martinpiper/BombJack/PiJack2/README.md

* This code is originally from these repos:
	https://github.com/fbergama/pigfx
	Specifically: https://github.com/fbergama/pigfx/tree/e4579a8653ec4d43ec5b5b94d9fd740d67e02359
	Needed https://github.com/rsta2/uspi/tree/2d6f33c6daa052137a0fe05bb74026d795b65b9e to be extracted to uspi\

* This is an attempt to use some bare metal code to try to service the GPIO pins quickly enough that all requests from the C64 can be captured in parallel, using the full 10 bits from the user port, without any extra latching logic.

* This code was used because it usefully demonstrates how to render to the screen and also service UART/GPIO signals in an interrupt.
* The plan is to strip the code, add specific C64 signal handling, and then incorporate emulated graphics display from the C64.

* Tweaks made from the versions in source control up to this version:
	Remove git command usage in "make.bat" and replace with:
	set GIT_DESCRIBE=1234567890
	set BUILD_VERSION=1234567890

* To build:

	"C:\Users\Martin Piper\Downloads\gcc-arm-none-eabi-10-2020-q4-major-win32\gcc-arm-none-eabi-10-2020-q4-major\bin\gccvar.bat"
	cd /d C:\work\BombJack\PiJack2
	Then...
	This will make all img files in bin\
	cls && makeall
	This makes a Pi0 compatible elf
	cls && make 1
	"c:\Program Files\qemu\qemu-system-arm.exe" -s -kernel pigfx.elf -cpu arm1176 -m 512 -M raspi0 -no-reboot -serial stdio -append ""
	"c:\Program Files\qemu\qemu-system-arm.exe" -s -kernel pigfx.elf -cpu arm1176 -m 512 -M raspi1ap -no-reboot -serial stdio -append ""

	This starts a qemu monitor on port 55555
	"c:\Program Files\qemu\qemu-system-arm.exe" -s -kernel pigfx.elf -cpu arm1176 -m 512 -M raspi0 -no-reboot -serial stdio -append "" -monitor tcp::55555,server,nowait

	To copy to the SD card, make sure it is NOT THE RECOVERY drive:
		copy bin\kernel.img g: /y
		copy bin\kernel.img f: /y
		
	Backup kernel.img files are in the backups folder.
	
	"binaryData.bin" is a large amount of data to send to the C64, bitmap and sound data basically
		See real_binary_binaryData_bin_start
		
	onPC2Rise should be sending a large chunk of binary data on _PC and reset the pointer on _PA2
	Note *InsertVolumeEvery* is an interleave data test because reading PIN_SERIALATN (or PIN_SP1) seems to be quite slow, so changes being sent are not received in sync with _PC, which lead to bitmap data reading some bytes of sample and vice versa.
		Corresponding interleaved data being sent is needed
			kBitmapDrawWidth = 22
			kBitmapDrawHeight = 16
		For each frame of data, use sDataCount:
			Every kBitmapDrawWidth skipping kBitmapDrawHeight, start of column, for 8 rows
			Then every 24 bytes for kBitmapDrawWidth*kBitmapDrawHeight*2
			Then for 24 samples
		>> As expected, sync issues, hard to predict what bytes need extra audio
			See: "// ????!!!!" The number is out by 1
	When the C64 is playing the video, there seems to be a momentary block of currupt video which then gets back in sync again. This happens at the same point regardless of the data.
		Is this a memory corruption in the linked binary? Calculate a CRC for the whole video data and display it on the Pi to find out.
		Otherwise it's a corruption happening while sending to the C64?

>> qemu and gpio emulation: https://cs.unibo.it/~davide.berardi6/post/20201204-1.html
	"Qemu offers a debug protocol, documented in [3], qtest." ...
>> https://stackoverflow.com/questions/60764018/how-to-connect-gpio-in-qemu-emulated-machine-to-an-object-in-host
>> https://phwl.org/2021/emulated-ARM-Linux-with-Buildroot-and-QEMU/

* TODO:
	* Done: Remember that the PS2 keyboard support needs to be removed, this is using the GPIO, so that code can be an example of how to read the GPIO directly
		handlePS2ClockEvent
		Note time_microsec()
		uart_buffer_start == uart_buffer_end
		Note GPIO code in initPS2
	* Done: Strip code, remove USPI as it isn't needed.
		Tested in QEmu
	* Done: Add simple code, one GPIO IRQ, to read values from C64, like in PiJack
	* Done: Store in volatile ring buffer, also like in PiJack
	* Done: Display on the terminal display
		Note: initialize_framebuffer(384, 264, 8);
	* Done: Validate that the screen can be updated quickly enough with the GPIO IRQ taking priority
	
	* Done: When the C64 is sending data and the display is rendering, only the top part of the screen is showing colour updates. The raster timing is consistent.
		This indicates the timing is off? but the screen redraw does update at 60 fps, the full screen of pixels is updated
		The data cache is invalidated between frames, and also when a byte arrives
		What is going in here? :)
		* "if (frameTime > 7285)" shows the problem on real hardware quite well. The split should be quite stable in the middle of the screen, however it is not...
			This indicates there is an issue with the timing of pixel writes and the number it can process
		* I think I'm going to capture a frame's worth of timed data from the C64 then draw the screen one frame behind instead
		* C64UserPort24Bit_getNext will need to return time captured and also have a filter time based on the current frameStartTime
			* It will need to capture raw time_microsec() for each event
			* Don't flush cache in gpio irq, instead flush caches just before rendering

	* Done: Add proper 32 bit user port interface return values, with incrementing address
	* Proper video rendering handling, port the java code...
		* Added DisplayBombJack.h
		* Note there is no libstdc++ so new won't work, neither will stack allocated class initialisation, so an explicit init() method is needed for each class
		** Eek, it looks like the code is updating the graphics too slowly... Is the cache off or something?
			Note: enable "// Debug enable the display and show some raster bars" then test the rendering speed on the real hardware compared to qemu...
				Added and enabled setup_cache(), no effect.
				Try: https://www.raspberrypi.org/forums/viewtopic.php?t=219212 , also no effect
	* Done: Strip PS2 and UART code
	* GPIO IRQ on separate higher priority core compared to the video rendering
	* Audio output over HDMI with background mixing IRQ on separate core compared to the GPIO IRQ core
	* Instead added: SIMPLE_MODE
		This just uses the terminal output mode and displays whatever the C64 sends. Example code in VideoHardware main7.a

* Bidirectional level shifter: https://www.sparkfun.com/products/12009

# PiGFX 
## Raspberry Pi graphics card / ANSI terminal emulator

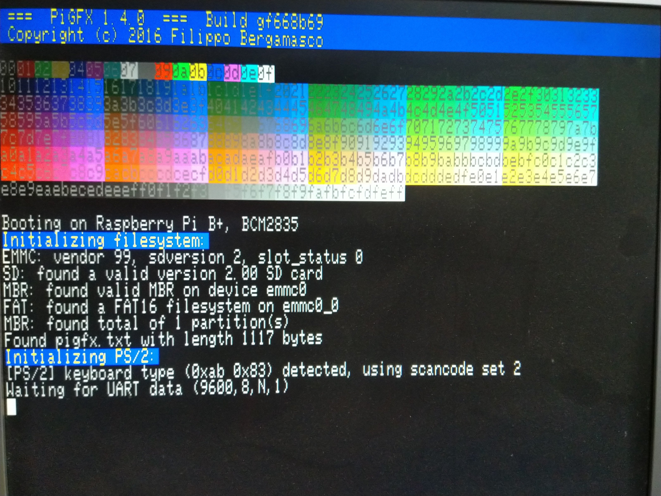
[picture p6: PiJack2/doc/scr1.jpg]


PiGFX is a bare metal kernel for the Raspberry Pi that implements a basic ANSI
terminal emulator with the additional support of some primitive graphics
functions. It can be driven by pushing characters to the raspi UART. Additional
functions like changing text color, moving the cursor or clear the screen can
be invoked via ANSI escape codes.  The result is that you can easily add an
HDMI display output to your embedded project without the hassle of directly
generate the video signal.

This work is inspired by [Spencer's
project](https://hackaday.io/project/9567-5-graphics-card-for-homebrew-z80)
that aims to create a cheap graphics card and keyboard interface to its
homebrew Z80 computer. PiGFX has the advantage of removing the fuss of having a
full-featured Linux system running on your raspi. This dramatically decreases
the boot time, lets the system be more customizable and, of course, adds a lot
of fun :) 

*UPDATE*: Thanks to the [uspi](https://github.com/rsta2/uspi) bare-metal USB
driver PiGFX now support an external USB keyboard as input device. Anything
typed will be automatically sent to raspi UART Tx0 (pin 8, GPIO 14).

*UPDATE*: (2018 Nov. by F. Pierot) Added display modes, fonts, tabulation set... See [2018 Nov. modifications](README_ADD.md).

*UPDATE*: (2020 by Ch. Lehner) Added new graphic features and configurable baudrate. Fixed some bugs. Ported to Raspberry Pi 2, 3 and 4. Also included the ability to read a config file on the SD card. Also added support for PS/2 keyboards.

By now this is a work in progress with a minimum set of features implemented so
expect that more functionalities will be added from time to time.

PiGFX should be working on all Pi models from generation 1 to generation 4. However there is no USB support on the model 4. It's tested on the following models:

- Pi Zero
- Pi Zero W
- Pi B
- Pi B+
- Pi 2B
- Pi 3B
- Pi 4B

Here is a preliminary TODO list of what I plan to add in the future:

- ✔ Add support for USB or Ps2 keyboard
- ✔ Add some graphics primitives like lines
- ✔ Add some more graphics primitives (circles, rectangles etc.)
- ✔ Let the resolution being configurable without recompiling
- ✔ Port to Raspberry Pi Generation 2/3/4
- ✔ Load configuration from SD card
- ✔ Support for PS/2 keyboard
- ✔ Implement some kind of sprite handling with collision detection
- Implement double buffering
- Load bitmap fonts directly from the SD card
- Implement a 8bit interface
- Support for USB / PS/2 Mouse

## How to run

1. Format an SD-card: you need one 1 GB partition using the FAT or FAT32 system. 
Other formats won't boot, and a bigger size is useless. Avoid 64GB+ cards as 
they tend to cause problems to PI. A 32GB or 16GB card is ok as long as you 
format only 1 or 2 GB with FAT or FAT32.

2. Copy all ```bin/*.img``` to the root of the SD card along with the files
   ```start.elf```, ```start4.elf``` and ```bootcode.bin``` that are commonly [distributed with
the Raspberry Pi](https://github.com/raspberrypi/firmware/tree/master/boot).

3. Copy ```bin/pigfx.txt``` to the root of the SD card. Edit the file for your
   needs. If you have a config.txt on the SD card, delete it.

4. Insert the card and reboot the Pi.

As soon as your raspi is turned on, the boot screen and other informations 
should be displayed as a 640x480 @ 60hz video stream from the HDMI interface. 
After that, PiGFX awaits anything coming from the serial line. Any data
received from the UART is immediately displayed in a terminal-like fashion (ie.
it automatically scrolls once you reach the bottom of the screen, etc.).

You may need to reset your computer before PiGFX displays anything coming from it.
 
### Test inside QEMU

PiGFX can be emulated with [QEMU](http://wiki.qemu.org/Main_Page). Just
download/compile/install the [rpi Torlus
branch](https://github.com/Torlus/qemu/tree/rpi) and launch 

```
$ make run
```

in the PiGFX root folder.

## UART Physical connection

|Pin   | Function
|---   |---
|8     | UART Tx0 (GPIO 14).  Keyboard output
|10    | UART Rx0 (GPIO 15). Connect this pin to your device transmit pin.

***Note: Please be aware that all Raspberry Pi models accept levels between 0 and 3v3. Be sure to provide an appropriate level shifter to match your output***

UART communication expects the baudrate configured in pigfx.txt, 8 bit data, 1 bit
stop and no parity.

## PS/2 keyboard
Be aware that USB support is disabled, if a PS/2 keyboard is detected during boot. This increases boot time a lot.

### Physical connection to the Pi
This is the male connector at the keyboard cable.
<img src="doc/ps2.jpg" width="30%" />
<img src="doc/gpio.png" width="80%" />

Most keyboards seem to work if powered with 3.3V. However if your keyboard does not and needs 5V, make sure you use a bidirectional level shifter between the Raspberry Pi and your keyboard on data and clock. If you bring 5V to the GPIO you will destroy the Pi.

|PS/2 Pin |Pi Pin | Function
|-------  |-----  |---------
|1        |3      | PS/2 Data (GPIO 2)
|3        |9      | Ground
|4        |1      | Power to keyboard
|5        |5      | PS/2 Clock (GPIO 3)

## Terminal ANSI Codes

The following escape sequences can be used to further control the terminal
behaviour

|Code                  | Command
|---                   | ---
| \ESC[?25l           | Cursor invisible
| \ESC[?25h           | Cursor visible
| \ESC[H              | Move to 0-0
| \ESC[s              | Save the cursor position 
| \ESC[u              | Move cursor to previously saved position 
| \ESC[-Row-;-Col-H   | Move to -Row-,-Col-
| \ESC[0K             | Clear from cursor to the end of the line
| \ESC[1K             | Clear from the beginning of the current line to the cursor 
| \ESC[2K             | Clear the whole line 
| \ESC[2J             | Clear the screen and move the cursor to 0-0 
| \ESC[-n-A           | Move the cursor up -n- lines
| \ESC[-n-B           | Move the cursor down -n- lines
| \ESC[-n-C           | Move the cursor forward -n- characters
| \ESC[-n-D           | Move the cursor backward -n- characters
| \ESC[0m             | Reset color attributes (white on black) 
| \ESC[38;5;-n-m      | Set foreground color to -n- (0-255) 
| \ESC[48;5;-n-m      | Set background color to -n- (0-255) 

Where ```\ESC``` is the binary character ```0x1B``` and ```-n-```,
```-Row-```, ```-Col-``` is any sequence of numeric characters like ```123```.

Additionally, PiGFX implements the following custom codes:

Code                              | Command
---                               | ---
| \ESC[#-x0-;-y0-;-x1-;-y1-l     | Draw a line from -x0-;-y0- to -x1-;-y1-
| \ESC[#-x0-;-y0-;-x1-;-y1-r     | Fill a rectangle with top-left corner at -x0-;-y0- and bottom-right at -x1-;-y1-

See [terminal_codes](doc/terminal_codes.txt) for a complete list of supported commands.

## Color palette

See [Here](https://en.wikipedia.org/wiki/File:Xterm_256color_chart.svg) for a
reference of the provided xterm color palette. This is the default palette used by PiGFX.

A RGB pixel can be converted to this palette by the following formula:

Pixel = 16 + (round(R / 255 * 5) * 36) + (round(G / 255 * 5) * 6) + round(B / 255 * 5)

Using a different color palette is possible. It can be switched with a control code, see [terminal_codes](doc/terminal_codes.txt).

Possible palettes are Xterm, VGA and C64. PiGFX always uses 256 colors, so the unused colors in a palette remain black.

It's also possible to load a custom color palette with a specific control code.

## Bitmap handling
A maximum of 128 bitmaps can be loaded to the PiGFX, either as list of binary pixels, list of ASCII decimal encoded pixels or list of ASCII hex encoded pixels. All of these can be RLE compressed. Loaded bitmaps can then be put onto the background. A transparent color can be specified before drawing a bitmap, these pixels won't be drawn in transparent mode. RLE compression expects a list of 2 values: first one is the pixel color, second one is the number of pixels to draw with this color.

See [terminal_codes](doc/terminal_codes.txt) for the specific commands.

There are a few examples in [this directory](sprite/sample). 

## Sprite handling

Once a bitmap is loaded, it can be used to draw a maximum of 256 sprites. A sprite is an object which is movable over the background. If a sprite is moved or removed, the previous background gets restored. If the sprite is manipulated by a bitmap or a different sprite, this state remains until it gets moved or removed. The sprite is then redrawn and the previous background restored. Moving a sprites, which is overlaped by another leads to artefacts.

Sprites can be drawn solid or with a transparent color. A drawn sprite keeps its settings (solid/transparent) and even the tranparent color until it gets removed.

Once a sprite is active, you should not manipulate or reload its bitmap source, otherwise the sprite changes to this new bitmap source if it gets moved.

Animations could be realized by redefining the sprite with a different bitmap source.

There's a [example](shapes/sample/anim_dinos.txt) for a moving dinosaur (after first loading them in hex or binary).

## Graphics performance

Since we have cache enabled now on the Pi, the speed is more or less the same on every model. In most cases it's probably faster to not enable DMA.

Graphics which are drawn on a multiple of 4 pixels x-position draw faster than on a multiple of 2 or 1. You will also get more speed if your image has a width of a multiple of 4. Drawing solid is faster than drawing transparent.

This is a table that shows the time for drawing a 400x300 pixel image on different x-positions. This is an example for getting an idea.

|Pi Gen.  |Aligned 4 px |Aligned 2 px |unaligned |DMA enabled
|-------  |------------ |------------ |--------- |-----------
|1 (zero) |4.7ms        |9.3ms        |10.5ms    |3.9ms
|2        |1.9ms        |2.1ms        |2.6ms     |5.2ms
|3        |2.2ms        |2.7ms        |3.8ms     |5.2ms
|4        |0.9ms        |1.6ms        |3.3ms     |4.9ms

## Collision detection

At the time a sprite is defined, the borders of the sprite are used for detecting collisions with other sprites, so this is always a rectangle. A collision is reported if 2 sprites touch or overlap. Collisions with lower sprite indexes are detected first.

Collision detection takes place at the time a sprite is defined or moved. This sprite is checked against all other active sprites. All detected collisions are reported.

A collision is reported as a keyboard input with this syntax: \ESC[#-idx1-;-idx2-c where -idx1- is the sprite index you just defined or moved and -idx2- is the sprite it collides with.

## Compiling on Mac / Linux

To compile you will need to install a GNU ARM cross compiler toolchain and
ensure that  ```arm-none-eabi-gcc```, ```arm-none-eabi-as```
```arm-none-eabi-ld``` and ```arm-none-eabi-objcopy``` are in your PATH.

At this point, just run:

```
$ ./makeall
```

in the PiGFX root directory. The project should compile with the 2019 version
of the toolchain.

## Compiling on Windows

To compile you will need to install a [GNU ARM cross compiler toolchain](https://developer.arm.com/tools-and-software/open-source-software/developer-tools/gnu-toolchain/gnu-rm/downloads) and
ensure that  ```arm-none-eabi-gcc```, ```arm-none-eabi-as```
```arm-none-eabi-ld``` and ```arm-none-eabi-objcopy``` are in your PATH.

You'll also need the [git executable git.exe](https://git-scm.com/download/win) in your PATH.

At this point, just run:

```
> makeall
```

## License

The MIT License (MIT)

Copyright (c) 2016-2020 Filippo Bergamasco.

Permission is hereby granted, free of charge, to any person obtaining a copy
of this software and associated documentation files (the "Software"), to deal
in the Software without restriction, including without limitation the rights
to use, copy, modify, merge, publish, distribute, sublicense, and/or sell
copies of the Software, and to permit persons to whom the Software is
furnished to do so, subject to the following conditions:

The above copyright notice and this permission notice shall be included in
all copies or substantial portions of the Software.

THE SOFTWARE IS PROVIDED "AS IS", WITHOUT WARRANTY OF ANY KIND, EXPRESS OR
IMPLIED, INCLUDING BUT NOT LIMITED TO THE WARRANTIES OF MERCHANTABILITY,
FITNESS FOR A PARTICULAR PURPOSE AND NONINFRINGEMENT. IN NO EVENT SHALL THE
AUTHORS OR COPYRIGHT HOLDERS BE LIABLE FOR ANY CLAIM, DAMAGES OR OTHER
LIABILITY, WHETHER IN AN ACTION OF CONTRACT, TORT OR OTHERWISE, ARISING FROM,
OUT OF OR IN CONNECTION WITH THE SOFTWARE OR THE USE OR OTHER DEALINGS IN
THE SOFTWARE.
