martinpiper/BombJack/original/Bottom.jpg

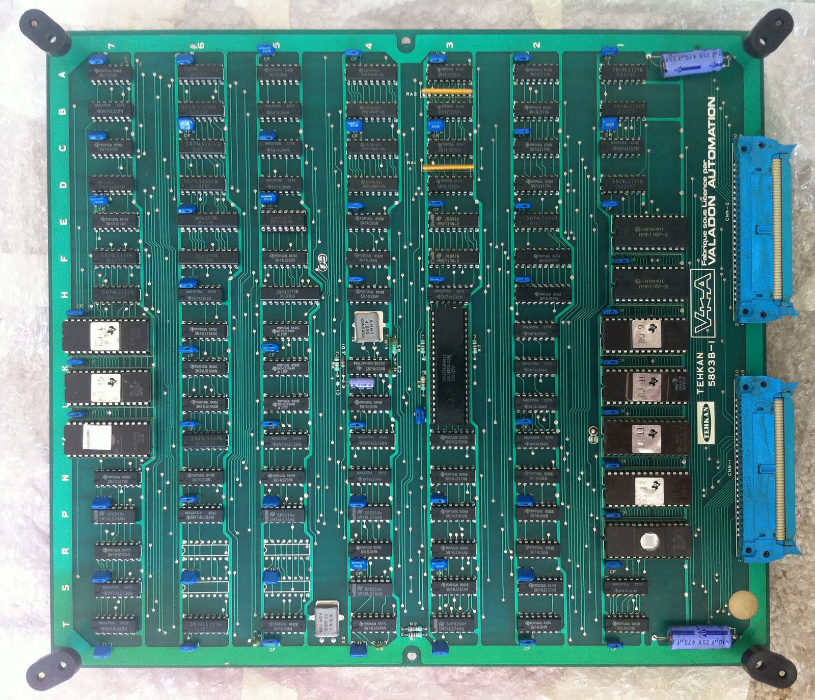
original/Bottom.jpg
