martinpiper/BombJack/original/C64A2D-D2A-Layout.jpg

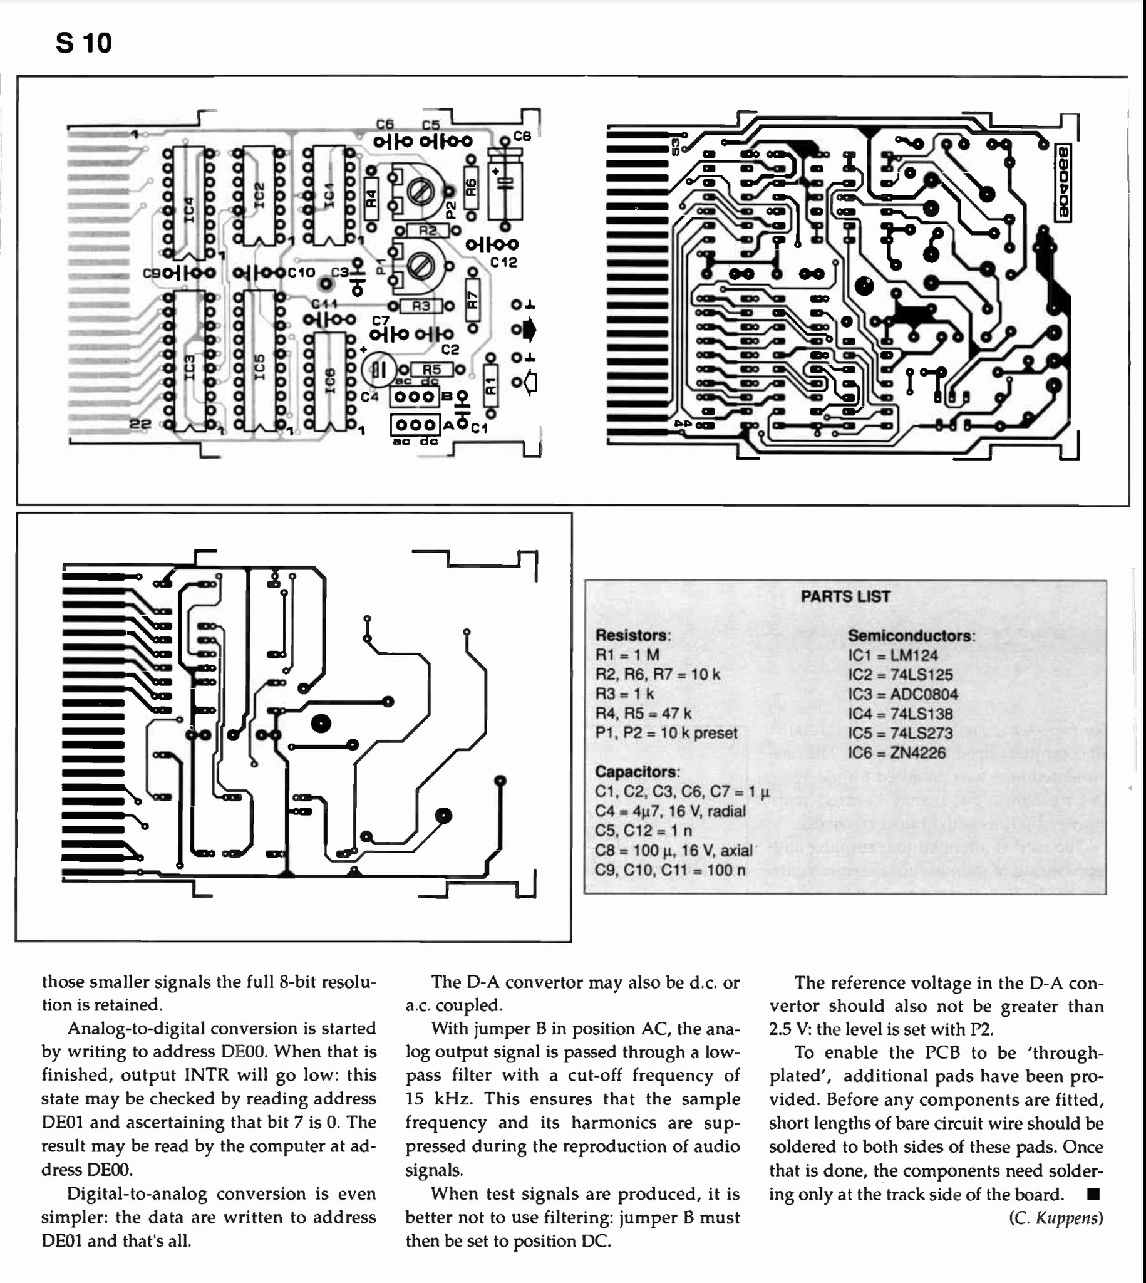
original/C64A2D-D2A-Layout.jpg
