martinpiper/BombJack/original/C64A2D-D2A-Schematic.jpg

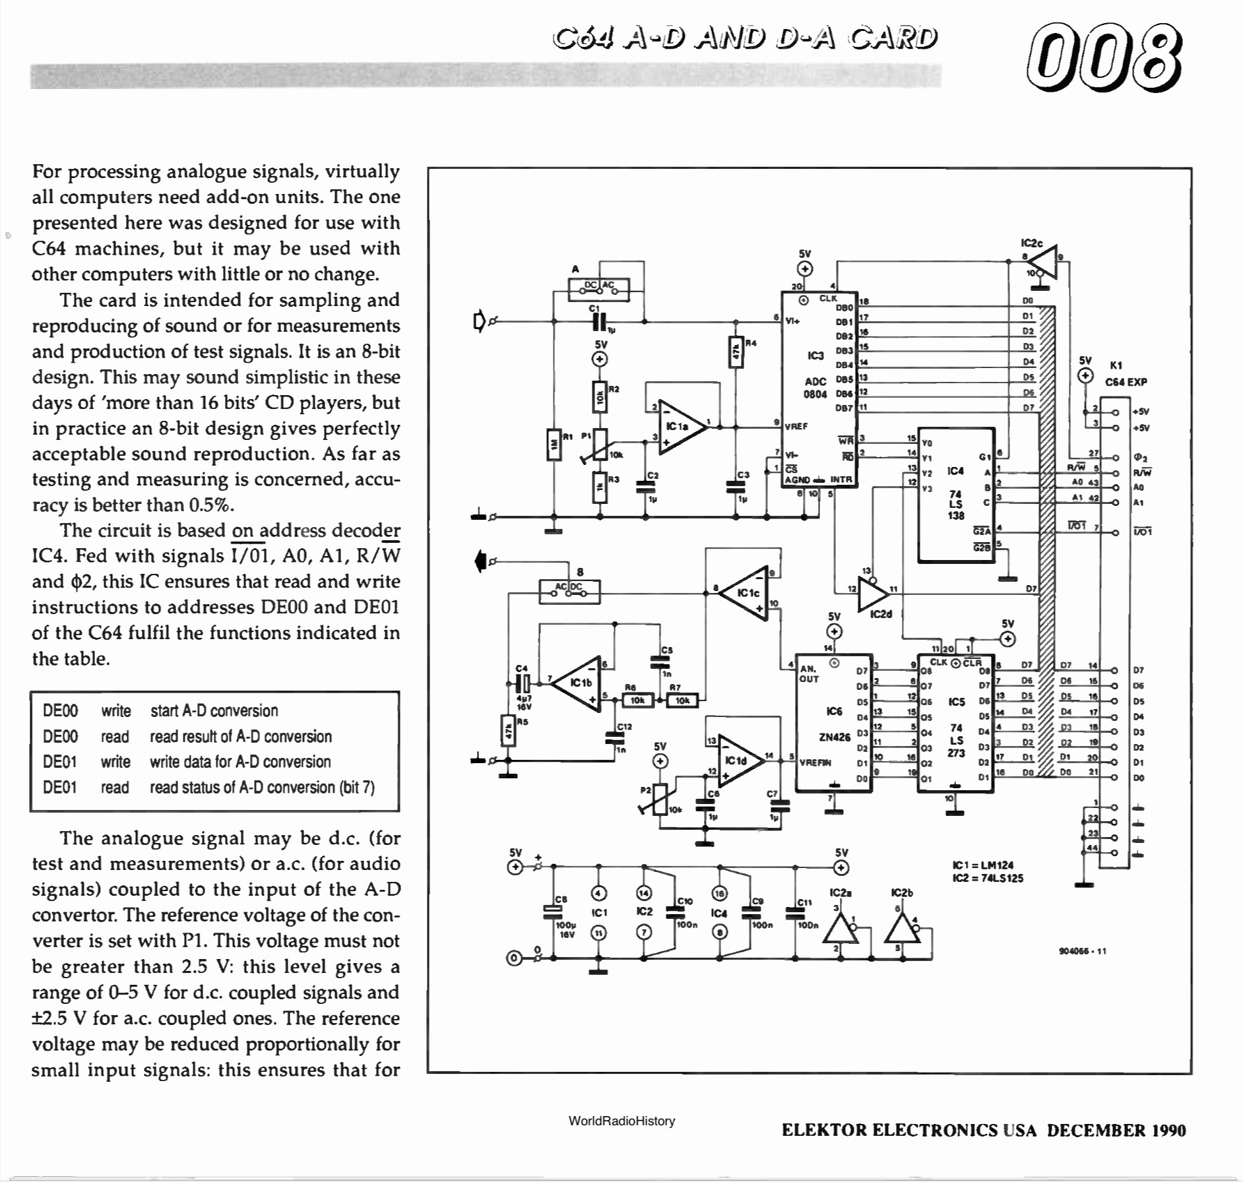
original/C64A2D-D2A-Schematic.jpg
