martinpiper/BombJack/original/Top.jpg

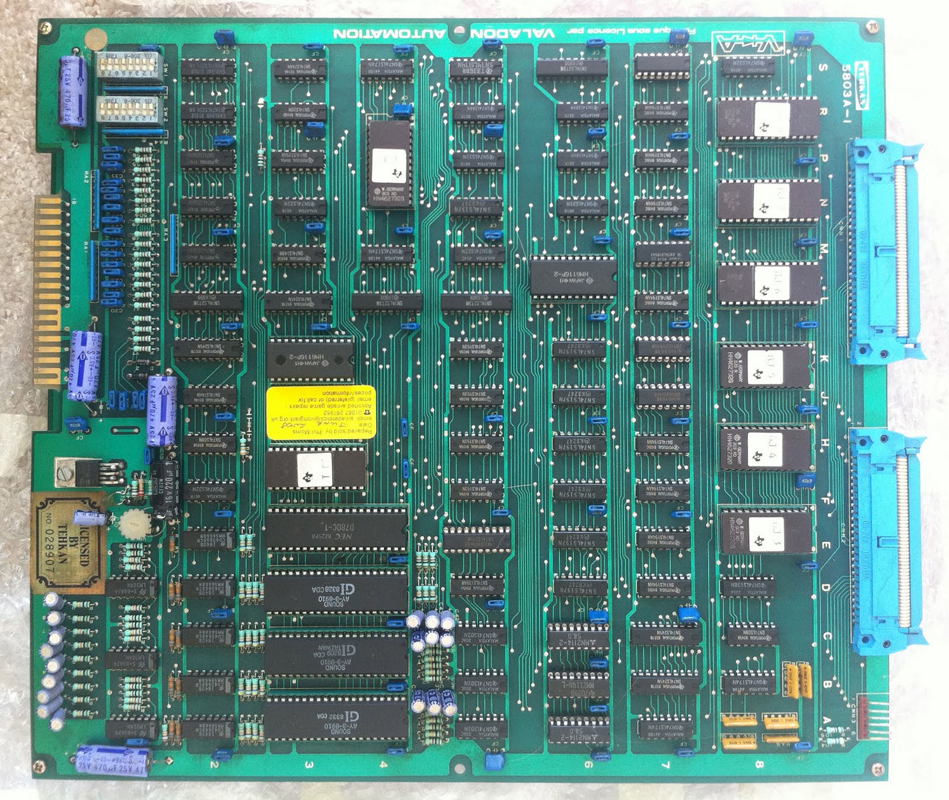
original/Top.jpg
