martinpiper/BombJack/Root sheet 5 with 6116 RAM for sprite spans.PNG

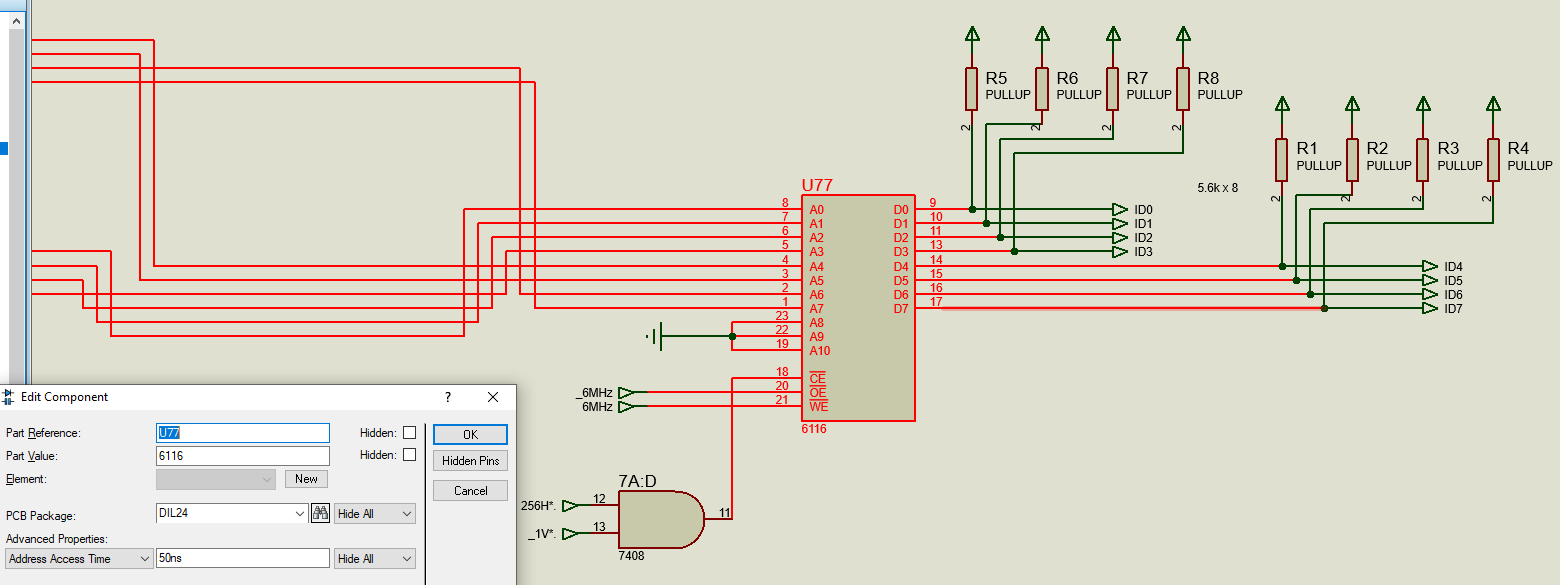
Root sheet 5 with 6116 RAM for sprite spans.PNG
