martinpiper/BombJack/Sprites4 V11.0 and V11.1 comparison.png

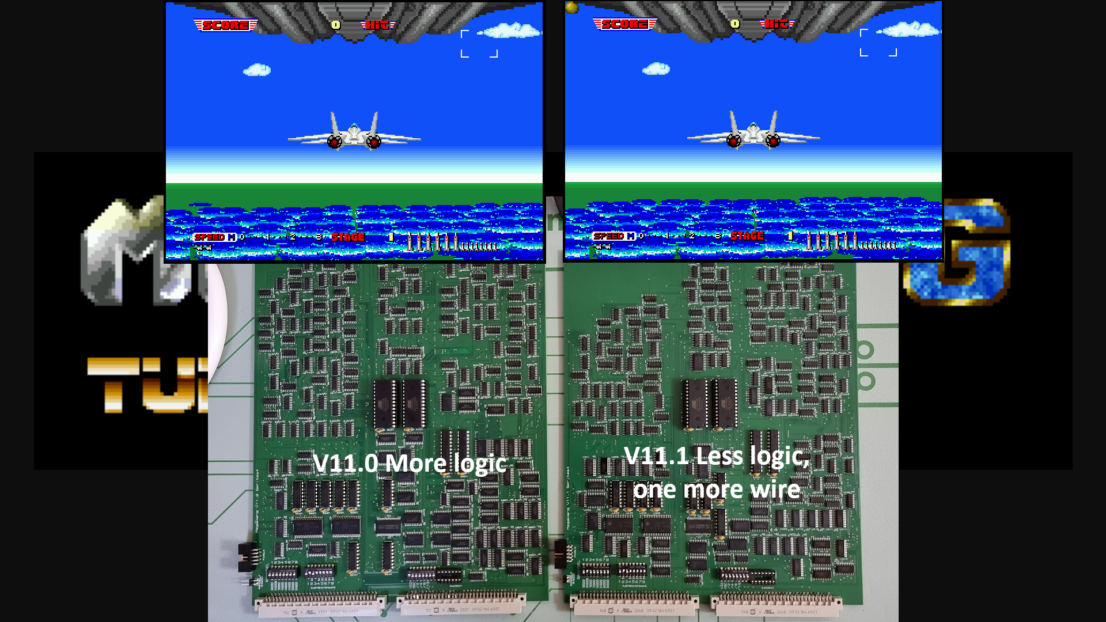
Sprites4 V11.0 and V11.1 comparison.png
