martinpiper/BombJack/StableSpriteScanAddress.PNG

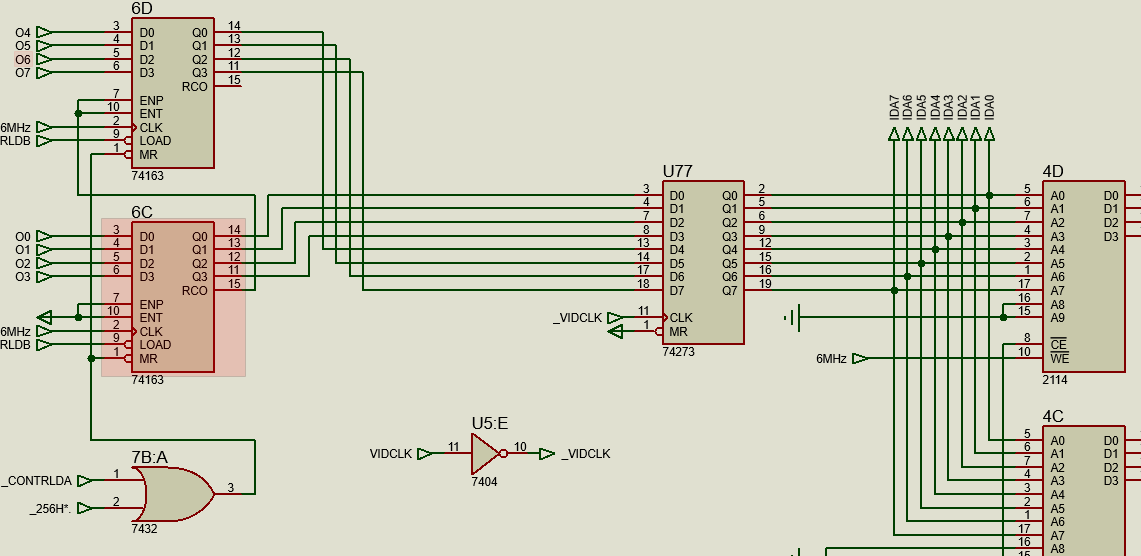
StableSpriteScanAddress.PNG
