martinpiper/BombJack/TC-17-000325.bmp

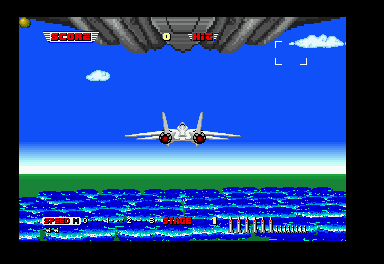
TC-17-000325.bmp
