martinpiper/BombJack/HardwarePurchase.md

Hardware Purchase
=================

Buying the hardware
===================

I plan to make the PCBs available from PCBWay: https://www.pcbway.com/project/member/shareproject/?bmbno=DA7C53B3-370F-46

The below prices are for the through hole PCBs. The SMT PCBs are smaller and cheaper, prices to be confirmed.

Are you sure you want to buy the hardware?

| Item													| US$		|
|---|---|
| PCBs with sockets, connectors, and passive components | 4241		|
| Remaining components ICs, cables, etc					| 905		|
| Board population, testing, fix-up						| 150		|
| Postage | 350  		|
| *Total:*												| *5646*	|

Important considerations
========================

* Once the purchase is made *it cannot be cancelled or refunded once fabrication is requested* because you are buying a hand made one-off bespoke solution
* It takes at least 30 days, after the money is received, for populated PCBs to be delivered
* Delivery of remaining components can also take 10 days, assuming there is stock
* Construction and testing can take 5 days
* Delivery can take 10 days
