martinpiper/BombJack/V2.0/Bill Of Materials Bomb Jack.pdf

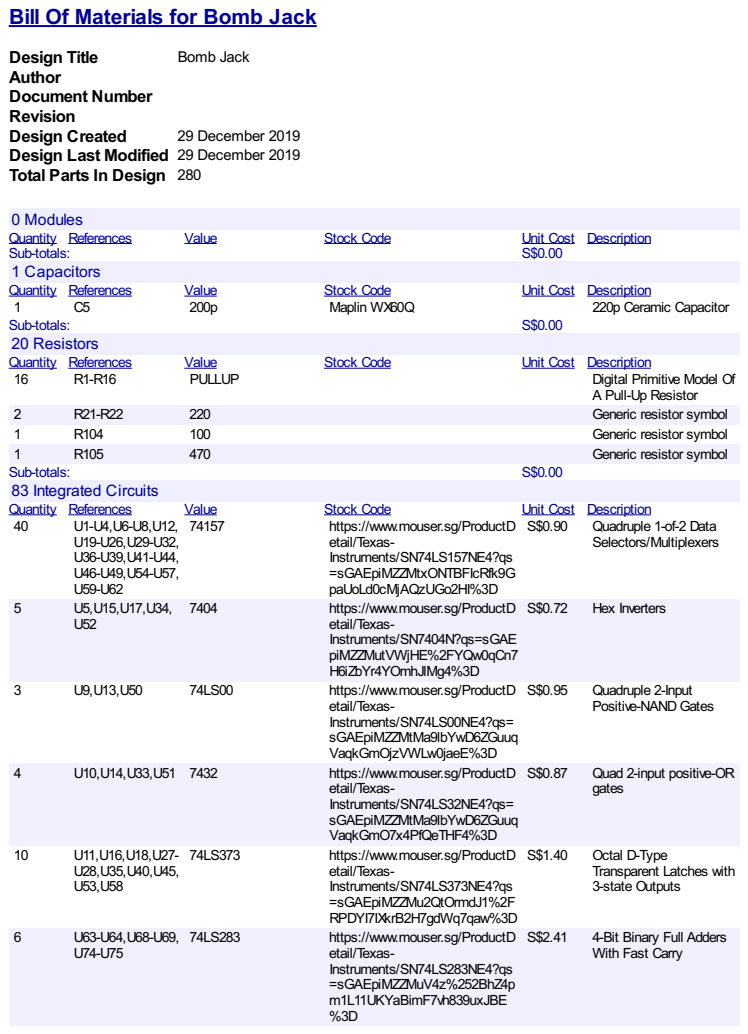
[picture p15: page 1]

Bill Of Materials for Bomb Jack

Author
Document Number
Revision
Design Last Modified 29 December 2019
Total Parts In Design 280

5 | U5,U15,U17,U34, | | 7404 | https://www.mouser.sg/ProductD | S$0.72 | Hex Inverters

U52 | | etail/Texas-

4 | U10,U14,U33,U51 | | 7432 | https://www.mouser.sg/ProductD | S$0.87 | Quad 2-input positive-OR

etail/Texas- | | gates

6 | U63-U64,U68-U69, | 74LS283 | https://www.mouser.sg/ProductD | | S$2.41 | 4-Bit Binary Full Adders

U74-U75 | | etail/Texas- | | With Fast Carry

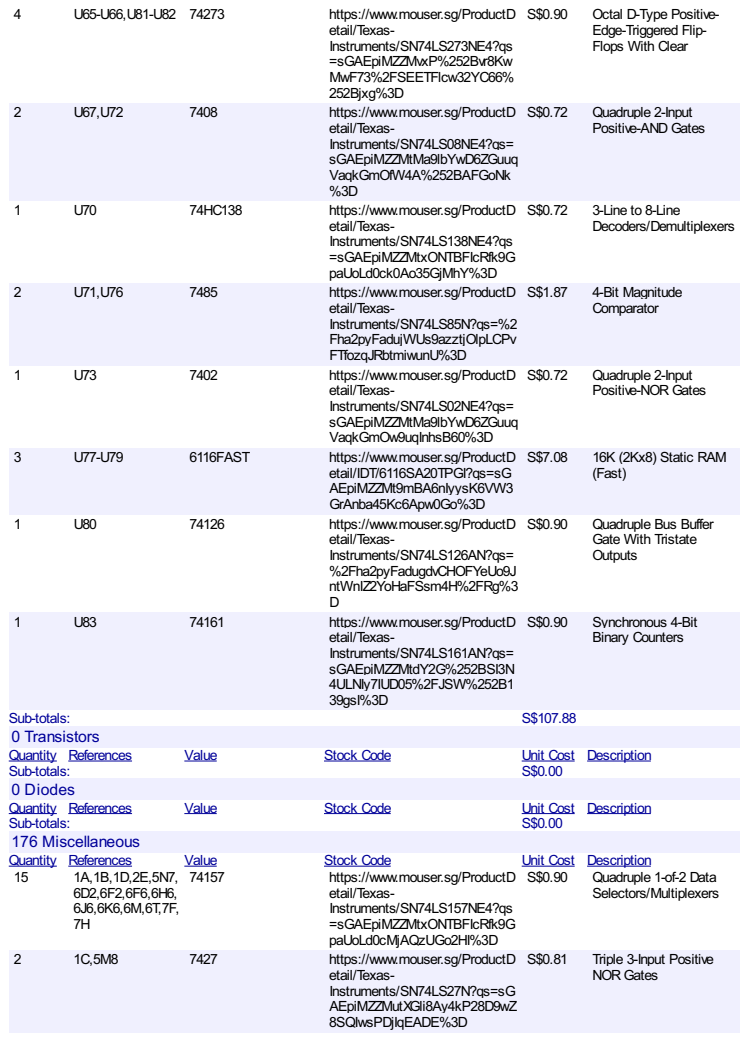
[picture p16: page 2]

2 | U67,U72 | | 7408 | https://www.mouser.sg/ProductD | S$0.72 | Quadruple 2-Input

etail/Texas- | | Positive-ANDGates

2 | U71,U76 | | 7485 | https://www.mouser.sg/ProductD | S$1.87 | 4-Bit Magnitude

etail/Texas- | | Comparator

1 | U83 | | 74161 | https://www.mouser.sg/ProductD | S$0.90 | Synchronous 4-Bit

etail/Texas- | | Binary Counters

2 | 1C,5M8 | | 7427 | https://www.mouser.sg/ProductD | S$0.81 | Triple 3-Input Positive

etail/Texas- | | NORGates

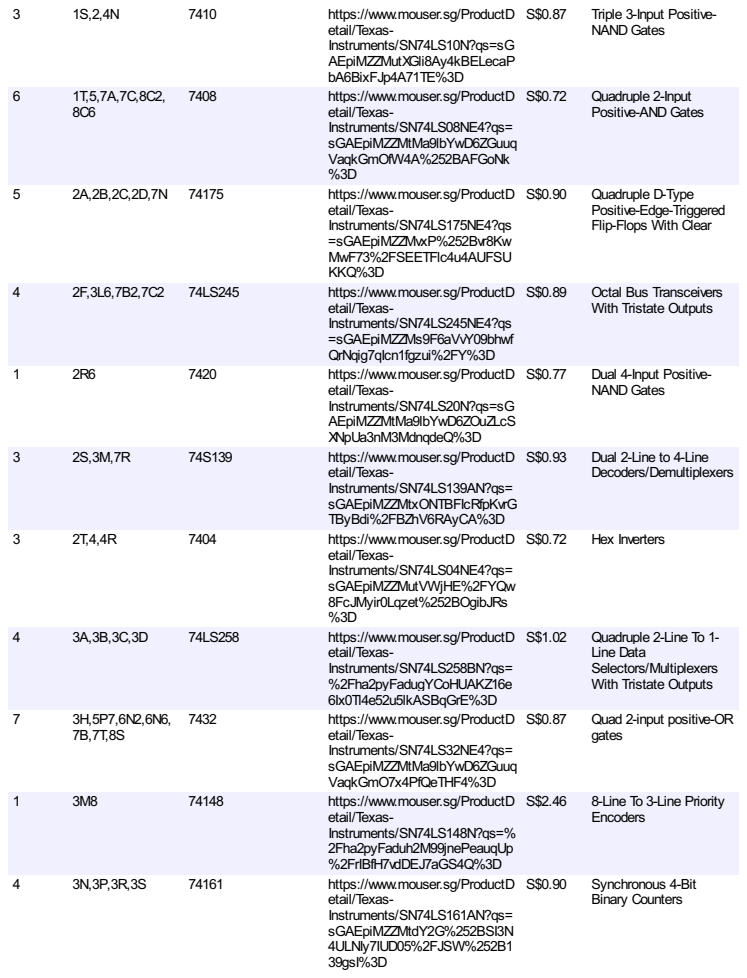
[picture p17: page 3]

6 | 1 T,5,7A,7 C,8 | | 74 0 8 | h t t p s:/ / www.m o u s e r.s g/ P ro d u c t D | S $ 0.7 2 | Q u a d ru ple 2 -In p u t

et ail/ Tex a s | | P o sitive -A N D G at e s

4 | 2 F,3 L6,7 B 2,7 C2 | | 74 L S 24 5 | h t t p s:/ / www.m o u s e r.s g/ P ro d u c t D | S $ 0.8 9 | Oc t al B u s Tra n s c eive rs

et ail/ Tex a s | | Wit h Tris t at e O u t p u t s

3 | 2 S,3 M,7 R | | 74 S 1 3 9 | h t t p s:/ / www.m o u s e r.s g/ P ro d u c t D | S $ 0.9 3 | D u al 2 -Lin e t o 4 -Lin e

et ail/ Tex a s | | De c o d e rs / De m ultiplex e rs

4 | 3A,3 B,3 C,3 D | | 74 L S 2 5 8 | h t t p s:/ / www.m o u s e r.s g/ P ro d u c t D | $ S 1.0 2 | Q u a d ru ple 2 -Lin e To 1 -

et ail/ Tex a s | | Lin e Dat a

1 | 3 M 8 | | 74 1 4 8 | h t t p s:/ / www.m o u s e r.s g/ P ro d u c t D | $ S 2.4 6 | 8 -Lin e To 3 -Lin e P rio rit y

et ail/ Tex a s | | E n c o d e rs

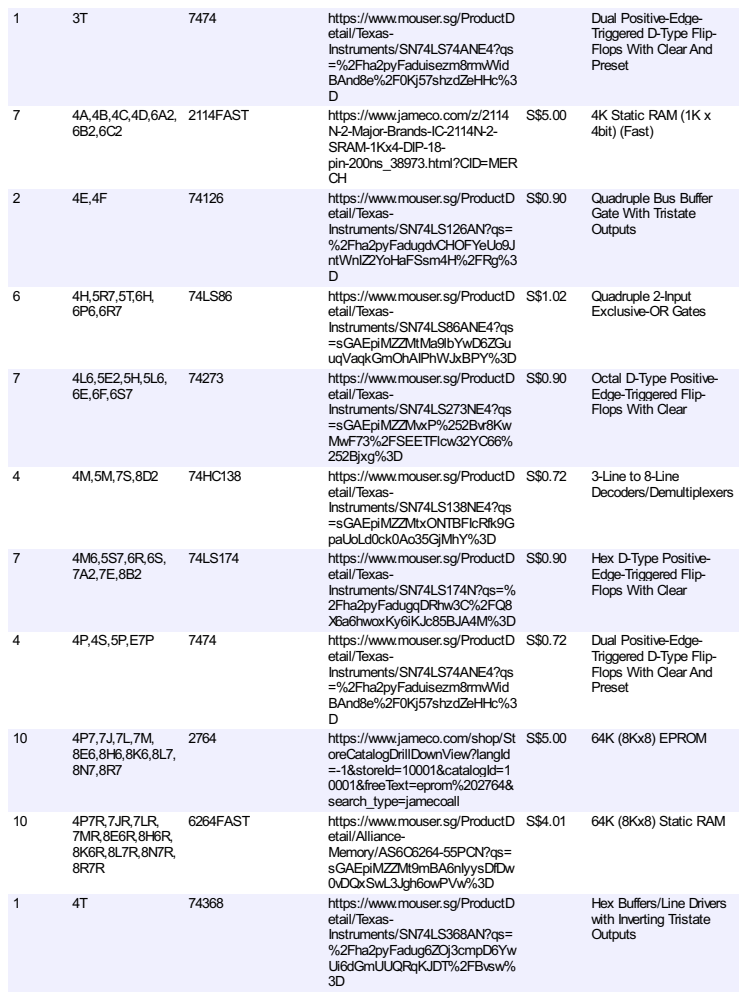
[picture p18: page 4]

2 | 4 E,4 F | | 74 1 2 6 | h t t p s:/ / www.m o u s e r.s g/ P ro d u c t D | $ S 0.9 0 | Q u a d ru ple B u s B u ffe r

et ail/ Tex a s | | G at e Wit h Tris t at e

7 | 4 L6,5 E 2,5 H,5 | | 74 2 7 3 | h t t p s:/ / www.m o u s e r.s g/ P ro d u c t D | $ S 0.9 0 | Oc t al D-Ty p e P o sitive -

et ail/ Tex a s | | E d g e -Trig g e re d Flip -

7 | 4 M 6,5 S 7,6 R,6 | | 74 L S 1 74 | h t t p s:/ / www.m o u s e r.s g/ P ro d u c t D | $ S 0.9 0 | H ex D-Ty p e P o sitive -

1 | 4 T | | 74 3 6 8 | h t t p s:/ / www.m o u s e r.s g/ P ro d u c t D | H ex B u ffe rs / Lin e D rive rs

et ail/ Tex a s | | wit h In ve rtin g Tris t at e

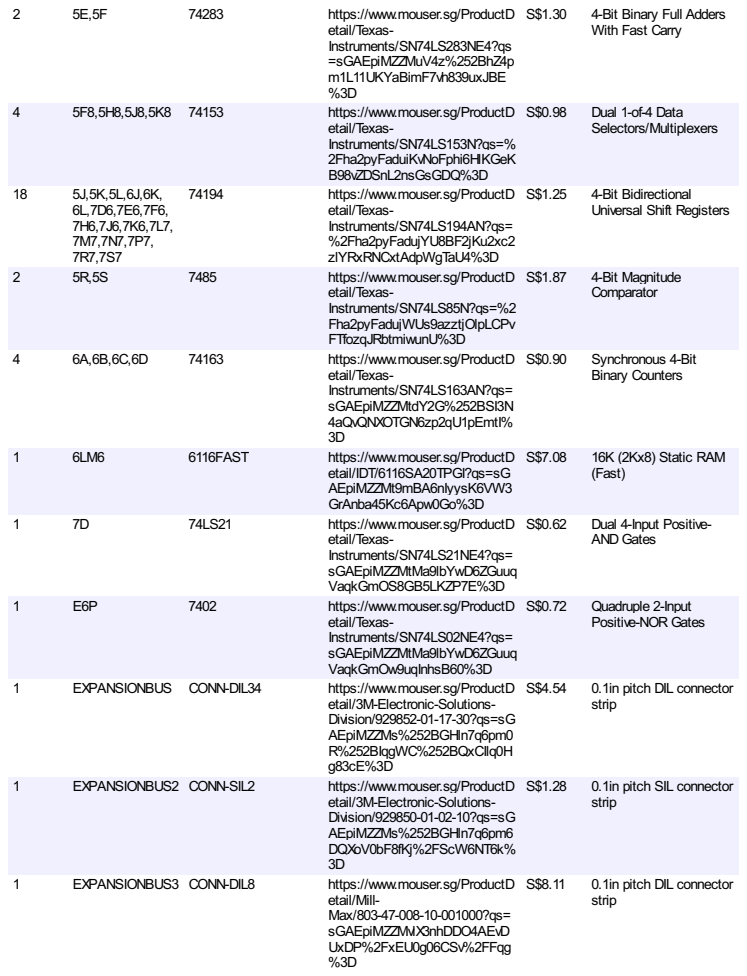
[picture p19: page 5]

4 | 5 F 8,5 H 8,5 J 8,5 K8 | | 74 1 5 3 | h t t p s:/ / www.m o u s e r.s g/ P ro d u c t D | $ S 0.9 8 | D u al 1 -of-4 Dat a

et ail/ Tex a s | | S ele c t o rs / M ultiplex e rs

al Universal Shift Re

2 | 5 R,5 S | | 74 8 5 | h t t p s:/ / www.m o u s e r.s g/ P ro d u c t D | $ S 1.8 7 | 4 -Bit M a g nit u d e

et ail/ Tex a s | | Co m p a rat o r

1 | E 6 P | | 74 0 2 | h t t p s:/ / www.m o u s e r.s g/ P ro d u c t D | $ S 0.7 2 | Q u a d ru ple 2 -In p u t

et ail/ Tex a s | | P o sitive -N O R G at e s

1 | E XP A N SIO N B U S 2 | CO N N -SIL2 | h t t p s:/ / www.m o u s e r.s g/ P ro d u c t D | $ S 1.2 8 | 0.1in pit c h SIL c o n n e c t o r

et ail/ 3 M -Ele c t ro nic -S olu tio n s - | | s t rip

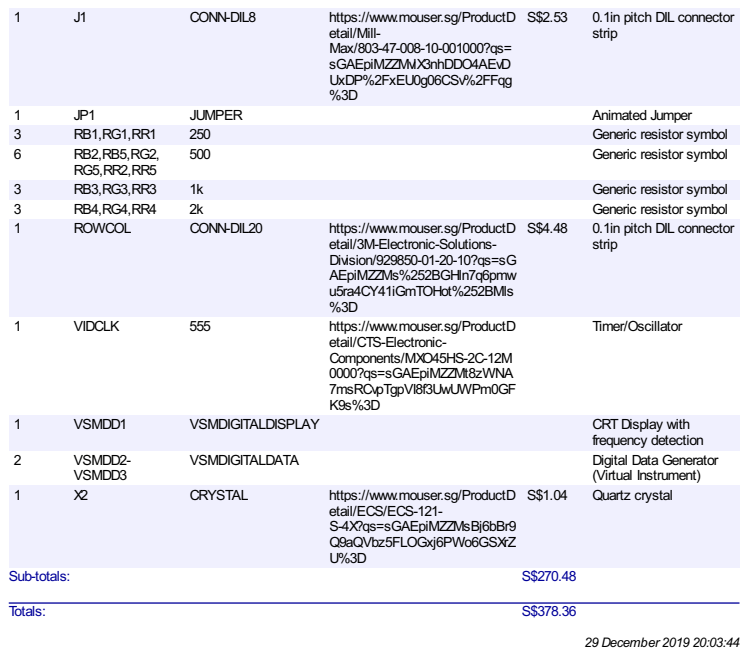
[picture p20: page 6]

1 | J1 | | CONN-DIL8 | https://www.mouser.sg/ProductD | S$2.53 | 0.1in pitch DIL connector

etail/Mill- | | strip

1 | ROWCOL | | CONN-DIL20 | https://www.mouser.sg/ProductD | S$4.48 | 0.1in pitch DIL connector

etail/3M-Electronic-Solutions- | | strip
