martinpiper/BombJack/Order clarifications/CL05B104KO5NNNC-SDC-board.png

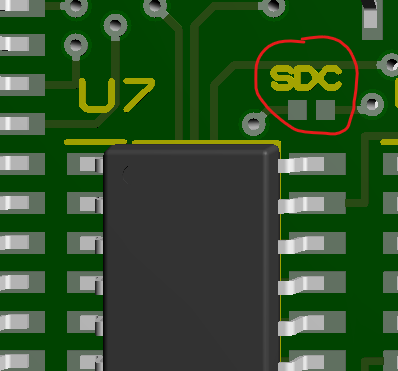
Order clarifications/CL05B104KO5NNNC-SDC-board.png
