martinpiper/BombJack/Order clarifications/CONN-SIL2-BANKSEL header.png

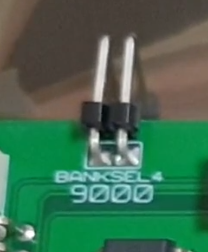
Order clarifications/CONN-SIL2-BANKSEL header.png
