martinpiper/BombJack/Order clarifications/K104K15X7RF53H5-DC-board.png

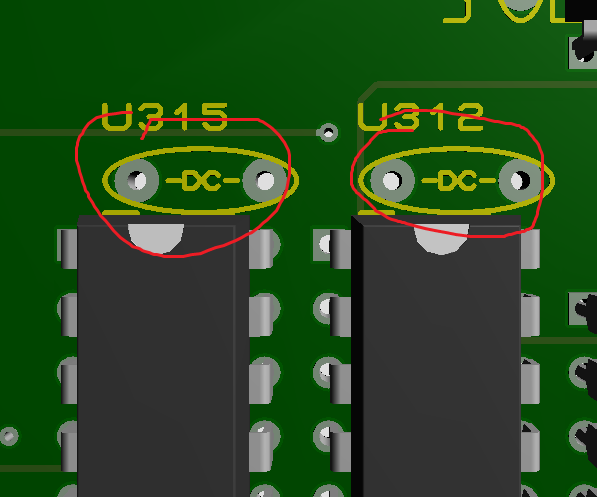
Order clarifications/K104K15X7RF53H5-DC-board.png
