martinpiper/BombJack/Order clarifications/K104K15X7RF53H5-DC-gerber.png

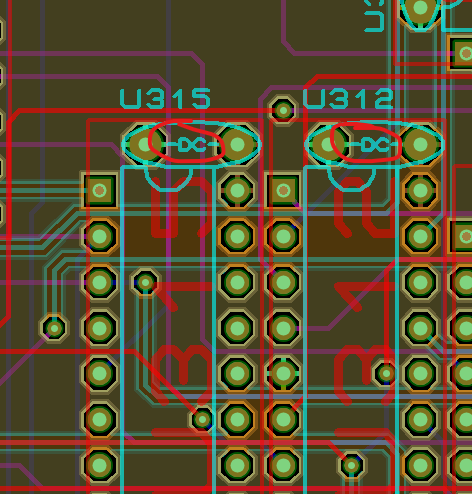
Order clarifications/K104K15X7RF53H5-DC-gerber.png
