martinpiper/BombJack/Order clarifications/K104K15X7RF53H5-Example decoupling capacitor at holes marked with -DC.jpg

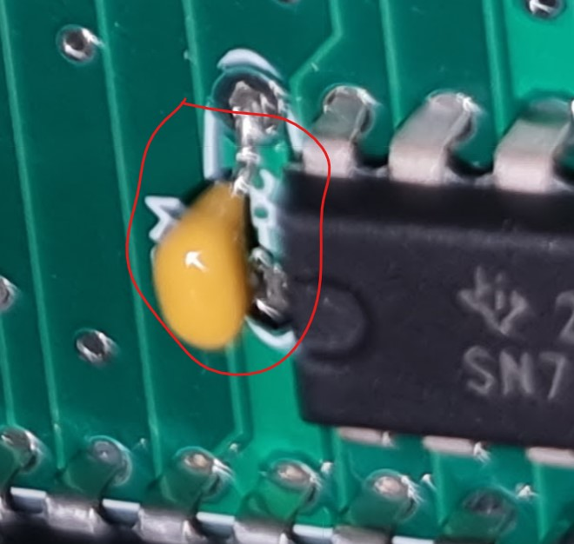
Order clarifications/K104K15X7RF53H5-Example decoupling capacitor at holes marked with -DC.jpg
