martinpiper/BombJack/Order clarifications/09021642922 solder side orientation 2.png

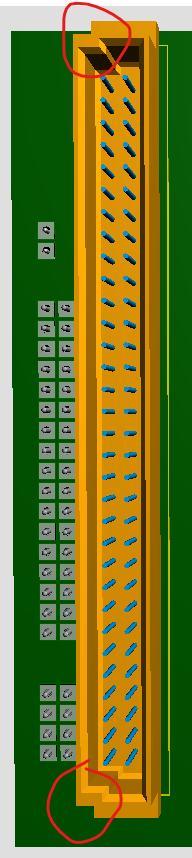
Order clarifications/09021642922 solder side orientation 2.png
