martinpiper/BombJack/testdata/toMatchTestAPU2.txt

;
w$
d$40000261
d$40010201
d$400202f8
d$40030201
d$40040200
d$40050298
d$40060200
d$40070201
d$40080202
d$40090203
d$400a0204
d$400b0205
d$400c0206
d$400d0207
d$400e0208
d$400f0209
d$4010020a
d$4011020b
d$4012020c
d$4013020d
d$4014020e
d$4015020f
d$40160200
d$40170201
d$40180202
d$40190203
d$401a0204
d$401b0205
d$401c0206
d$401d0207
d$401e0208
d$401f0209
d$4020020a
d$4021020b
d$4022020c
d$4023020d
d$4024020e
d$4025020f
d$40260200
d$40270201
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
d$40aa0204
d$40ab0205
d$40ac0206
d$40ad0207
d$40ae0208
d$40af0209
d$40b0020a
d$40b1020b
d$40b2020c
d$40b3020d
d$40b4020e
d$40b5020f
d$40b60200
d$40b70201
d$40b80202
d$40b90203
d$40ba0204
d$40bb0205
d$40bc0206
d$40bd0207
d$40be0208
d$40bf0209
d$40c0020a
d$40c1020b
d$40c2020c
d$40c3020d
d$40c4020e
d$40c5020f
d$40c60200
d$40c70201
d$40c80202
d$40c90203
d$40ca0204
d$40cb0205
d$40cc0206
d$40cd0207
d$40ce0208
d$40cf0209
d$40d0020a
d$40d1020b
d$40d2020c
d$40d3020d
d$40d4020e
d$40d5020f
d$40d60200
d$40d70201
d$40d80202
d$40d90203
d$40da0204
d$40db0205
d$40dc0206
d$40dd0207
d$40de0208
d$40df0209
d$40e0020a
d$40e1020b
d$40e2020c
d$40e3020d
d$40e4020e
d$40e5020f
d$40e60200
d$40e70201
d$40e80202
d$40e90203
d$40ea0204
d$40eb0205
d$40ec0206
d$40ed0207
d$40ee0208
d$40ef0209
d$40f0020a
d$40f1020b
d$40f2020c
d$40f3020d
d$40f4020e
d$40f5020f
d$40f60200
d$40f70201
d$40f80202
d$40f90203
d$40fa0204
d$40fb0205
d$40fc0206
d$40fd0207
d$40fe0208
d$40ff0209
d$4100020a
d$4101020b
d$4102020c
d$4103020d
d$4104020e
d$4105020f
d$98000100
d$98010101
d$98020102
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
d$98aa01ba
d$98ab01ba
d$98ac01ba
d$98ad01ba
d$98ae01ba
d$98af01ba
d$98b001ba
d$98b101ba
d$98b201ba
d$98b301ba
d$98b401ba
d$98b501ba
d$98b601ba
d$98b701ba
d$98b801ba
d$98b901ba
d$98ba01ba
d$98bb01ba
d$98bc01ba
d$98bd01ba
d$98be01ba
d$98bf01ba
d$98c001ba
d$98c101ba
d$98c201ba
d$98c301ba
d$98c401ba
d$98c501ba
d$98c601ba
d$98c701ba
d$98c801ba
d$98c901ba
d$98ca01ba
d$98cb01ba
d$98cc01ba
d$98cd01ba
d$98ce01ba
d$98cf01ba
d$98d001ba
d$98d101ba
d$98d201ba
d$98d301ba
d$98d401ba
d$98d501ba
d$98d601ba
d$98d701ba
d$98d801ba
d$98d901ba
d$98da01ba
d$98db01ba
d$98dc01ba
d$98dd01ba
d$98de01ba
d$98df01ba
d$98e001ba
d$98e101ba
d$98e201ba
d$98e301ba
d$98e401ba
d$98e501ba
d$98e601ba
d$98e701ba
d$98e801ba
d$98e901ba
d$98ea01ba
d$98eb01ba
d$98ec01ba
d$98ed01ba
d$98ee01ba
d$98ef01ba
d$98f001ba
d$98f101ba
d$98f201ba
d$98f301ba
d$98f401ba
d$98f501ba
d$98f601ba
d$98f701ba
d$98f801ba
d$98f901ba
d$98fa01ba
d$98fb01ba
d$98fc01ba
d$98fd01ba
d$98fe01ba
d$98ff01ba
