martinpiper/BombJack/output/debug3.gif

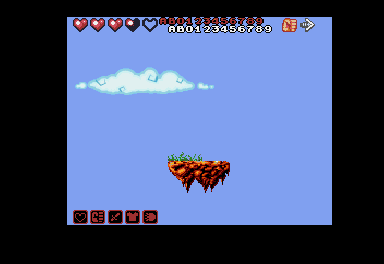
output/debug3.gif
