martinpiper/BombJack/output/debug4.gif

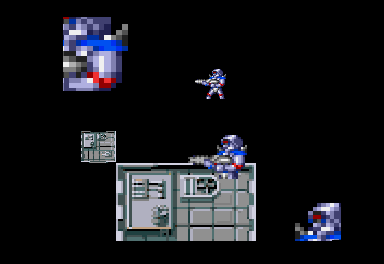
output/debug4.gif
