martinpiper/BombJack/output/debug6.gif

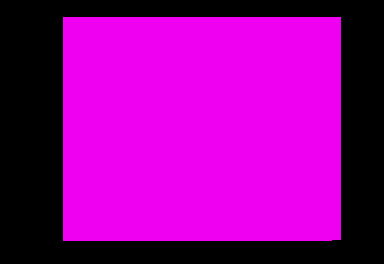
output/debug6.gif
