martinpiper/BombJack/output/debugt.gif

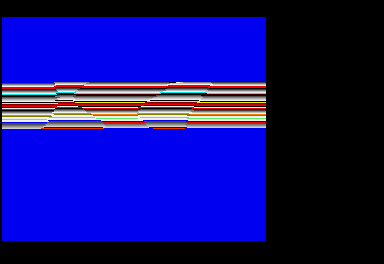
output/debugt.gif
