martinpiper/BombJack/output/V2.0 - Sprite size debug.gif

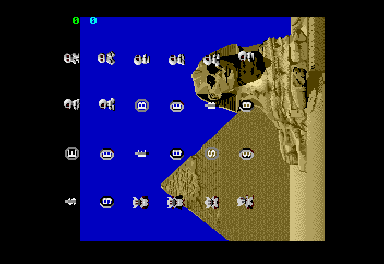
output/V2.0 - Sprite size debug.gif
