martinpiper/BombJack/testdata/debug00000002.bmp

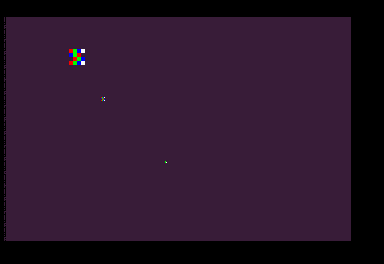
testdata/debug00000002.bmp
