martinpiper/BombJack/testdata/debug00000006.bmp

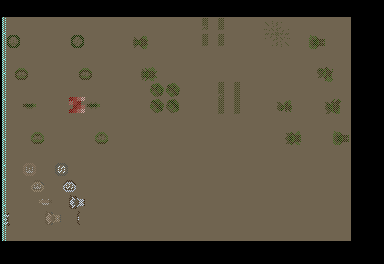
testdata/debug00000006.bmp
