martinpiper/BombJack/testdata/debug6.gif

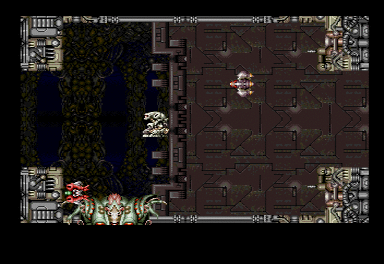
testdata/debug6.gif
