martinpiper/BombJack/testdata/debug00000007.bmp

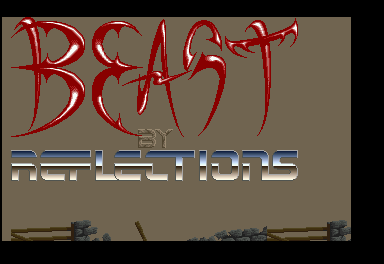
testdata/debug00000007.bmp
