martinpiper/BombJack/testdata/debug00000008.bmp

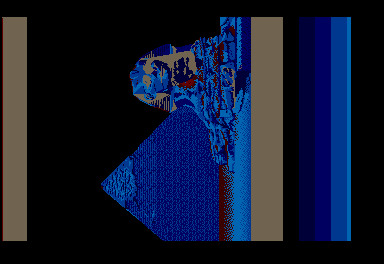
testdata/debug00000008.bmp
