martinpiper/BombJack/testdata/debug00000009.bmp

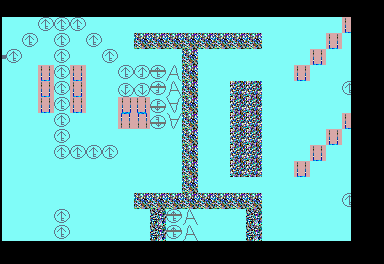
testdata/debug00000009.bmp
