martinpiper/BombJack/testdata/debug00000010.bmp

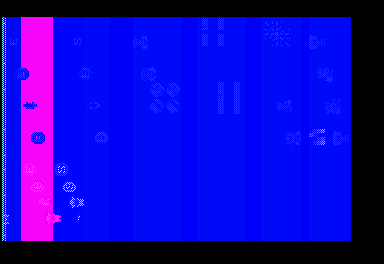
testdata/debug00000010.bmp
