martinpiper/BombJack/testdata/debug00000011.bmp

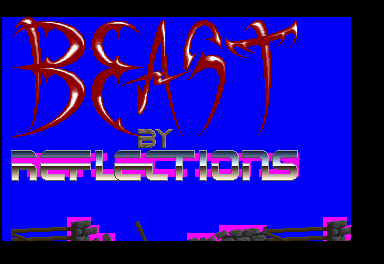
testdata/debug00000011.bmp
