martinpiper/BombJack/testdata/debug00000016.bmp

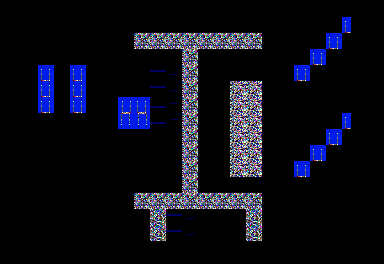
testdata/debug00000016.bmp
