martinpiper/BombJack/V1.0/Bill Of Materials Bomb Jack.pdf

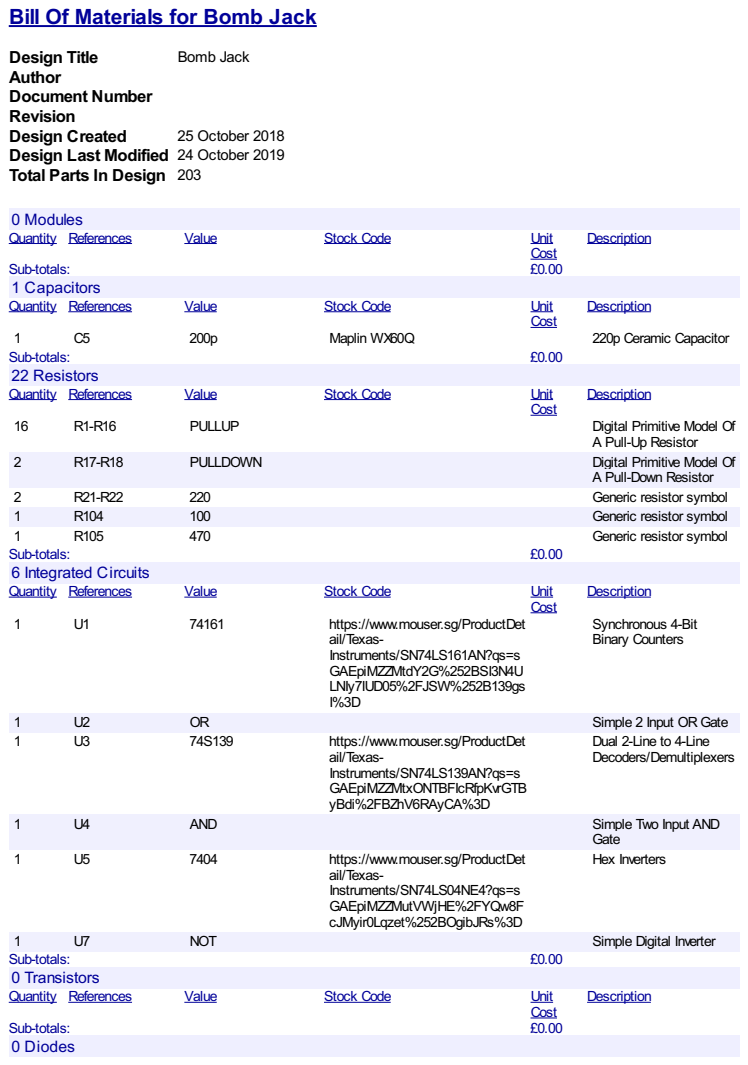
[picture p41: page 1]

Bill Of Materials for Bomb Jack

Author
Document Number
Revision
Design Last Modified 24 October 2019
Total Parts In Design 203

Dual 2-Line to 4-Line
Decoders/Demultiplexers

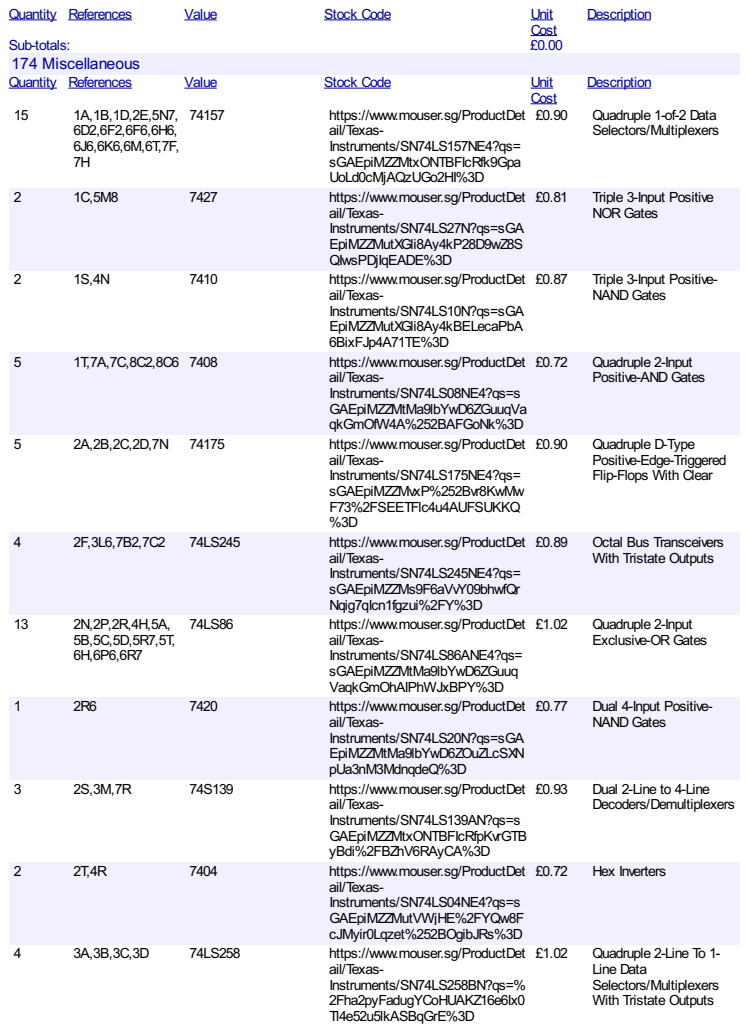
[picture p42: page 2]

2 | 1C,5M8 | | 7427 | https://www.mouser.sg/ProductDet | £0.81 | Triple 3-Input Positive

ail/Texas- | | NORGates

5 | 1T,7A,7C,8C2,8C6 | 7408 | https://www.mouser.sg/ProductDet | £0.72 | Quadruple 2-Input

ail/Texas- | | Positive-ANDGates

Positive-Edge-Triggered
Flip-Flops With Clear

4 | 2F,3L6,7B2,7C2 | | 74LS245 | https://www.mouser.sg/ProductDet | £0.89 | Octal Bus Transceivers

ail/Texas- | | With Tristate Outputs

1 | 2R6 | | 7420 | https://www.mouser.sg/ProductDet | £0.77 | Dual 4-Input Positive-

ail/Texas- | | NANDGates

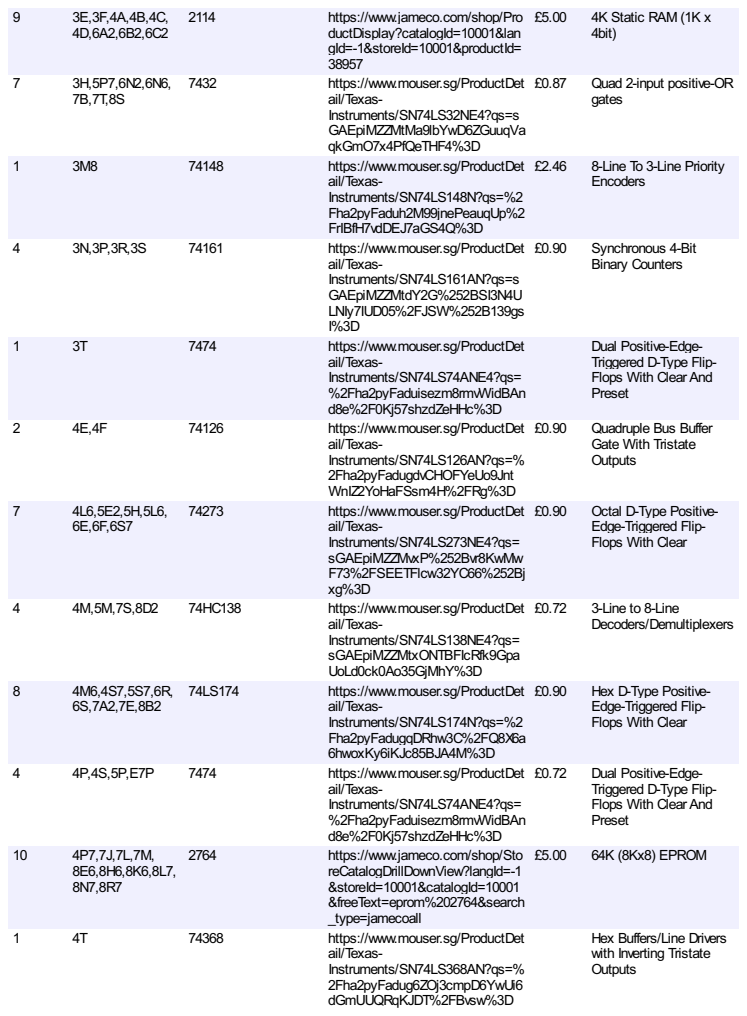
[picture p43: page 3]

1 | 3 M 8 | | 74 1 4 8 | h t t p s:/ / www.m o u s e r.s g/ P ro d u c t Det | £2.4 6 | 8 -Lin e To 3 -Lin e P rio rit y

ail/ Tex a s | | E n c o d e rs

1 | 3 T | | 74 74 | h t t p s:/ / www.m o u s e r.s g/ P ro d u c t Det | D u al P o sitive -E d g e -

ail/ Tex a s | | Trig g e re d D-Ty p e Flip -

7 | 4 L6,5 E 2,5 H,5 | | 74 2 7 3 | h t t p s:/ / www.m o u s e r.s g/ P ro d u c t Det | £ 0.9 0 | Oc t al D-Ty p e P o sitive -

ail/ Tex a s | | E d g e -Trig g e re d Flip -

8 | 4 M 6,4 S 7,5 S 7,6 | | 74 L S 1 74 | h t t p s:/ / www.m o u s e r.s g/ P ro d u c t Det | £ 0.9 0 | H ex D-Ty p e P o sitive -

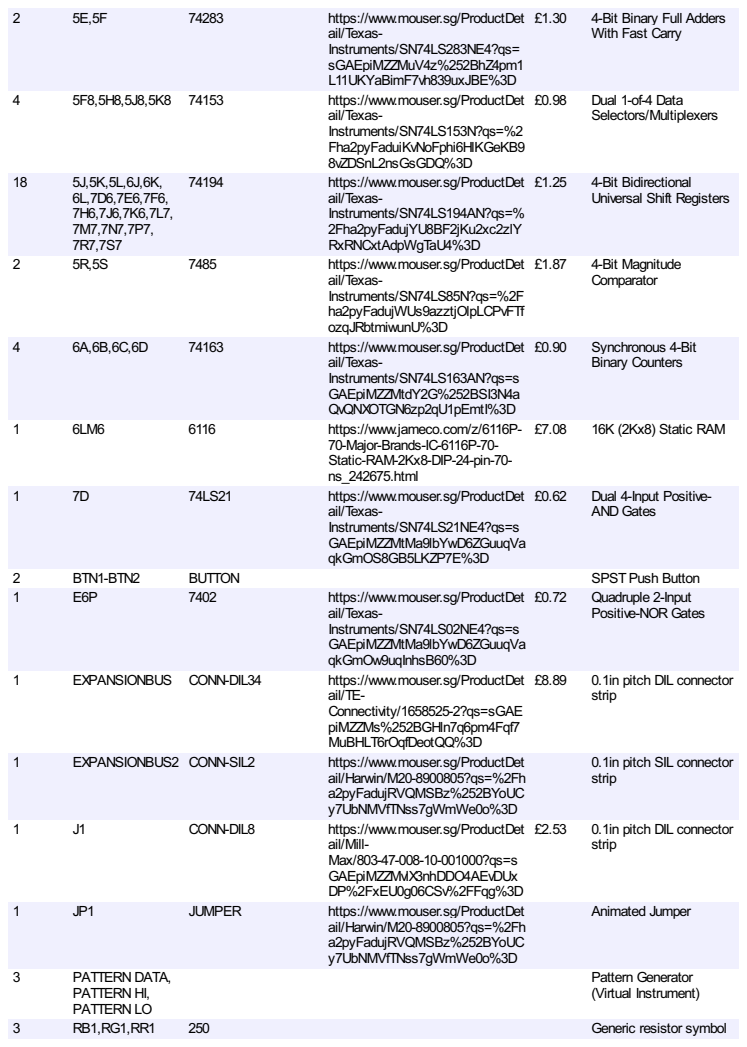
[picture p44: page 4]

2 | 5 E,5 F | | 74 2 8 3 | h t t p s:/ / www.m o u s e r.s g/ P ro d u c t Det | £ 1.3 0 | 4 -Bit Bin a ry F ull Ad d e rs

ail/ Tex a s | | Wit h F a s t Ca rry

1 8 | 5 J,5 K,5 L,6 J,6 | | 74 1 94 | h t t p s:/ / www.m o u s e r.s g/ P ro d u c t Det | £ 1.2 5 | 4 -Bit Bidire c tio n

al Universal Shift Re

ail/ Tex a s | | gis t e rs

4 | 6A,6 B,6 C,6 D | | 74 1 6 3 | h t t p s:/ / www.m o u s e r.s g/ P ro d u c t Det | £ 0.9 0 | S y n c h ro n o u s 4 -Bit

ail/ Tex a s | | Bin a ry Co u n t e rs

1 | 7 D | | 74 L S 2 1 | h t t p s:/ / www.m o u s e r.s g/ P ro d u c t Det | £ 0.6 2 | D u al 4 -In p u t P o sitive -

ail/ Tex a s | | A N D G at e s

1 | E 6 P | | 74 0 2 | h t t p s:/ / www.m o u s e r.s g/ P ro d u c t Det | £ 0.7 2 | Q u a d ru ple 2 -In p u t

ail/ Tex a s | | P o sitive -N O R G at e s

1 | E XP A N SIO N B U S 2 | CO N N -SIL2 | h t t p s:/ / www.m o u s e r.s g/ P ro d u c t Det | 0.1in pit c h SIL c o n n e c t o r

ail/ H a rwin / M 2 0 -8 9 0 0 8 0 5 ? q s = % 2 F h | s t rip

DATA, PATTERN HI, PATTERN LO

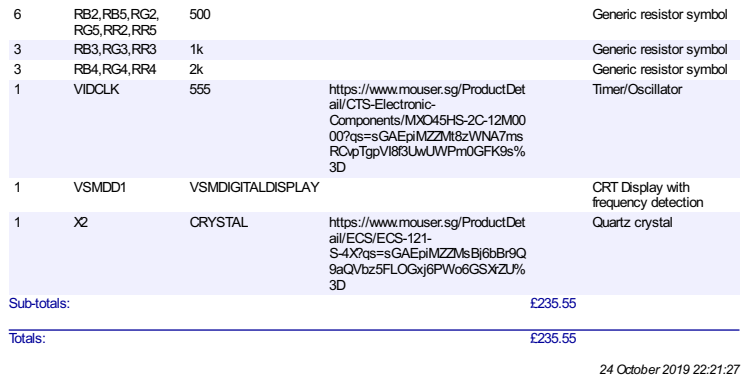
[picture p45: page 5]
