martinpiper/BombJack/(list of files, drawings)

Other design files:
APU-Old.pdsprj
APU.pdsprj
Audio2.pdsprj
Audio3.pdsprj
Audio - Old.pdsprj
Audio.pdsprj
Backplane.pdsprj
BackplaneBridge.pdsprj
Bomb Jack 512x256 test 48 sprites.pdsprj
Bomb Jack - Chars scroll.pdsprj
Bomb Jack - V2.0.pdsprj
Bomb Jack no pullups for Sprites2 on left hand line logic sheet 12.pdsprj
Bomb Jack using demultiplexor to selct SPRFULL.pdsprj
BombJack - Before Sprites4.pdsprj
BombJack - Copy (2).pdsprj
BombJack - Copy.pdsprj
BombJack - master.pdsprj
BombJack - Proteus V8.pdsprj
BombJack - Video daughter board BGCOLOUR.pdsprj
BombJack.pdsprj
BombJackRGB444.pdsprj
C64UltimateDigitalFilter.pdsprj
CY62138FLL Proteus 9.pdsprj
CY62138FLL.pdsprj
DebugPatternGenerator.pdsprj
ExpansionBusDILToDIN41612.pdsprj
ROM2RAM.pdsprj
SimpleCPU.pdsprj
SMT SMD Package test.pdsprj
SocketsWithCaps.pdsprj
Test2114.pdsprj
TTL to SCART resistor ladder.pdsprj
UserPort20To32Bit1.pdsprj
UserPort20To32Bit2.pdsprj
UserPortBreakout.pdsprj
UserPortTo24BitAddress2.pdsprj
UserPortTo24BitAddress.pdsprj
UserPortTo24BitAddressSimple.pdsprj
V1.0/C64UltimateDigitalFilter-Routed.pdsprj
V2.0/C64UltimateDigitalFilter V2.0 - Routed.pdsprj
V3.0/Bomb Jack - Chars - Placed.pdsprj
V3.0/Bomb Jack - Chars - Routed.pdsprj
V3.0/Bomb Jack - Chars.pdsprj
V3.0/Bomb Jack - Sprites - Placed.pdsprj
V3.0/Bomb Jack - Sprites - Routed.pdsprj
V3.0/Bomb Jack - Sprites.pdsprj
V3.0/Bomb Jack - Video - Placed.pdsprj
V3.0/Bomb Jack - Video - Routed.pdsprj
V3.0/Bomb Jack - Video.pdsprj
V3.0/Bomb Jack.pdsprj
V3.0/C64UltimateDigitalFilter V3.0 Routed.pdsprj
V3.0/UserPortBreakout.pdsprj
V3.0/UserPortTo24BitAddress.pdsprj
V3.1 test failing - Bomb Jack - Chars - Routed.pdsprj
V3.1/Bomb Jack - Chars - Placed.pdsprj
V3.1/Bomb Jack - Chars - Routed.pdsprj
V4.0/APU - Routed.pdsprj
V4.0/Bomb Jack - Tiles - Placed.pdsprj
V4.0/C64UltimateDigitalFilter - Routed.pdsprj
V5.0/APU - Placed.pdsprj
V5.0/APU - Routed.pdsprj
V5.0/Audio - Placed.pdsprj
V5.0/Audio - Routed - 8.pdsprj
V5.0/Bomb Jack - Backplane - Placed.pdsprj
V5.0/Bomb Jack - Backplane - Routed.pdsprj
V5.0/Bomb Jack - Chars - Placed.pdsprj
V5.0/Bomb Jack - Chars - Routed.pdsprj
V5.0/Bomb Jack - Mode7 - Placed.pdsprj
V5.0/Bomb Jack - Mode7 - Routed.pdsprj
V5.0/Bomb Jack - Sprites - Placed.pdsprj
V5.0/Bomb Jack - Sprites - Routed.pdsprj
V5.0/Bomb Jack - Tiles - Placed.pdsprj
V5.0/Bomb Jack - Tiles - Routed.pdsprj
V5.0/Bomb Jack - Video - Placed.pdsprj
V5.0/Bomb Jack - Video - Routed.pdsprj
V5.0/Bomb Jack.pdsprj
V6.0/Audio - Placed.pdsprj
V6.0/Bomb Jack - APU - Placed.pdsprj
V6.0/Bomb Jack - APU - Routed.pdsprj
V6.0/Bomb Jack - Chars - Placed.pdsprj
V6.0/Bomb Jack - Video - Placed.pdsprj
V7.0/APU - Placed.pdsprj
V7.0/APU - Routed.pdsprj
V7.0/Bomb Jack - CAP Test - Placed.pdsprj
V7.0/Bomb Jack - CAP Test - Routed.pdsprj
V7.0/Bomb Jack - CAP Test.pdsprj
V7.0/Bomb Jack - Mode7 - Placed.pdsprj
V7.0/Bomb Jack - Sprites2 - Placed.pdsprj
V7.0/Bomb Jack - Sprites2 - Routed.pdsprj
V7.0/Bomb Jack.pdsprj
V8.0/Audio - Placed.pdsprj
V8.0/Audio - Routed.pdsprj
V8.0/Bomb Jack - All - 2.pdsprj
V8.0/Bomb Jack - All - Placed.pdsprj
V8.0/Bomb Jack - All - Routed.pdsprj
V8.0/Bomb Jack - Chars - Placed.pdsprj
V8.0/Bomb Jack - Chars - Routed.pdsprj
V8.0/Bomb Jack - Mode7 - Placed.pdsprj
V8.0/Bomb Jack - Mode7 - Routed.pdsprj
V8.0/Bomb Jack - Sprites2 - Placed.pdsprj
V8.0/Bomb Jack - Sprites2 - Routed.pdsprj
V8.0/Bomb Jack - Sprites - Placed.pdsprj
V8.0/Bomb Jack - Sprites - Routed.pdsprj
V8.0/Bomb Jack - Tiles - Placed.pdsprj
V8.0/Bomb Jack - Tiles - Routed.pdsprj
V8.0/Bomb Jack - Vectors - Placed.pdsprj
V8.0/Bomb Jack - Vectors - Routed.pdsprj
V8.0/Bomb Jack - Video - Placed.pdsprj
V8.0/Bomb Jack - Video - Routed.pdsprj
V9.0/Audio - Placed.pdsprj
V9.0/Audio - Routed.pdsprj
V9.0/Backplane - Routed.pdsprj
V9.0/Bomb Jack - Combiner - Placed.pdsprj
V9.0/Bomb Jack - Sprites2 - Placed SMT.pdsprj
V9.1/Audio - Placed.pdsprj
V9.1/Audio - Routed.pdsprj
V9.1/Bomb Jack - All - Routed.pdsprj
V9.2/Audio - Placed.pdsprj
V9.2/Audio - Routed.pdsprj
V9.3/APU - Placed.pdsprj
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
