martinpiper/BombJack/GenerateVolumeLookup/main.cpp

#include <stdio.h>
#include <stdlib.h>

int main(int argc, char** argv)
{
	FILE *fp = fopen("SampleVolume.bin" , "wb");

	for (int b = 0 ; b < 256 ; b++)
	{
		for (int a = 0 ; a < 256 ; a++)
		{
			// Convert from u8 to s8 sample
			int samp = a - 0x80;
			int output = (samp * b) / 255;
			// Convert from s8 to u8 sample
			output = output + 0x80;

			// And clamp
			if (output > 255)
			{
				output = 255;
			}
			if (output < 0)
			{
				output = 0;
			}

			fputc(output , fp);
		}
	}

	fclose(fp);

	fp = fopen("SignedSampleVolume.bin" , "wb");

	for (int b = 0 ; b < 256 ; b++)
	{
		for (int a = 0 ; a < 256 ; a++)
		{
			// Convert from u8 to s8 sample
			int samp = a;
			if (a & 0x80)
			{
				samp = -(256 - a);
			}
			int output = (samp * b) / 255;
			// Convert from s8 to u8 sample
			output = output + 0x80;

			// And clamp
			if (output > 255)
			{
				output = 255;
			}
			if (output < 0)
			{
				output = 0;
			}

			fputc(output , fp);
		}
	}

	fclose(fp);

	fp = fopen("SampleCombine.bin" , "wb");

	for (int b = 0 ; b < 256 ; b++)
	{
		for (int a = 0 ; a < 256 ; a++)
		{
			// Convert from u8 to s8 sample
			int sampA = a - 0x80;
			int sampB = b - 0x80;
			int output = (sampA + sampB) / 2;	// "/ 2" because this is combining two channels
			// Convert from s8 to u8 sample
			output = output + 0x80;

			// And clamp
			if (output > 255)
			{
				output = 255;
			}
			if (output < 0)
			{
				output = 0;
			}

			fputc(output , fp);
		}
	}

	fclose(fp);

	return 0;
}
