martinpiper/BombJack/PiJack2/src/gfx.c

//
// gfx.c
// Graphic functions
//
// PiGFX is a bare metal kernel for the Raspberry Pi
// that implements a basic ANSI terminal emulator with
// the additional support of some primitive graphics functions.
// Copyright (C) 2014-2020 Filippo Bergamasco, Christian Lehner

#include "pigfx_config.h"
#include "scn_state.h"
#include "gfx.h"
#include "framebuffer.h"
#include "console.h"
#include "dma.h"
#include "utils.h"
#include "c_utils.h"
#include "timer.h"
#include "nmalloc.h"
#include "ee_printf.h"
#include "mbox.h"
#include "config.h"
#include "synchronize.h"

#define MIN( v1, v2 ) ( ((v1) < (v2)) ? (v1) : (v2))
#define MAX( v1, v2 ) ( ((v1) > (v2)) ? (v1) : (v2))
#define PFB( X, Y ) ( ctx.pfb + (Y) * ctx.Pitch + (X) )

#define MAXBITMAPS 128
#define MAXSPRITES 256

int __abs__( int a )
{
    return a<0?-a:a;
}

/** Function type to compute a glyph address in a font. */
typedef unsigned char* font_fun(unsigned int c);

typedef struct
{
    int x;
    int y;
} vector2d;

typedef struct
{
    vector2d min;
    vector2d max;
} tAABB;

// Sprites
typedef struct
{
    unsigned char  active;
    unsigned char  bitmapRef;
    unsigned int   width;
    unsigned int   height;
    unsigned char  transparentcolor;
    DRAWING_MODE   mode;
    int            x;
    int            y;
    tAABB          colDetRect;
    unsigned char* pBackground;
} tSprite;

/** Display properties.
 *  Holds relevant properties for the display routines. Members in this
 *  structure are updated when setting display mode or font or by getting
 *  information from DMA controller.
 */
typedef struct {
	// Graphics variables
    unsigned int W;						/// Screen pixel width
    unsigned int H;						/// Screen pixel height
    unsigned int bpp;					/// Bits depth
    unsigned int Pitch;					/// Number of bytes for one line
    unsigned int size;					/// Number of bytes in the framebuffer (double the screen size)
    unsigned char* pfb;					/// Framebuffer address
    unsigned char* pFirstFb;			/// First Framebuffer address
    unsigned char* pSecondFb;		    /// Second Framebuffer address (double buffering)
    unsigned int fb_yOffset;            /// y-Offset within the framebuffer for double buffering
    DRAWING_MODE mode;					/// Drawing mode: normal, xor, transparent
    unsigned char transparentcolor;		/// For transparent drawing mode

    // bitmap handling
    struct
    {
        unsigned char  loading;
        unsigned char  asciiMode;
        unsigned char  asciiByte;
        unsigned char  asciiBase;
        unsigned short asciiRepeat;
        unsigned char  rleCompressed;
        unsigned char  index;
        unsigned char  chars;
        unsigned int   pixels;
        unsigned int   actPos;
    } bitmaploader;

    // palette handling
    struct
    {
        unsigned char loading;
        unsigned char asciiBase;
        unsigned char colorIdx;
        unsigned int  color;
        unsigned char nbColors;
        unsigned int* pCustPal;
    } paletteloader;

    unsigned char* bitmap[MAXBITMAPS];

    unsigned int lastUsedSprite;
    tSprite sprite[MAXSPRITES];

    // Terminal variables
    struct
    {
    	// Current Font variables
    	unsigned char* FONT;			/// Points to font resource
    	unsigned int FONTWIDTH;			/// Pixel width for characters
    	unsigned int FONTHEIGHT;		/// Pixel height for characters
    	unsigned int FONTCHARBYTES;		/// Number of bytes for one char in font
    	unsigned int FONTWIDTH_INTS;	/// Number of 32-bits integers for font width (4 pixels / int)
    	unsigned int FONTWIDTH_REMAIN;	/// Number of bytes to add to ints (when fontwidth not a multiple of 4)
    	font_fun (*font_getglyph);		/// Function to get a glyph address for a character

    	// Current Character Display variables
        unsigned int WIDTH;				/// Terminal character width (W / font width)
        unsigned int HEIGHT;			/// Terminal character height (H / font height)
        unsigned int tab_pos;			/// 8 by default, tabulation position multiplicator
        unsigned int cursor_row;		/// Current row position (0-based)
        unsigned int cursor_col;		/// Current column position (0-based)
        unsigned int saved_cursor[2];	/// Saved cursor position
        char cursor_visible;			/// 0 if no visible cursor
        char cursor_blink;	     		/// 0 if not blinking
        unsigned int blink_timer_hnd;   /// timer handle for cursor blink

        scn_state state;				/// Current scan state
    } term;

    GFX_COL default_bg;					/// Default background characters color
    GFX_COL default_fg;					/// Default foreground characters color
    GFX_COL bg;					        /// Background characters color
    GFX_COL fg;						    /// Foreground characters color
    unsigned int reverse; 				/// reverse status: 0 - normal; 1 -reverse
    unsigned int bg32;					/// Computed ctx.bg<<24 | ctx.bg<<16 | ctx.bg<<8 | ctx.bg;
    unsigned int fg32;					/// Computed ctx.fg<<24 | ctx.fg<<16 | ctx.fg<<8 | ctx.fg;

    unsigned char* cursor_buffer;		/// Saved content under current buffer position
    unsigned int cursor_buffer_size;	/// Byte size of this buffer
    unsigned int cursor_buffer_ready;	/// 0 if buffer is empty, 1 of it stores a content

} FRAMEBUFFER_CTX;

/** Modes for ESC[=<mode>h - PC ANSI.SYS legacy */
struct DISPLAY_MODE_DEFINITION
{
	unsigned int width;
	unsigned int height;
	unsigned int bpp; 		// NB: all are actually forced to 8 bpp
};

// Number of known modes
#define LAST_MODE_NUMBER 20

/**
 * Display Modes, as they were interpreted by ANSI.SYS on PC with a CGA, EGA or VGA card
 * There is a lot of work to be done :
 * - BPP is 8 for all so all modes are actually 256 colors/pixel and 1 byte per pixel
 * - invalid modes don't do anything
 * - mode 7 (line wrapping) is ignored
 * - only 320x200 and 640*480 seem to actually modify the resolution, other modes merely limit the area on screen.
 */
static struct DISPLAY_MODE_DEFINITION ALL_MODES[LAST_MODE_NUMBER + 1] = {

		// Resolution          Corresponding PC mode    PC card
		//---------------------------------------------------

		// Legacy CGA
		{320,200,8},		// 0: text mono  40 x 25    (CGA)
		{320,200,8},		// 1: text color 40 x 25    (CGA)
		{640,480,8},		// 2: text mono  80 x 25    (CGA)
		{640,480,8},		// 3: text color 80 x 25    (CGA)
		{320,200,8},		// 4: 320 x 200 4 colors    (CGA)
		{320,200,8},		// 5: 320 x 200 mono        (CGA)
		{640,200,8},		// 6: 640 x 200 mono        (CGA)

		// Special or non assigned
		{0,0,0},			// 7: enable line wrapping
		{0,0,0},			// 8:
		{0,0,0},			// 9:
		{0,0,0},			// 10:
		{0,0,0},			// 11:
		{0,0,0},			// 12:

		// Legacy EGA
		{320,200,8},		// 13: 320 x 200 16 colors  (EGA)
		{640,200,8},		// 14: 640 x 200 16 colors  (EGA)
		{640,350,8},		// 15: 640 x 350 mono       (EGA)
		{640,350,8},		// 16: 640 x 350 16 colors  (EGA)

		// Legacy VGA
		{640,480,8},		// 17: 640 x 480 mono       (VGA)
		{640,480,8},		// 18: 640 x 480 16 colors  (VGA)
		{320,200,8},		// 19: 320 x 200 256 colors (MCGA)

		{320,240,8},		// 20: 320 x 240 256 colors (Michael Abrash X-Mode)
};

/** Forward declaration for some state functions. */
state_fun state_fun_finalletter;
state_fun state_fun_read_digit;
state_fun state_fun_selectescape;
state_fun state_fun_waitquarebracket;
state_fun state_fun_normaltext;
state_fun state_fun_ignore_digit;

#include "framebuffer.h"

// Global static to store the screen variables.
FRAMEBUFFER_CTX ctx;

// Forward declarations
void gfx_term_render_cursor();
void gfx_term_save_cursor_content();
void gfx_switch_framebuffer();

// Functions from pigfx.c called by some private sequences (set mode, debug tests ...)
extern void initialize_framebuffer(unsigned int width, unsigned int height, unsigned int bpp);
//extern void video_line_test(int maxloops);
//extern void video_test(int maxloops);

/** Fonts from binary_assets.s and fonts (*.bin) */
extern unsigned char G_FONT8X8_GLYPHS;
extern unsigned char G_FONT8X16_GLYPHS;
extern unsigned char G_FONT8X24_GLYPHS;

/** Font function for the default 8x8 font. */
unsigned char* font_get_glyph_address_8x8(unsigned int c)
{
	// offset of glyph is c * 64 bytes, which can be computed by c << 6
	return ctx.term.FONT + ((unsigned int)c<<6);
}
/** Font function for the 8x24 font. */
unsigned char* font_get_glyph_address_8x24(unsigned int c)
{
	// offset of glyph is c * 192 bytes, which is c << 7 + c << 6
	//unsigned int c64 = (unsigned int)(c<<6);
	//return (unsigned int*)( ctx.term.FONT + c64 + (c64 << 1));
	return ctx.term.FONT + c * 192;
}
/** Font function for the 8x16 font. */
unsigned char* font_get_glyph_address_8x16(unsigned int c)
{
	// offset of glyph is c * 128 bytes, which can be computed by c << 7
	return ctx.term.FONT + ((unsigned int)c<<7);
}

/** Generic Font function. */
unsigned char* font_get_glyph_address_any(unsigned int c)
{
	return (unsigned char*) ( ctx.term.FONT + c * ctx.term.FONTCHARBYTES );
}

/** Compute some font variables from font size. */
void gfx_compute_font()
{
	ctx.term.FONTCHARBYTES = ctx.term.FONTWIDTH * ctx.term.FONTHEIGHT;
	ctx.term.FONTWIDTH_INTS = ctx.term.FONTWIDTH / 4 ;
	ctx.term.FONTWIDTH_REMAIN = ctx.term.FONTWIDTH % 4;
	ctx.cursor_buffer_size = ctx.term.FONTWIDTH * ctx.term.FONTHEIGHT;
	if (ctx.cursor_buffer)
	{
		nmalloc_free(ctx.cursor_buffer);
		ctx.cursor_buffer = 0;
		ctx.cursor_buffer_ready = 0;
	}
	ctx.cursor_buffer = (unsigned char*)nmalloc_malloc(ctx.cursor_buffer_size);
	pigfx_memset(ctx.cursor_buffer, 0, ctx.cursor_buffer_size);

	// set logical terminal size
    ctx.term.WIDTH = ctx.W / ctx.term.FONTWIDTH;
    ctx.term.HEIGHT= ctx.H / ctx.term.FONTHEIGHT;
    gfx_term_save_cursor_content();
}


//// Collision detection
//// Concept taken from cute_c2
unsigned char AABBtoAABBcollide(tAABB* pA, tAABB* pB)
{
    int d0 = pB->max.x+1 < pA->min.x;
    int d1 = pA->max.x+1 < pB->min.x;
    int d2 = pB->max.y+1 < pA->min.y;
    int d3 = pA->max.y+1 < pB->min.y;
    return !(d0 | d1 | d2 | d3);
}

/** Sets the display variables. This is called by initialize_framebuffer when setting mode.
 * Default to 8x16 font if no other font was selected before.
 * @param p_framebuffer Framebuffer address as given by DMA
 * @param width Pixel width
 * @param height Pixel height
 * @param bpp Bit depth
 * @param pitch Line byte pitch as given by DMA
 * @param size Byte size for framebuffer
 */
void gfx_set_env( void* p_framebuffer, unsigned int width, unsigned int height, unsigned int bpp, unsigned int pitch, unsigned int size )
{
    dma_init();

    // Set ctx memory to 0
    pigfx_memset(&ctx, 0, sizeof(ctx));

    // set default font
    if (ctx.term.FONT == 0) {
    	gfx_term_set_font(8,16);
    }

    // Store DMA framebuffer infos
    ctx.pFirstFb = p_framebuffer;
    ctx.pSecondFb = p_framebuffer+size/2;
    //ctx.pfb = ctx.pSecondFb;    // set invisible part of screen to start with
    ctx.pfb = ctx.pFirstFb;    // set invisible part of screen to start with
    ctx.W = width;
    ctx.H = height;
    ctx.Pitch = pitch;
    ctx.size = size/2;      // screen is only half of the framebuffer with double buffering
    ctx.bpp = bpp;

    // store terminal sizes and informations
    ctx.term.WIDTH = ctx.W / ctx.term.FONTWIDTH;
    ctx.term.HEIGHT= ctx.H / ctx.term.FONTHEIGHT;
    ctx.term.cursor_row = ctx.term.cursor_col = 0;
    ctx.term.cursor_visible = 1;
    ctx.term.state.next = state_fun_normaltext;


    // store reverse state to 'normal'
    ctx.reverse = 0;

    // set default colors
    gfx_set_default_fg(GRAY);
    gfx_set_default_bg(BLACK);

    // set colors
    gfx_set_fg(ctx.default_fg);
    gfx_set_bg(ctx.default_bg);

    ctx.paletteloader.pCustPal = fb_get_cust_pal_p();

    gfx_term_render_cursor();
}

void gfx_set_default_bg( GFX_COL col )
{
    ctx.default_bg = col;
}

void gfx_set_default_fg( GFX_COL col )
{
    ctx.default_fg = col;
}

/** Sets the background color. */
void gfx_set_bg( GFX_COL col )
{
    ctx.bg = col;
    // fill precomputed 4 bytes integer
    unsigned char* p = (unsigned char*)&ctx.bg32;
    for (size_T i = 0 ; i < sizeof(ctx.bg32) ; i++)
    	*(p++) = col;
}

/** Sets the foreground color. */
void gfx_set_fg( GFX_COL col )
{
    ctx.fg = col;
    // fill precomputed 4 bytes integer
    unsigned char* p = (unsigned char*)&ctx.fg32;
    for (size_T i = 0 ; i < sizeof(ctx.fg32) ; i++)
    	*(p++) = col;
}

/** Swaps the foreground and background colors. */
void gfx_swap_fg_bg()
{
    GFX_COL safe_fg = ctx.fg;
    gfx_set_fg(ctx.bg);
    gfx_set_bg(safe_fg);
}

/** Returns the character terminal size. */
void gfx_get_term_size( unsigned int* rows, unsigned int* cols )
{
    *rows = ctx.term.HEIGHT;
    *cols = ctx.term.WIDTH;
}

/** Returns the pixel display sizes . */
void gfx_get_gfx_size( unsigned int* width, unsigned int* height )
{
    *width = ctx.W;
    *height = ctx.H;
}

/** Sets the transparent color for transparent mode.
 *
 */
void gfx_set_transparent_color( GFX_COL color )
{
	ctx.transparentcolor = color;
}


// Sprite collision detection
void gfx_check_collision(unsigned char own)
{
    if (PiGfxConfig.disableCollision) return;

    for (unsigned int i=0; i<=ctx.lastUsedSprite; i++)
    {
        if ((ctx.sprite[i].active == 0) || (i == own)) continue;
        // check collision of own sprite with this sprite
        if (AABBtoAABBcollide(&ctx.sprite[own].colDetRect, &ctx.sprite[i].colDetRect))
        {
            // collision detected
            cout("\x1b[#");cout_d(own);cout(";");cout_d(i);cout("c");
        }
    }
}

/** Draw a sprite in normal mode.
 * The sprite pixels overwrite the existing background.
 * NB: Foreground and background color are not used by sprites.
 */
void gfx_put_sprite_NORMAL( unsigned char* p_sprite, int x, int y )
{
    // Check Nul pointer
    if (p_sprite == 0) return;
    // Check start
    if (x >= (int)ctx.W || y >= (int)ctx.H) return;
    if (x<0 || y<0) return;

    //unsigned int tact = time_microsec();

    // Get framebuffer address and bitmap size
    unsigned char* pf = PFB(x,y);
    unsigned int *p_spr_32 = (unsigned int*)p_sprite;
    unsigned int width  = *p_spr_32; p_spr_32++;
    unsigned int height = *p_spr_32; p_spr_32++;

    unsigned char* pspr = (unsigned char*)p_spr_32;

    // limit bitmap size to screen
    if (y+height > ctx.H) height = ctx.H - y;
    unsigned int usedwidth = width;
    if (x+width > ctx.W) usedwidth = ctx.W - x;

    if (PiGfxConfig.disableGfxDMA)
    {
        for(unsigned int i=0; i<height; ++i )
        {
            veryfastmemcpy(pf, pspr, usedwidth);
            pf += ctx.Pitch;
            pspr += width;
        }
    }
    else
    {
        dma_enqueue_operation( p_spr_32,
                            pf,
                            (((height-1) & 0xFFFF )<<16) | (usedwidth & 0xFFFF ),
                            (((ctx.Pitch-usedwidth) & 0xFFFF)<<16 | ((width-usedwidth) & 0xFFFF)), /* bits 31:16 destination stride, 15:0 source stride */
                            DMA_TI_DEST_INC | DMA_TI_2DMODE | DMA_TI_SRC_INC );
        dma_execute_queue();
    }
    //cout("gfx_put_sprite_NORMAL took ");cout_d(time_microsec()- tact);cout(" DisableDMA=");cout_d(PiGfxConfig.disableGfxDMA);cout_endl();
}
/** Draw a sprite in XOR mode.
 * The sprite pixels are XORed with the existing background.
 * Interesting side effects:
 * - sprite pixel drawn over a black background (color 00) keep the original sprite color
 * - sprite color 0 pixel doesn't modify the existing background
 * NB: Foreground and background color are not used by sprites.
 */
void gfx_put_sprite_XOR( unsigned char* p_sprite, int x, int y )
{
    // Check Nul pointer
    if (p_sprite == 0) return;
    // Check start
    if (x >= (int)ctx.W || y >= (int)ctx.H) return;
    if (x<0 || y<0) return;

    //unsigned int tact = time_microsec();

    unsigned char* pf = PFB(x,y);
    unsigned int *p_spr_32 = (unsigned int*)p_sprite;
    unsigned int width  = *p_spr_32; p_spr_32++;
    unsigned int height = *p_spr_32; p_spr_32++;

    unsigned int i,j;
    unsigned char* pspr = (unsigned char*)p_spr_32;

    // limit bitmap size to screen
    if (y+height > ctx.H) height = ctx.H - y;
    unsigned int usedwidth = width;
    if (x+width > ctx.W) usedwidth = ctx.W - x;

    for( i=0; i<height; ++i )
    {
        for( j=0; j<usedwidth; ++j )
        {
            unsigned char bkg = *pf;
            unsigned char pix = *pspr++;
            *pf++ = pix ^ bkg ;
        }
        pf += ctx.Pitch - usedwidth;
        pspr += width - usedwidth;
    }
    //cout("gfx_put_sprite_XOR took ");cout_d(time_microsec()- tact);cout("DisableDMA=");cout_d(PiGfxConfig.disableGfxDMA);cout_endl();
}
/** Draw a transparent sprite. Pixels with the transparent color are not drawn,
 * leaving the existing background visible. By default, 00 is the transparent color.
 */
void gfx_put_sprite_TRANSPARENT( unsigned char* p_sprite, int x, int y )
{
    // Check Nul pointer
    if (p_sprite == 0) return;
    // Check start
    if (x >= (int)ctx.W || y >= (int)ctx.H) return;
    if (x<0 || y<0) return;

    //unsigned int tact = time_microsec();

    unsigned char* pf = PFB(x,y);
    unsigned int *p_spr_32 = (unsigned int*)p_sprite;
    unsigned int width  = *p_spr_32; p_spr_32++;
    unsigned int height = *p_spr_32; p_spr_32++;

    unsigned int i,j;
    unsigned char* pspr = (unsigned char*)p_spr_32;

    // limit bitmap size to screen
    if (y+height > ctx.H) height = ctx.H - y;
    unsigned int usedwidth = width;
    if (x+width > ctx.W) usedwidth = ctx.W - x;

    for( i=0; i<height; ++i )
    {
        for( j=0; j<usedwidth; ++j )
        {
            unsigned char pix = *pspr++;
            if (pix != ctx.transparentcolor) *pf = pix;
            pf++;
        }
        pf += ctx.Pitch - usedwidth;
        pspr += width - usedwidth;
    }
    //cout("gfx_put_sprite_TRANSPARENT took ");cout_d(time_microsec()- tact);cout(" DisableDMA=");cout_d(PiGfxConfig.disableGfxDMA);cout_endl();
}

// remove a sprite and restore previous background
void gfx_remove_sprite(unsigned char idx)
{
    if (ctx.sprite[idx].active == 0) return;
    if (ctx.sprite[idx].pBackground == 0) return;
    gfx_put_sprite_NORMAL(ctx.sprite[idx].pBackground, ctx.sprite[idx].x, ctx.sprite[idx].y);
    nmalloc_free(ctx.sprite[idx].pBackground);
    ctx.sprite[idx].pBackground = 0;
    ctx.sprite[idx].active = 0;

    ctx.lastUsedSprite = 0;
    for (unsigned int i=MAXSPRITES-1; i>0; i--)
    {
        if (ctx.sprite[i].active)
        {
            ctx.lastUsedSprite = i;
            break;
        }
    }
}

// save background data before a sprite is drawn
void gfx_save_background(tSprite* pSprite, unsigned char* pBitmap, unsigned int x, unsigned int y)
{
    // Check Nul pointer
    if ((pSprite == 0) || (pBitmap == 0))  return;
    // Check start
    if (x >= ctx.W || y >= ctx.H) return;

    //unsigned int tact = time_microsec();

    // Get width and height
    uint32_t* pW = (uint32_t*)pBitmap;
    uint32_t* pH = pW+1;
    pSprite->width = *pW;
    pSprite->height = *pH;
    // Alloc mem
    pSprite->pBackground = nmalloc_malloc(8+(*pW)*(*pH));    // Header 8 bytes for x and y, then data
    pW = (uint32_t*)pSprite->pBackground;
    pH = pW+1;
    // Write width and height to saved background
    *pW = pSprite->width;
    *pH = pSprite->height;
    // Write pixel data to saved background
    unsigned char* pScreen = PFB(x,y);
    unsigned int i/*, j*/;
    unsigned char* pSave = pSprite->pBackground+8;
    unsigned int height = *pH;
    unsigned int width = *pW;

    // limit bitmap size to screen
    if (y+height > ctx.H) height = ctx.H - y;
    unsigned int usedwidth = width;
    if (x+width > ctx.W) usedwidth = ctx.W - x;

    if (PiGfxConfig.disableGfxDMA)
    {
        for( i=0; i<height; ++i )
        {
            veryfastmemcpy(pSave, pScreen, usedwidth);
            pScreen += ctx.Pitch;
            pSave += width;
        }
    }
    else
    {
        dma_enqueue_operation( pScreen,
                            pSave,
                            (((height-1) & 0xFFFF )<<16) | (usedwidth & 0xFFFF ),
                            (((width-usedwidth) & 0xFFFF)<<16 | ((ctx.Pitch-usedwidth) & 0xFFFF)), /* bits 31:16 destination stride, 15:0 source stride */
                            DMA_TI_DEST_INC | DMA_TI_2DMODE | DMA_TI_SRC_INC );
        dma_execute_queue();
    }

    //cout("gfx_save_background took ");cout_d(time_microsec()- tact);cout(" DisableDMA=");cout_d(PiGfxConfig.disableGfxDMA);cout_endl();
}

/** Draw a sprite in the current drawing mode.
 */
draw_putsprite_fun (*gfx_put_sprite) = gfx_put_sprite_NORMAL;

/** Correct sprite positions if screen is moved */
void gfx_corr_sprite_pos(int dx, int dy)
{
    for (unsigned int i=0; i<=ctx.lastUsedSprite; i++)
    {
        if (ctx.sprite[i].active)
        {
            ctx.sprite[i].x += dx;
            ctx.sprite[i].y += dy;
            ctx.sprite[i].colDetRect.min.x += dx;
            ctx.sprite[i].colDetRect.min.y += dy;
            ctx.sprite[i].colDetRect.max.x += dx;
            ctx.sprite[i].colDetRect.max.y += dy;
        }
    }
}

/** Sets the whole display to background color. */
void gfx_clear()
{
    for (unsigned int i=0; i<=ctx.lastUsedSprite; i++)
    {
        if (ctx.sprite[i].active)
        {
            if (ctx.sprite[i].pBackground)
            {
                nmalloc_free(ctx.sprite[i].pBackground);
                ctx.sprite[i].pBackground = 0;
            }
            ctx.sprite[i].active = 0;
        }
    }

    if (PiGfxConfig.disableGfxDMA)
    {
        unsigned int* pf = (unsigned int*)ctx.pfb;
        for (unsigned int i=0; i< ctx.size/4; i++)
        {
            pf[i] = ctx.bg32;
        }
    }
    else
    {
        // Somehow a simple memfill is not working with DMA. So we fill the first line on the screen and then use 2D mode to copy it to the rest of the screen
        unsigned int* fillScreen = (unsigned int*)ctx.pfb;
        for (unsigned int i=0; i<ctx.Pitch/4; i++)
        {
            fillScreen[i] = ctx.bg32;
        }
        dma_enqueue_operation( ctx.pfb,
                            ctx.pfb+ctx.Pitch,
                            (((ctx.H-2) & 0xFFFF )<<16) | (ctx.Pitch & 0xFFFF ), // y len << 16 | xlen
                            (-ctx.Pitch & 0xFFFF), // bits 31:16 destination stride, 15:0 source stride
                            DMA_TI_DEST_INC | DMA_TI_2DMODE | DMA_TI_SRC_INC );
        dma_execute_queue();
    }
}

/** move screen up, new bg pixels on bottom */
void gfx_scroll_down( unsigned int npixels )
{
    unsigned int* pf_src = (unsigned int*)( ctx.pfb + ctx.Pitch*npixels);
    unsigned int* pf_dst = (unsigned int*)ctx.pfb;
    const unsigned int* const pfb_end = (unsigned int*)( ctx.pfb + ctx.size );

    if (PiGfxConfig.disableGfxDMA)
    {
        while( pf_src < pfb_end )
            *pf_dst++ = *pf_src++;
    }
    else
    {
        unsigned int line_height = ctx.Pitch * npixels;
        unsigned int pixelstocopy = ctx.size - line_height;

        dma_memcpy_32(ctx.pfb + line_height, ctx.pfb, pixelstocopy);
        pf_dst += pixelstocopy/4;
    }

    // Fill with bg at the bottom
    while( pf_dst < pfb_end )
        *pf_dst++ = ctx.bg32;
    gfx_corr_sprite_pos(0, -npixels);
}

/** move screen down, new bg pixels on top */
void gfx_scroll_up( unsigned int npixels )
{
    unsigned int* pf_dst = (unsigned int*)( ctx.pfb + ctx.size ) -1;
    unsigned int* pf_src = (unsigned int*)( ctx.pfb + ctx.size - ctx.Pitch*npixels) -1;
    const unsigned int* const pfb_end = (unsigned int*)( ctx.pfb );

    while( pf_src >= pfb_end )
        *pf_dst-- = *pf_src--;

    // Fill with bg at the top
    while( pf_dst >= pfb_end )
        *pf_dst-- = ctx.bg32;
    gfx_corr_sprite_pos(0, npixels);
}

/** move screen to the right, new bg pixels on the left */
void gfx_scroll_left( unsigned int npixels )
{
    if (npixels >= ctx.W) return;
    if (npixels == 0) return;

    unsigned char* pfb_dst;
    unsigned char* pfb_src;
    unsigned char* pfb_end;
    for (unsigned int i=0; i<ctx.H; i++)
    {
        // for all lines
        pfb_end = PFB(0, i);
        pfb_dst = PFB(ctx.W-1, i);
        pfb_src = PFB(ctx.W-1-npixels, i);
        while (pfb_src >= pfb_end)
            *pfb_dst-- = *pfb_src--;
        for (unsigned int k=0; k<npixels; k++)
            *pfb_end++ = ctx.bg;
    }
    gfx_corr_sprite_pos(npixels, 0);
}

/** move screen to the left, new bg pixels on the right */
void gfx_scroll_right( unsigned int npixels )
{
    if (npixels >= ctx.W) return;
    if (npixels == 0) return;

    unsigned int cpPixels = ctx.W-npixels;
    for (unsigned int i=0; i<ctx.H; i++)
    {
        // for all lines
        veryfastmemcpy(PFB(0,i), PFB(npixels,i), cpPixels);
        unsigned char* pfb_bg = PFB(cpPixels, i);
        for (unsigned int j=cpPixels; j<ctx.W; j++)
        {
            *pfb_bg++ = ctx.bg;
        }
    }
    gfx_corr_sprite_pos(-npixels, 0);
}

/** draw a bg filled rectangle: */
void gfx_fill_rect( unsigned int x, unsigned int y, unsigned int width, unsigned int height )
{
    if( x >= ctx.W || y >= ctx.H )
        return;

    if( x+width > ctx.W )
        width = ctx.W-x;

    if( y+height > ctx.H )
        height = ctx.H-y;

    while( height-- )
    {
        unsigned char* pf = PFB(x,y);
        const unsigned char* const pfb_end = pf + width;

        while( pf < pfb_end )
            *pf++ = ctx.fg;
        ++y;
    }
}

/** TODO */
void gfx_draw_circle(unsigned int x0, unsigned int y0, unsigned int rad)
{
    register unsigned char* pfb;
    int f = 1 - rad;
    int ddF_x = 0;
    int ddF_y = -2 * rad;
    int x = 0;
    int y = rad;
    int xdraw,ydraw;

    //setPixel(x0, y0 + rad);
    ydraw = y0+rad;
    if (ydraw < (int)ctx.H)
    {
        pfb = PFB(x0,ydraw);
        *pfb = ctx.fg;
    }

    //setPixel(x0, y0 - rad);
    ydraw -= rad+rad;
    if (ydraw >= 0)
    {
        pfb = PFB(x0,ydraw);
        *pfb = ctx.fg;
    }

    //setPixel(x0 + rad, y0);
    xdraw = x0+rad;
    if (xdraw < (int)ctx.W)
    {
        pfb = PFB(xdraw,y0);
        *pfb = ctx.fg;
    }

    //setPixel(x0 - rad, y0);
    xdraw -= rad+rad;
    if (xdraw >= 0)
    {
        pfb = PFB(xdraw,y0);
        *pfb = ctx.fg;
    }


    while(x < y)
    {
        if(f >= 0)
        {
          y--;
          ddF_y += 2;
          f += ddF_y;
        }
        x++;
        ddF_x += 2;
        f += ddF_x + 1;

        //setPixel(x0 + x, y0 + y);
        xdraw = x0+x;
        ydraw = y0+y;
        if ((xdraw < (int)ctx.W) && (ydraw < (int)ctx.H))
        {
            pfb = PFB(xdraw,ydraw);
            *pfb = ctx.fg;
        }

        //setPixel(x0 - x, y0 + y);
        xdraw = x0-x;
        if ((xdraw >= 0) && (ydraw < (int)ctx.H))
        {
            pfb = PFB(xdraw,ydraw);
            *pfb = ctx.fg;
        }

        //setPixel(x0 + x, y0 - y);
        xdraw = x0+x;
        ydraw = y0-y;
        if ((xdraw < (int)ctx.W) && (ydraw >= 0))
        {
            pfb = PFB(xdraw,ydraw);
            *pfb = ctx.fg;
        }

        //setPixel(x0 - x, y0 - y);
        xdraw = x0-x;
        if ((xdraw >= 0) && (ydraw >= 0))
        {
            pfb = PFB(xdraw,ydraw);
            *pfb = ctx.fg;
        }

        //setPixel(x0 + y, y0 + x);
        xdraw = x0+y;
        ydraw = y0+x;
        if ((xdraw < (int)ctx.W) && (ydraw < (int)ctx.H))
        {
            pfb = PFB(xdraw,ydraw);
            *pfb = ctx.fg;
        }

        //setPixel(x0 - y, y0 + x);
        xdraw = x0-y;
        if ((xdraw >= 0) && (ydraw < (int)ctx.H))
        {
            pfb = PFB(xdraw,ydraw);
            *pfb = ctx.fg;
        }

        //setPixel(x0 + y, y0 - x);
        xdraw = x0+y;
        ydraw = y0-x;
        if ((xdraw < (int)ctx.W) && (ydraw >= 0))
        {
            pfb = PFB(xdraw,ydraw);
            *pfb = ctx.fg;
        }

        //setPixel(x0 - y, y0 - x);
        xdraw = x0-y;
        if ((xdraw >= 0) && (ydraw >= 0))
        {
            pfb = PFB(xdraw,ydraw);
            *pfb = ctx.fg;
        }
    }
}

// Draw a horizontal line
void gfx_draw_hor_line(int x0, int y0, unsigned int width)
{
    if ((y0 < 0) || (y0 >= (int)ctx.H)) return;
    if (x0 >= (int)ctx.W) return;

    int diff;

    if (x0 < 0)
    {
        diff = 0-x0;
        x0 = 0;
        width-=diff;
    }
    if (x0+width >= ctx.W)
    {
        width = ctx.W-x0-1;
    }

    unsigned int i;
    register unsigned char* pfb = PFB(x0,y0);
    for (i=0;i<width;i++)
    {
        *pfb++ = ctx.fg;
    }
}

// Draw a filled circle
void gfx_draw_filled_circle(unsigned int x0, unsigned int y0, unsigned int rad)
{
    int xoff = 0;
    int yoff = rad;
    int balance = -rad;
    int p0,p1,w0,w1;

    while (xoff <= yoff)
    {
        p0 = x0 - xoff;
        p1 = x0 - yoff;

        w0 = xoff + xoff;
        w1 = yoff + yoff;

        gfx_draw_hor_line(p0, y0 + yoff, w0);
        gfx_draw_hor_line(p0, y0 - yoff, w0);

        gfx_draw_hor_line(p1, y0 + xoff, w1);
        gfx_draw_hor_line(p1, y0 - xoff, w1);

        balance += xoff+xoff+1;
        xoff++;

        if (balance>= 0)
        {
            yoff--;
            balance -= yoff+yoff;
        }
    }
}

/** TODO: */
void gfx_clear_rect( unsigned int x, unsigned int y, unsigned int width, unsigned int height )
{
    gfx_swap_fg_bg();
    gfx_fill_rect(x,y,width,height);
    gfx_swap_fg_bg();
}

/** TODO: */
void gfx_line( int x0, int y0, int x1, int y1 )
{
    x0 = MAX( MIN(x0, (int)ctx.W), 0 );
    y0 = MAX( MIN(y0, (int)ctx.H), 0 );
    x1 = MAX( MIN(x1, (int)ctx.W), 0 );
    y1 = MAX( MIN(y1, (int)ctx.H), 0 );

    register unsigned char* pfb;
    int e2;
    int dx =  __abs__(x1-x0);
    int sx = x0<x1 ? 1 : -1;
    int dy = -__abs__(y1-y0);
    int sy = y0<y1 ? 1 : -1;
    int err = dx+dy;  /* error value e_xy */

    while (1)   /* loop */
    {
        // draw pixel
        pfb = PFB(x0,y0);
        *pfb = ctx.fg;

        if ((x0==x1) && (y0==y1)) break;
        e2 = 2*err;
        if (e2 >= dy)
        {
            err += dy; /* e_xy+e_x > 0 */
            x0 += sx;
        }
        if (e2 <= dx) /* e_xy+e_y < 0 */
        {
            err += dx;
            y0 += sy;
        }
    }
}

/** Display a character at a position. The character is drawn using
 * foreground color and pixels OFF are erased using the background color.
 *  NB: Characters with codes from 0 to 31 are displayed using current font and don't have any control effect.
 *	@param row the character line number (0 = top screen)
 *	@param col the character column (0 = left)
 *	@param c the character code from 0 to 255.
 */
void gfx_putc_NORMAL( unsigned int row, unsigned int col, unsigned char c )
{
    if( col >= ctx.term.WIDTH )
        return;
    if( row >= ctx.term.HEIGHT )
        return;

    const unsigned int pixcol = col * ctx.term.FONTWIDTH;
    const unsigned int pixrow = row * ctx.term.FONTHEIGHT;

    if (ctx.term.FONTWIDTH == 8)
    {
    	// optimized original code drawing 4 pixels at once using 32-bit ints
        const unsigned int FG = ctx.fg32;
        const unsigned int BG = ctx.bg32;
        const unsigned int int_stride = (ctx.Pitch>>2) - 2; // 2 ints = 8 pixels = 1 character
		register unsigned int* p_glyph = (unsigned int*)ctx.term.font_getglyph(c);
		register unsigned char h = ctx.term.FONTHEIGHT;
		register unsigned int* pf = (unsigned int*)PFB(pixcol, pixrow);
		while(h--)
		{
			// Loop unrolled for 8xH fonts
			register unsigned int gv = *p_glyph++;
			// Each byte is 00 for background pixel or FF for foreground pixel
			*pf++ =  (gv & FG) | ( ~gv & BG );
			gv = *p_glyph++;
			*pf++ =  (gv & FG) | ( ~gv & BG );
			pf += int_stride;
		}
    }
    else
    {
		// number of bytes to next line start position in framebuffer
    	const unsigned int byte_stride = ctx.Pitch - ctx.term.FONTWIDTH;
    	// address of character in font
		register unsigned char* p_glyph = (unsigned char*)ctx.term.font_getglyph(c);
		// copy from font to framebuffer for each font line
		register unsigned char h = ctx.term.FONTHEIGHT;
		register unsigned char* pf = (unsigned char*)PFB(pixcol, pixrow);
		while( h-- )
		{
			unsigned int w = ctx.term.FONTWIDTH;
			while( w-- )
			{
				register unsigned char gv = *p_glyph++;	// get 1 pixel of font glyph
				if (gv)
					*pf++ = ctx.fg;
				else
					*pf++ = ctx.bg;
			}
			pf += byte_stride;
		}
    }
}

/** Displays a character at a position, XORing it with current background.
 *  The pixels of the character are drawn by XORing the foreground color with existing background.
 *  The pixels OFF are ignored, leaving existing background untouched.
 *  NB: The background color is not used in this mode.
 *  NB: Characters with codes from 0 to 31 are displayed using current font and don't have any control effect.
 *	@param row the character line number (0 = top screen)
 *	@param col the character column (0 = left)
 *	@param c the character code from 0 to 255.
 */
void gfx_putc_XOR( unsigned int row, unsigned int col, unsigned char c )
{
    if( col >= ctx.term.WIDTH )
        return;
    if( row >= ctx.term.HEIGHT )
        return;

    const unsigned int pixcol = col * ctx.term.FONTWIDTH;
    const unsigned int pixrow = row * ctx.term.FONTHEIGHT;
	const unsigned int byte_stride = ctx.Pitch - ctx.term.FONTWIDTH;
	register unsigned char* p_glyph = (unsigned char*)ctx.term.font_getglyph(c);
	register unsigned char h = ctx.term.FONTHEIGHT;
	register unsigned char* pf = (unsigned char*)PFB(pixcol, pixrow);
	while( h-- )
	{
		unsigned int w = ctx.term.FONTWIDTH;
		while( w-- )
		{
			register unsigned char gv = *p_glyph++;
			if (gv)
				*pf = ctx.fg ^ gv;
			pf++;
		}
		pf += byte_stride;
	}
}

/** Displays a character at a position in transparent mode.
 *  The pixels of the character are drawn with the foreground color.
 *  The pixels OFF are ignored, leaving existing background untouched.
 *  NB: The background color is not used in this mode.
 *  NB: The transparent color is not used for drawing characters.
 *  NB: Characters with codes from 0 to 31 are displayed using current font and don't have any control effect.
 *	@param row the character line number (0 = top screen)
 *	@param col the character column (0 = left)
 *	@param c the character code from 0 to 255.
 */
void gfx_putc_TRANSPARENT( unsigned int row, unsigned int col, unsigned char c )
{
    if( col >= ctx.term.WIDTH )
        return;
    if( row >= ctx.term.HEIGHT )
        return;

    const unsigned int pixcol = col * ctx.term.FONTWIDTH;
    const unsigned int pixrow = row * ctx.term.FONTHEIGHT;
	const unsigned int byte_stride = ctx.Pitch - ctx.term.FONTWIDTH;
	register unsigned char* p_glyph = (unsigned char*)ctx.term.font_getglyph(c);
	register unsigned char h = ctx.term.FONTHEIGHT;
	register unsigned char* pf = (unsigned char*)PFB(pixcol, pixrow);
	while( h-- )
	{
		unsigned int w = ctx.term.FONTWIDTH;
		while( w-- )
		{
			register unsigned char gv = *p_glyph++;
			if (gv)
				*pf = ctx.fg;
			pf++;
		}
		pf += byte_stride;
	}
}

/** Displays a character in current drawing mode. Characters with codes from 0 to 31
 *  are displayed using current font and don't have any control effect.
 *	@param row the character line number (0 = top screen)
 *	@param col the character column (0 = left)
 *	@param c the character code from 0 to 255.
 */
draw_putc_fun (*gfx_putc) = &gfx_putc_NORMAL;

/** Sets the drawing mode for sprites and characters.
 * For Sprites, transparent mode uses the transparent color (00 by default).
 * @param mode the new drawing mode: drawingNORMAL, drawingXOR or drawingTRANSPARENT.
 */
void gfx_set_drawing_mode( DRAWING_MODE mode )
{
	ctx.mode = mode;
	switch (mode)
	{
	case drawingNORMAL:
		gfx_putc = gfx_putc_NORMAL;
		gfx_put_sprite = gfx_put_sprite_NORMAL;
		break;
	case drawingXOR:
		gfx_putc = gfx_putc_XOR;
		gfx_put_sprite = gfx_put_sprite_XOR;
		break;
	case drawingTRANSPARENT:
		gfx_putc = gfx_putc_TRANSPARENT;
		gfx_put_sprite = gfx_put_sprite_TRANSPARENT;
		break;
	}
}

/** Restore saved content under cursor.
 *
 */
void gfx_restore_cursor_content()
{
	if (!ctx.cursor_buffer_ready) return;

    unsigned char* pb = ctx.cursor_buffer;
    unsigned char* pfb = (unsigned char*)PFB( ctx.term.cursor_col * ctx.term.FONTWIDTH, ctx.term.cursor_row * ctx.term.FONTHEIGHT );
    const unsigned int byte_stride = ctx.Pitch - ctx.term.FONTWIDTH;
    unsigned int h = ctx.term.FONTHEIGHT;
    while(h--)
    {
    	unsigned int w = ctx.term.FONTWIDTH;
    	while (w--)
    	{
    		*pfb++ = *pb++;
    	}
        pfb += byte_stride;
    }

    //cout("cursor restored");cout_d(ctx.term.cursor_row);cout("-");cout_d(ctx.term.cursor_col);cout_endl();
}

/** Saves framebuffer content in the cursor bufffer so t can be restored later. */
void gfx_term_save_cursor_content()
{
	unsigned char* pb = ctx.cursor_buffer;
	unsigned char* pfb = (unsigned char*)PFB(
	ctx.term.cursor_col * ctx.term.FONTWIDTH,
	ctx.term.cursor_row * ctx.term.FONTHEIGHT );
	const unsigned int byte_stride = ctx.Pitch - ctx.term.FONTWIDTH;//$$ adjust if not 8 width?
	unsigned int h = ctx.term.FONTHEIGHT;
	while(h--)
    {
    	int w = ctx.term.FONTWIDTH;
    	while (w--)
    	{
    		*pb++ = *pfb++;
    	}
        pfb += byte_stride;
    }
	ctx.cursor_buffer_ready = 1;
}

/** Saves framebuffer content that is going to be replaced by the cursor and update
	the new content.
*/
void gfx_term_render_cursor()
{

    unsigned char* pb = ctx.cursor_buffer;
    //cout("pb: "); cout_h((unsigned int)pb);cout_endl();
    unsigned char* pfb = (unsigned char*)PFB(
    		ctx.term.cursor_col * ctx.term.FONTWIDTH,
    		ctx.term.cursor_row * ctx.term.FONTHEIGHT );
    //cout("pfb: "); cout_h((unsigned int)pfb);cout_endl();
    const unsigned int byte_stride = ctx.Pitch - ctx.term.FONTWIDTH;//$$ adjust if not 8 width?
    //cout("byte_stride: "); cout_d(byte_stride);  cout(" pitch: "); cout_d(ctx.Pitch); cout(" FONTWIDTH: "); cout_d(ctx.term.FONTWIDTH);cout_endl();
    unsigned int h = ctx.term.FONTHEIGHT;
    //cout("h: "); cout_d(h);cout_endl();

    if( ctx.term.cursor_visible )
        while(h--)
        {
        	int w = ctx.term.FONTWIDTH;
        	while (w--)
        	{
        		*pb++ = *pfb; *pfb = ~*pfb; pfb++;
        	}
            pfb += byte_stride;
        }
    else
        while(h--)
        {
        	int w = ctx.term.FONTWIDTH;
        	while (w--)
        	{
        		*pb++ = *pfb++;
        	}
            pfb += byte_stride;
        }
    ctx.cursor_buffer_ready = 1;
}

/** shifts content from cursor 1 character to the right */
void gfx_term_shift_right()
{
    if (PiGfxConfig.disableGfxDMA)
    {
        for (unsigned int i=0; i<ctx.term.FONTHEIGHT; i++)
        {
            unsigned int* src = (unsigned int*)PFB(ctx.W-4-ctx.term.FONTWIDTH, ctx.term.cursor_row * ctx.term.FONTHEIGHT + i);
            unsigned int* dst = (unsigned int*)PFB(ctx.W-4, ctx.term.cursor_row * ctx.term.FONTHEIGHT + i);
            unsigned int* end = (unsigned int*)PFB(ctx.term.cursor_col * ctx.term.FONTWIDTH, ctx.term.cursor_row * ctx.term.FONTHEIGHT + i);
            while (src >= end)
            {
                *dst-- = *src--;
            }
        }
    }
    else
    {
        dma_enqueue_operation( PFB((ctx.term.cursor_col) * ctx.term.FONTWIDTH, ctx.term.cursor_row * ctx.term.FONTHEIGHT),
                            PFB((ctx.term.cursor_col+1) * ctx.term.FONTWIDTH, ctx.term.cursor_row * ctx.term.FONTHEIGHT),
                            (((ctx.term.FONTHEIGHT-1) & 0xFFFF )<<16) | ((ctx.term.WIDTH-ctx.term.cursor_col-1)*ctx.term.FONTWIDTH & 0xFFFF ),
                            ((((ctx.term.cursor_col+1)*ctx.term.FONTWIDTH) & 0xFFFF)<<16 | (((ctx.term.cursor_col+1)*ctx.term.FONTWIDTH) & 0xFFFF)), /* bits 31:16 destination stride, 15:0 source stride */
                            DMA_TI_DEST_INC | DMA_TI_2DMODE | DMA_TI_SRC_INC );
        dma_execute_queue();
    }
}

/** shifts content right of cursor 1 character to the left */
void gfx_term_shift_left()
{
    if (PiGfxConfig.disableGfxDMA)
    {
        for (unsigned int i=0; i<ctx.term.FONTHEIGHT; i++)
        {
            veryfastmemcpy(PFB((ctx.term.cursor_col) * ctx.term.FONTWIDTH, ctx.term.cursor_row * ctx.term.FONTHEIGHT + i),
                           PFB((ctx.term.cursor_col+1) * ctx.term.FONTWIDTH, ctx.term.cursor_row * ctx.term.FONTHEIGHT + i),
                           (ctx.term.WIDTH-ctx.term.cursor_col)*ctx.term.FONTWIDTH);
        }
    }
    else
    {
        dma_enqueue_operation( PFB((ctx.term.cursor_col+1) * ctx.term.FONTWIDTH, ctx.term.cursor_row * ctx.term.FONTHEIGHT),
                            PFB((ctx.term.cursor_col) * ctx.term.FONTWIDTH, ctx.term.cursor_row * ctx.term.FONTHEIGHT),
                            (((ctx.term.FONTHEIGHT-1) & 0xFFFF )<<16) | ((ctx.term.WIDTH-ctx.term.cursor_col)*ctx.term.FONTWIDTH & 0xFFFF ),
                            (((ctx.term.cursor_col*ctx.term.FONTWIDTH) & 0xFFFF)<<16 | ((ctx.term.cursor_col*ctx.term.FONTWIDTH) & 0xFFFF)), /* bits 31:16 destination stride, 15:0 source stride */
                            DMA_TI_DEST_INC | DMA_TI_2DMODE | DMA_TI_SRC_INC );
        dma_execute_queue();
    }
}

/** restore cursor content
    move line content from cursor 1 position to the right
   insert blank
   redraw cursor */
void gfx_term_insert_blank()
{
    gfx_restore_cursor_content();
    gfx_term_shift_right();
    gfx_clear_rect( ctx.term.cursor_col * ctx.term.FONTWIDTH, ctx.term.cursor_row * ctx.term.FONTHEIGHT, ctx.term.FONTWIDTH, ctx.term.FONTHEIGHT );
    gfx_term_render_cursor();
}

/** move line content from right of cursor cursor 1 position to the left
    fill last character with bg
    restore cursor */
void gfx_term_delete_char()
{
    if (ctx.term.cursor_col < (ctx.term.WIDTH-1))
    {
        gfx_term_shift_left();
    }
    gfx_clear_rect( (ctx.term.WIDTH-1) * ctx.term.FONTWIDTH, ctx.term.cursor_row * ctx.term.FONTHEIGHT, ctx.term.FONTWIDTH, ctx.term.FONTHEIGHT );
    gfx_term_render_cursor();
}

/** Insert blank line at current row (shift screen down) */
void gfx_term_insert_line()
{
    unsigned int size = ctx.term.WIDTH*ctx.term.FONTWIDTH*ctx.term.FONTHEIGHT;

    gfx_restore_cursor_content();

    for(int i=ctx.term.HEIGHT-2;i>=(int)ctx.term.cursor_row; i--)
    {
        if (PiGfxConfig.disableGfxDMA)
        {
            veryfastmemcpy(PFB((0), (i+1) * ctx.term.FONTHEIGHT), PFB((0), i * ctx.term.FONTHEIGHT), size);
        }
        else
        {
            dma_memcpy_32(PFB((0), i * ctx.term.FONTHEIGHT), PFB((0), (i+1) * ctx.term.FONTHEIGHT), size);
        }
    }

    unsigned int* pos = (unsigned int*)PFB(0, ctx.term.cursor_row * ctx.term.FONTHEIGHT);
    for(unsigned int i=0; i<size/4;i++)
    {
        *pos++=ctx.bg32;
    }

    gfx_term_render_cursor();
}

// Delete the current line (shift screen up)
void gfx_term_delete_line()
{
    unsigned int size;

    if (ctx.term.cursor_row < ctx.term.HEIGHT-2)
    {
        size = ctx.term.WIDTH*ctx.term.FONTWIDTH*ctx.term.FONTHEIGHT*(ctx.term.HEIGHT-1-ctx.term.cursor_row);
        if (PiGfxConfig.disableGfxDMA)
        {
            veryfastmemcpy(PFB((0), ctx.term.cursor_row * ctx.term.FONTHEIGHT), PFB((0), (ctx.term.cursor_row+1) * ctx.term.FONTHEIGHT), size);
        }
        else
        {
            dma_memcpy_32(PFB((0), (ctx.term.cursor_row+1) * ctx.term.FONTHEIGHT), PFB((0), ctx.term.cursor_row * ctx.term.FONTHEIGHT), size);
        }
    }

    unsigned int* pos = (unsigned int*)PFB(0, (ctx.term.HEIGHT-1) * ctx.term.FONTHEIGHT);
    size = ctx.term.WIDTH*ctx.term.FONTWIDTH*ctx.term.FONTHEIGHT;
    for(unsigned int i=0; i<size/4;i++)
    {
        *pos++=ctx.bg32;
    }

    gfx_term_render_cursor();
}

/** Fill cursor buffer with the current background and framebuffer with fg.
 */
void gfx_term_render_cursor_newline()
{
    //
    const unsigned int BG = ctx.bg32; // 4 pixels
    unsigned int nwords = ctx.cursor_buffer_size / 4;
    unsigned int* pb = (unsigned int*)ctx.cursor_buffer;
    while( nwords-- )
    {
        *pb++ = BG;
    }

    if( ctx.term.cursor_visible )
        gfx_fill_rect( ctx.term.cursor_col * ctx.term.FONTWIDTH, ctx.term.cursor_row * ctx.term.FONTHEIGHT, ctx.term.FONTWIDTH, ctx.term.FONTHEIGHT );
}

// check if loading bitmap
unsigned char gfx_term_loading_bitmap()
{
    return ctx.bitmaploader.loading;
}

// load bitmap data from serial
void gfx_term_load_bitmap(char pixel)
{
    char* dest = 0;
    unsigned char nbPixels, i;

    if (ctx.bitmaploader.asciiMode)
    {
        // Convert data to binary
        if (pixel == ';')
        {
            // process binary data
            pixel = ctx.bitmaploader.asciiByte;
            ctx.bitmaploader.asciiByte = 0;
        }
        else if ((ctx.bitmaploader.asciiBase == 10) && (pixel >= '0') && (pixel <= '9'))
        {
            ctx.bitmaploader.asciiByte = ctx.bitmaploader.asciiByte * 10 + pixel - '0';
            return;
        }
        else if (ctx.bitmaploader.asciiBase == 16)
        {
            if ((pixel >= '0') && (pixel <= '9')) ctx.bitmaploader.asciiByte = ctx.bitmaploader.asciiByte * 16 + pixel - '0';
            else if ((pixel >= 'A') && (pixel <= 'F')) ctx.bitmaploader.asciiByte = ctx.bitmaploader.asciiByte * 16 + pixel - 'A' + 10;
            else if ((pixel >= 'a') && (pixel <= 'f')) ctx.bitmaploader.asciiByte = ctx.bitmaploader.asciiByte * 16 + pixel - 'a' + 10;
            else
            {
                // syntax error
                ctx.bitmaploader.loading = 0;
            }
            return;
        }
        else
        {
            // syntax error
            ctx.bitmaploader.loading = 0;
            return;
        }

    }

    dest = (char*)ctx.bitmap[ctx.bitmaploader.index]+8+ctx.bitmaploader.actPos;
    if (ctx.bitmaploader.rleCompressed)
    {
        if ((ctx.bitmaploader.chars & 1) == 0)    // pixel info
        {
            *dest = pixel;
        }
        else    // repeat
        {
            nbPixels = pixel;
            pixel = *dest;

            for (i=0;i<nbPixels;i++)
            {
                *dest++ = pixel;
                ctx.bitmaploader.actPos++;
                if (ctx.bitmaploader.actPos >= ctx.bitmaploader.pixels)
                {
                    // finished
                    ctx.bitmaploader.loading = 0;
#if RPI == 1
                    CleanDataCache();
#else
                    CleanDataCacheRange((unsigned int)ctx.bitmap[ctx.bitmaploader.index], ctx.bitmaploader.pixels+8);
#endif
                    break;
                }
            }
        }
        ctx.bitmaploader.chars++;
    }
    else
    {
        *dest = pixel;
        ctx.bitmaploader.actPos++;
        if (ctx.bitmaploader.actPos >= ctx.bitmaploader.pixels)
        {
            // finished
            ctx.bitmaploader.loading = 0;
#if RPI == 1
            CleanDataCache();
#else
            CleanDataCacheRange((unsigned int)ctx.bitmap[ctx.bitmaploader.index], ctx.bitmaploader.pixels+8);
#endif
        }
    }
}

// check if loading palette
unsigned char gfx_term_loading_palette()
{
    return ctx.paletteloader.loading;
}

// load palette data from serial
void gfx_term_load_palette(char rgb)
{
    if (rgb == ';')
    {
        ctx.paletteloader.pCustPal[ctx.paletteloader.colorIdx++] = ctx.paletteloader.color;
        ctx.paletteloader.color = 0;
        if (ctx.paletteloader.colorIdx >= ctx.paletteloader.nbColors)
        {
            // finished
            ctx.paletteloader.loading = 0;
        }
    }
    else if ((ctx.paletteloader.asciiBase == 10) && (rgb >= '0') && (rgb <= '9'))
    {
        ctx.paletteloader.color = ctx.paletteloader.color * 10 + rgb - '0';
    }
    else if (ctx.paletteloader.asciiBase == 16)
    {
        if ((rgb >= '0') && (rgb <= '9')) ctx.paletteloader.color = ctx.paletteloader.color * 16 + rgb - '0';
        else if ((rgb >= 'A') && (rgb <= 'F')) ctx.paletteloader.color = ctx.paletteloader.color * 16 + rgb - 'A' + 10;
        else if ((rgb >= 'a') && (rgb <= 'f')) ctx.paletteloader.color = ctx.paletteloader.color * 16 + rgb - 'a' + 10;
        else
        {
            // syntax error
            ctx.paletteloader.loading = 0;
        }
    }
    else
    {
        // syntax error
        ctx.paletteloader.loading = 0;
    }
}

/** Draws a character string and handle control characters. */
void gfx_term_putstring( const char* str )
{
    while( *str )
    {
		if (gfx_term_loading_palette())
		{
			gfx_term_load_palette(*str++);
			continue;
		}
		if (gfx_term_loading_bitmap())
		{
			gfx_term_load_bitmap(*str++);
			continue;
		}
        int checkscroll = 1;
        switch( *str )
        {
            case '\r':
                gfx_restore_cursor_content();
                ctx.term.cursor_col = 0;
                if( ctx.term.cursor_row < ctx.term.HEIGHT ) gfx_term_render_cursor();
                break;

            case '\n':
                gfx_restore_cursor_content();
                ++ctx.term.cursor_row;
                ctx.term.cursor_col = 0;
                if( ctx.term.cursor_row < ctx.term.HEIGHT ) gfx_term_render_cursor();
                break;

            case 0x09: /* tab */
                gfx_restore_cursor_content();
                ctx.term.cursor_col += 1;
                ctx.term.cursor_col =  MIN( ctx.term.cursor_col + ctx.term.tab_pos - ctx.term.cursor_col%ctx.term.tab_pos, ctx.term.WIDTH-1 );
                gfx_term_render_cursor();
                break;

            case 0x08:
            case 0x7F:
                /* backspace */
                if( ctx.term.cursor_col>0 )
                {
                    gfx_restore_cursor_content();
                    --ctx.term.cursor_col;
                    gfx_clear_rect( ctx.term.cursor_col*ctx.term.FONTWIDTH, ctx.term.cursor_row*ctx.term.FONTHEIGHT, ctx.term.FONTWIDTH, ctx.term.FONTHEIGHT );
                    gfx_term_render_cursor();
                }
                break;

            case 0xC:
                /* new page */
                gfx_term_move_cursor(0,0);
                gfx_term_clear_screen();
                break;


            default:
            	checkscroll = ctx.term.state.next( *str, &(ctx.term.state) );
                break;
        }

        if( checkscroll && (ctx.term.cursor_col >= ctx.term.WIDTH ))
        {
            gfx_restore_cursor_content();
            ++ctx.term.cursor_row;
            ctx.term.cursor_col = 0;
            gfx_term_render_cursor();
        }

        if( checkscroll && (ctx.term.cursor_row >= ctx.term.HEIGHT ))
        {
            gfx_restore_cursor_content();
            --ctx.term.cursor_row;

            gfx_scroll_down(ctx.term.FONTHEIGHT);
            gfx_term_render_cursor_newline();
        }

        ++str;
    }
}


void gfx_term_set_cursor_visibility( unsigned char visible )
{
    ctx.term.cursor_visible = visible;
}

void gfx_term_switch_cursor_vis( __attribute__((unused)) unsigned hnd,
                                      __attribute__((unused)) void* pParam,
                                      __attribute__((unused)) void *pContext )
{
    if (ctx.term.cursor_visible)
    {
        gfx_term_set_cursor_visibility(0);
        gfx_restore_cursor_content();
    }
    else
    {
        gfx_term_set_cursor_visibility(1);
        gfx_term_render_cursor();
    }
    ctx.term.blink_timer_hnd = attach_timer_handler(2, &gfx_term_switch_cursor_vis, 0, 0);
}

void gfx_term_set_cursor_blinking( unsigned char blink )
{
    ctx.term.cursor_blink = blink;
    remove_timer(ctx.term.blink_timer_hnd);     // it's okay to be 0
    if (blink)
    {
        ctx.term.blink_timer_hnd = attach_timer_handler(2, &gfx_term_switch_cursor_vis, 0, 0);
    }
}


void gfx_term_move_cursor( unsigned int row, unsigned int col )
{
    gfx_restore_cursor_content();
    ctx.term.cursor_row = MIN(ctx.term.HEIGHT-1, row );
    ctx.term.cursor_col = MIN(ctx.term.WIDTH-1, col );
    gfx_term_render_cursor();
}


void gfx_term_move_cursor_d( int delta_row, int delta_col )
{
    if( (int)ctx.term.cursor_col+delta_col < 0 )
        delta_col = 0;

    if( (int)ctx.term.cursor_row+delta_row < 0 )
        delta_row = 0;
    gfx_term_move_cursor( ctx.term.cursor_row+delta_row, ctx.term.cursor_col+delta_col );
}


void gfx_term_save_cursor()
{
    ctx.term.saved_cursor[0] = ctx.term.cursor_row;
    ctx.term.saved_cursor[1] = ctx.term.cursor_col;
}


void gfx_term_restore_cursor()
{
    gfx_restore_cursor_content();
    ctx.term.cursor_row = ctx.term.saved_cursor[0];
    ctx.term.cursor_col = ctx.term.saved_cursor[1];
    gfx_term_render_cursor();
}


void gfx_term_clear_till_end()
{
    gfx_swap_fg_bg();
    gfx_fill_rect( ctx.term.cursor_col * ctx.term.FONTWIDTH, ctx.term.cursor_row * ctx.term.FONTHEIGHT, ctx.W, ctx.term.FONTHEIGHT );
    gfx_swap_fg_bg();
    gfx_term_render_cursor();
}


void gfx_term_clear_till_cursor()
{
    gfx_swap_fg_bg();
    gfx_fill_rect( 0, ctx.term.cursor_row * ctx.term.FONTHEIGHT, (ctx.term.cursor_col+1) * ctx.term.FONTWIDTH, ctx.term.FONTHEIGHT );
    gfx_swap_fg_bg();
    gfx_term_render_cursor();
}


void gfx_term_clear_line()
{
    gfx_swap_fg_bg();
    gfx_fill_rect( 0, ctx.term.cursor_row*ctx.term.FONTHEIGHT, ctx.W, ctx.term.FONTHEIGHT );
    gfx_swap_fg_bg();
    gfx_term_render_cursor();
}


void gfx_term_clear_screen()
{
    gfx_clear();
    gfx_term_render_cursor();
}

void gfx_term_clear_screen_from_here()
{
    if ( ctx.term.cursor_row < (ctx.term.HEIGHT-1) )
    {
        gfx_swap_fg_bg();
        gfx_fill_rect( 0, (ctx.term.cursor_row+1) * ctx.term.FONTHEIGHT, ctx.W, ctx.H );
        gfx_swap_fg_bg();
    }
    gfx_term_clear_till_end();
}

void gfx_term_clear_screen_to_here()
{
    if ( ctx.term.cursor_row > 0 )
    {
        gfx_swap_fg_bg();
        gfx_fill_rect( 0, 0, ctx.W, ctx.term.cursor_row * ctx.term.FONTHEIGHT );
        gfx_swap_fg_bg();
    }
    gfx_term_clear_till_cursor();
}

/** Set the font. */
void gfx_term_set_font(int width, int height)
{
	if (width == 8)
	{
		switch (height)
		{
		case 8:
			ctx.term.FONT = &G_FONT8X8_GLYPHS;
			ctx.term.FONTWIDTH = 8;
			ctx.term.FONTHEIGHT = 8;
			ctx.term.font_getglyph = font_get_glyph_address_8x8;
			gfx_compute_font();
			break;
		case 16:
			ctx.term.FONT = &G_FONT8X16_GLYPHS;
			ctx.term.FONTWIDTH = 8;
			ctx.term.FONTHEIGHT = 16;
			ctx.term.font_getglyph = font_get_glyph_address_8x16;
			gfx_compute_font();
			break;
		case 24:
			ctx.term.FONT = &G_FONT8X24_GLYPHS;
			ctx.term.FONTWIDTH = 8;
			ctx.term.FONTHEIGHT = 24;
			ctx.term.font_getglyph = font_get_glyph_address_8x24;
			gfx_compute_font();
			break;
		}
		//cout("ctx.term.FONTWIDTH: ");cout_d(ctx.term.FONTWIDTH);cout_endl();
        //cout("ctx.term.FONTHEIGHT: ");cout_d(ctx.term.FONTHEIGHT);cout_endl();
	}
}

/** Sets the tabulation width. */
void gfx_term_set_tabulation(int width)
{
	if (width < 0) width = 8;
	if (width > (int)ctx.term.WIDTH) width = (int)ctx.term.WIDTH;
	ctx.term.tab_pos = (unsigned int)width;
}

/**  Term ANSI prefix code */
#define TERM_ESCAPE_CHAR (0x1B)

/** State parsing functions */

/** Parse the last letter in ANSI sequence.
 *  Normal ANSI escape sequences assume previous parameters are stored as numbers in state->cmd_params[].
 *
 *  state->private_mode_char can hold a character in which case the process is not
 *  following ANSI or VT100 specifications:
 *
 *      ESC[# implements graphic commands and tests (prioritary)
 *      ESC[= implements settings change: mode (PC ANSI.SYS), font, tab width
 *      ESC[? implements some ANSI commands (save/restore cursor content)
 *
 *  Any other character will end the sequence.
 *
 *  @param ch the character to scan
 *	@param state points to the current state structure
 *	@return 1 if the terminal should handle line break and screen scroll returning from this call.
 *
 */
int state_fun_final_letter( char ch, scn_state *state )
{
	int retval = 1;// handle line break and screen scroll by default
    if( state->private_mode_char == '#' )
    {
        // Non-standard graphic commands and additionam features
        switch( ch )
        {
            case 'l':
                /* render line */
                if( state->cmd_params_size == 4 )
                {
                    gfx_line( state->cmd_params[0], state->cmd_params[1], state->cmd_params[2], state->cmd_params[3] );
                }
                retval = 0; // no terminal line break/scroll
            goto back_to_normal;
            break;
            case 'r':
                /* render a filled rectangle */
                if( state->cmd_params_size == 4 )
                {
                    gfx_fill_rect( state->cmd_params[0], state->cmd_params[1], state->cmd_params[2], state->cmd_params[3] );
                }
                retval = 0;
            goto back_to_normal;
            break;
            case 'R':
                /* render a rectangle */
                if( state->cmd_params_size == 4 )
                {
                    // x0;y0;width;height;
                    gfx_line( state->cmd_params[0], state->cmd_params[1], state->cmd_params[0]+state->cmd_params[2], state->cmd_params[1] ); // x0/y0 to x1/y0
                    gfx_line( state->cmd_params[0], state->cmd_params[1], state->cmd_params[0], state->cmd_params[1]+state->cmd_params[3] ); // x0/y0 to x0/y1
                    gfx_line( state->cmd_params[0]+state->cmd_params[2], state->cmd_params[1], state->cmd_params[0]+state->cmd_params[2], state->cmd_params[1]+state->cmd_params[3] ); // x1/y0 to x1/y1
                    gfx_line( state->cmd_params[0], state->cmd_params[1]+state->cmd_params[3], state->cmd_params[0]+state->cmd_params[2], state->cmd_params[1]+state->cmd_params[3] ); // x0/y1 to x1/y1
                }
                retval = 0; // no terminal line break/scroll
            goto back_to_normal;
            break;
            case 'C':
                /* render a circle */
                if (state->cmd_params_size == 3)
                {
                    gfx_draw_circle(state->cmd_params[0], state->cmd_params[1], state->cmd_params[2]);  // x, y, radius
                }
                retval = 0;
            goto back_to_normal;
            break;
            case 'c':
                /* render a filled circle */
                if (state->cmd_params_size == 3)
                {
                    gfx_draw_filled_circle(state->cmd_params[0], state->cmd_params[1], state->cmd_params[2]);  // x, y, radius
                }
                retval = 0;
            goto back_to_normal;
            break;
            case 'T':
                /* render a triangle */
                if (state->cmd_params_size == 6)
                {
                    gfx_line( state->cmd_params[0], state->cmd_params[1], state->cmd_params[2], state->cmd_params[3] );
                    gfx_line( state->cmd_params[2], state->cmd_params[3], state->cmd_params[4], state->cmd_params[5] );
                    gfx_line( state->cmd_params[4], state->cmd_params[5], state->cmd_params[0], state->cmd_params[1] );
                }
                retval = 0;
            goto back_to_normal;
            break;

            case 'a':
            case 'A':
                // load a bitmap ASCII encoded
                // expects bitmap index, x size, y size, encoding base (10 or 16)
                // followed by x*y ASCII encoded color indexes for pixels (decimal or hex)
                // A is RLE compressed
                if (state->cmd_params_size == 4)
                {
                    if ((state->cmd_params[0] < MAXBITMAPS) && (state->cmd_params[1]) && (state->cmd_params[2]) && ((state->cmd_params[3] == 10) || (state->cmd_params[3] == 16)))
                    {
                        // release old data
                        if (ctx.bitmap[state->cmd_params[0]]) nmalloc_free(ctx.bitmap[state->cmd_params[0]]);

                        // alloc mem
                        ctx.bitmap[state->cmd_params[0]] = nmalloc_malloc(8+state->cmd_params[1]*state->cmd_params[2]);    // Header 8 bytes for x and y, then data
                        if (ctx.bitmap[state->cmd_params[0]])
                        {
                            ctx.bitmaploader.loading = 1;
                            uint32_t* px = (uint32_t*)ctx.bitmap[state->cmd_params[0]];
                            uint32_t* py = px+1;
                            *px = state->cmd_params[1];
                            *py = state->cmd_params[2];
                            ctx.bitmaploader.pixels = state->cmd_params[1]*state->cmd_params[2];
                            ctx.bitmaploader.actPos = 0;
                            ctx.bitmaploader.index = state->cmd_params[0];
                            if (ch == 'A') ctx.bitmaploader.rleCompressed = 1; else ctx.bitmaploader.rleCompressed = 0;
                            ctx.bitmaploader.chars = 0;
                            ctx.bitmaploader.asciiByte = 0;
                            ctx.bitmaploader.asciiMode = 1;
                            ctx.bitmaploader.asciiBase = state->cmd_params[3];
                        }
                    }
                }
                retval = 0;
            goto back_to_normal;
            break;

            case 'b':
            case 'B':
                // load a bitmap
                // expects bitmap index, x size, y size
                // followed by x*y bytes with color indexes for pixels
                // B is RLE compressed
                if (state->cmd_params_size == 3)
                {
                    if ((state->cmd_params[0] < MAXBITMAPS) && (state->cmd_params[1]) && (state->cmd_params[2]))
                    {
                        // release old data
                        if (ctx.bitmap[state->cmd_params[0]]) nmalloc_free(ctx.bitmap[state->cmd_params[0]]);

                        // alloc mem
                        ctx.bitmap[state->cmd_params[0]] = nmalloc_malloc(8+state->cmd_params[1]*state->cmd_params[2]);    // Header 8 bytes for x and y, then data
                        if (ctx.bitmap[state->cmd_params[0]])
                        {
                            ctx.bitmaploader.loading = 1;
                            uint32_t* px = (uint32_t*)ctx.bitmap[state->cmd_params[0]];
                            uint32_t* py = px+1;
                            *px = state->cmd_params[1];
                            *py = state->cmd_params[2];
                            ctx.bitmaploader.pixels = state->cmd_params[1]*state->cmd_params[2];
                            ctx.bitmaploader.actPos = 0;
                            ctx.bitmaploader.index = state->cmd_params[0];
                            if (ch == 'B') ctx.bitmaploader.rleCompressed = 1; else ctx.bitmaploader.rleCompressed = 0;
                            ctx.bitmaploader.chars = 0;
                            ctx.bitmaploader.asciiMode = 0;
                        }
                    }
                }
                retval = 0;
            goto back_to_normal;
            break;

            case 'd':
                /* draw a bitmap */
                if (state->cmd_params_size == 3)
                {
                    // expects bitmap index, x, y
                    if (state->cmd_params[0] < MAXBITMAPS)
                    {
                        gfx_put_sprite(ctx.bitmap[state->cmd_params[0]], state->cmd_params[1], state->cmd_params[2]);
                    }
                }
                retval = 0;
            goto back_to_normal;
            break;

            case 's':
                /* draw a sprite */
                if (state->cmd_params_size == 4)
                {
                    // expects sprite index, bitmap ref, x, y
                    if ((state->cmd_params[0] < MAXSPRITES) && (state->cmd_params[1] < MAXBITMAPS))
                    {
                        // If the sprite is active we must restore the background
                        gfx_remove_sprite(state->cmd_params[0]);

                        // Is the referenced bitmap available?
                        if (ctx.bitmap[state->cmd_params[1]])
                        {
                            unsigned int* pW = (unsigned int*)ctx.bitmap[state->cmd_params[1]];
                            unsigned int* pH = pW+1;
                            gfx_save_background(&ctx.sprite[state->cmd_params[0]], ctx.bitmap[state->cmd_params[1]], state->cmd_params[2], state->cmd_params[3]);
                            gfx_put_sprite(ctx.bitmap[state->cmd_params[1]], state->cmd_params[2], state->cmd_params[3]);

                            // Save drawing mode and transparentcolor
                            ctx.sprite[state->cmd_params[0]].mode = ctx.mode;
                            ctx.sprite[state->cmd_params[0]].transparentcolor = ctx.transparentcolor;

                            // Draw sprite
                            ctx.sprite[state->cmd_params[0]].active = 1;
                            ctx.sprite[state->cmd_params[0]].bitmapRef = state->cmd_params[1];
                            ctx.sprite[state->cmd_params[0]].x = state->cmd_params[2];
                            ctx.sprite[state->cmd_params[0]].y = state->cmd_params[3];
                            ctx.sprite[state->cmd_params[0]].width = *pW;
                            ctx.sprite[state->cmd_params[0]].height = *pH;

                            if (state->cmd_params[0] > ctx.lastUsedSprite) ctx.lastUsedSprite = state->cmd_params[0];

                            // Set collision detection rectangle
                            ctx.sprite[state->cmd_params[0]].colDetRect.min.x = ctx.sprite[state->cmd_params[0]].x;
                            ctx.sprite[state->cmd_params[0]].colDetRect.min.y = ctx.sprite[state->cmd_params[0]].y;
                            ctx.sprite[state->cmd_params[0]].colDetRect.max.x = ctx.sprite[state->cmd_params[0]].x + *pW-1;
                            ctx.sprite[state->cmd_params[0]].colDetRect.max.y = ctx.sprite[state->cmd_params[0]].y + *pH-1;

                            gfx_check_collision(state->cmd_params[0]);

                        }
                    }
                }
                retval = 0;
            goto back_to_normal;
            break;

            case 'x':
                /* remove a sprite */
                if (state->cmd_params_size == 1)
                {
                    // expects sprite index
                    if (state->cmd_params[0] < MAXBITMAPS)
                    {
                        gfx_remove_sprite(state->cmd_params[0]);
                    }
                }
                retval = 0;
            goto back_to_normal;
            break;

            case 'm':
                /* move a sprite to a new position */
                if (state->cmd_params_size == 3)
                {
                    // expects sprite index, x, y
                    if ((state->cmd_params[0] < MAXSPRITES) && (ctx.sprite[state->cmd_params[0]].active))
                    {
                        gfx_remove_sprite(state->cmd_params[0]);

                        gfx_save_background(&ctx.sprite[state->cmd_params[0]], ctx.bitmap[ctx.sprite[state->cmd_params[0]].bitmapRef], state->cmd_params[1], state->cmd_params[2]);

                        if (ctx.sprite[state->cmd_params[0]].mode == drawingNORMAL)
                            gfx_put_sprite_NORMAL(ctx.bitmap[ctx.sprite[state->cmd_params[0]].bitmapRef], state->cmd_params[1], state->cmd_params[2]);
                        else if (ctx.sprite[state->cmd_params[0]].mode == drawingXOR)
                            gfx_put_sprite_XOR(ctx.bitmap[ctx.sprite[state->cmd_params[0]].bitmapRef], state->cmd_params[1], state->cmd_params[2]);
                        else
                        {
                            unsigned char saveColor = ctx.transparentcolor;
                            ctx.transparentcolor = ctx.sprite[state->cmd_params[0]].transparentcolor;
                            gfx_put_sprite_TRANSPARENT(ctx.bitmap[ctx.sprite[state->cmd_params[0]].bitmapRef], state->cmd_params[1], state->cmd_params[2]);
                            ctx.transparentcolor = saveColor;
                        }

                        unsigned int* pW = (unsigned int*)ctx.bitmap[ctx.sprite[state->cmd_params[0]].bitmapRef];
                        unsigned int* pH = pW+1;

                        ctx.sprite[state->cmd_params[0]].active = 1;
                        ctx.sprite[state->cmd_params[0]].x = state->cmd_params[1];
                        ctx.sprite[state->cmd_params[0]].y = state->cmd_params[2];
                        ctx.sprite[state->cmd_params[0]].width = *pW;
                        ctx.sprite[state->cmd_params[0]].height = *pH;

                        if (state->cmd_params[0] > ctx.lastUsedSprite) ctx.lastUsedSprite = state->cmd_params[0];

                        // Set collision detection rectangle
                        ctx.sprite[state->cmd_params[0]].colDetRect.min.x = ctx.sprite[state->cmd_params[0]].x;
                        ctx.sprite[state->cmd_params[0]].colDetRect.min.y = ctx.sprite[state->cmd_params[0]].y;
                        ctx.sprite[state->cmd_params[0]].colDetRect.max.x = ctx.sprite[state->cmd_params[0]].x + *pW-1;
                        ctx.sprite[state->cmd_params[0]].colDetRect.max.y = ctx.sprite[state->cmd_params[0]].y + *pH-1;

                        gfx_check_collision(state->cmd_params[0]);
                    }
                }
                retval = 0;
            goto back_to_normal;
            break;

            case '"':
                /* scroll up */
                if (state->cmd_params_size == 1)
                {
                    gfx_scroll_up(state->cmd_params[0]);
                }
                retval = 0;
            goto back_to_normal;
            break;

            case '_':
                /* scroll down */
                if (state->cmd_params_size == 1)
                {
                    gfx_scroll_down(state->cmd_params[0]);
                }
                retval = 0;
            goto back_to_normal;
            break;

            case '>':
                /* scroll right */
                if (state->cmd_params_size == 1)
                {
                    gfx_scroll_right(state->cmd_params[0]);
                }
                retval = 0;
            goto back_to_normal;
            break;

            case '<':
                /* scroll left */
                if (state->cmd_params_size == 1)
                {
                    gfx_scroll_left(state->cmd_params[0]);
                }
                retval = 0;
            goto back_to_normal;
            break;

            /** The following is only for debug purposes
            case 't':
            	// video test from pigfx.c
            	video_test(1000);
            	goto back_to_normal;
            	break;
            case 'T':
            	// video test from pigfx.c
            	video_line_test(1000 );
            	goto back_to_normal;
            	break;
            	*/
        }
    }

    if ( state->private_mode_char == '=' )
    {
    	// ANSI.SYS style mode changing
    	switch( ch )
    	{
    	case 'h': // set resolution mode on last parameter, ignore previous
    		if( state->cmd_params_size >= 1)
    		{
    			// parameter is the mode index in global array
    			if (state->cmd_params[state->cmd_params_size - 1] <= LAST_MODE_NUMBER)
    			{
        			struct DISPLAY_MODE_DEFINITION* p = & ALL_MODES[state->cmd_params[state->cmd_params_size-1]];
        			if (p->width > 0)
        			{
        				initialize_framebuffer( p->width, p->height, p->bpp);
        			}
    			}
    		}
    		goto back_to_normal;
    		break;

    	case 'f': // ESC=0f choose 8x8 font, ESC=1f for 8x16, ESC=2f for 8x24
    		if( state->cmd_params_size >= 1)
    		{
    			// parameter is the font number
    			switch (state->cmd_params[state->cmd_params_size - 1])
    			{
    			case 0:
    				gfx_term_set_font(8,8);
    				break;
				case 1:
					gfx_term_set_font(8,16);
					break;
				case 2:
					gfx_term_set_font(8,24);
					break;
				default:
					// ignore
					break;
    			}
    		}
    		goto back_to_normal;
    		break;

    	case 'm': // ESC=0m normal mode, ESC=1m XOR, ESC=2m TRANSPARENT
       		if( state->cmd_params_size >= 1)
        	{
				// parameter is the font number
				switch (state->cmd_params[state->cmd_params_size - 1])
				{
				case 1:
					gfx_set_drawing_mode(drawingXOR);
					break;
				case 2:
					gfx_set_drawing_mode(drawingTRANSPARENT);;
					break;
				default:
					gfx_set_drawing_mode(drawingNORMAL);
					break;
        		}
    		}
    		goto back_to_normal;
    		break;

    	case 't': // ESC=xxxt sets tabulation width
        	if( state->cmd_params_size >= 1)
        	{
        		gfx_term_set_tabulation(state->cmd_params[state->cmd_params_size - 1]);
        	}
        	goto back_to_normal;
        	break;


        case 'p':
            // ESC=xp Set palette
            if( state->cmd_params_size == 1 )
            {
                fb_set_palette(state->cmd_params[0]);
            }
            else if ( state->cmd_params_size == 2 )
            {
                // 0=base, 1=nbrOfColors
                if (((state->cmd_params[0] == 10) || (state->cmd_params[0] == 16))
                    && (state->cmd_params[1] > 0)
                    && (state->cmd_params[1] <= 256))
                {
                    ctx.paletteloader.loading = 1;
                    ctx.paletteloader.asciiBase = state->cmd_params[0];
                    ctx.paletteloader.colorIdx = 0;
                    ctx.paletteloader.color = 0;
                    ctx.paletteloader.nbColors = state->cmd_params[1];
                }
            }
            goto back_to_normal;
            break;

    	} // switch last letter after '=' and parameters
    } // private mode = '='

    // General 'ESC[' ANSI/VT100 commands
    switch( ch )
    {
        case 'l':
            if( state->private_mode_char == '?' &&
                state->cmd_params_size == 1 &&
                state->cmd_params[0] == 25 )
            {
                gfx_term_set_cursor_blinking(0);
                if (ctx.term.cursor_visible)
                {
                    gfx_term_set_cursor_visibility(0);
                    gfx_restore_cursor_content();
                }
            }
            goto back_to_normal;
            break;

        case 'b':
            if( state->private_mode_char == '?' &&
                state->cmd_params_size == 1 &&
                state->cmd_params[0] == 25 )
            {
                gfx_term_set_cursor_blinking(1);
            }
            goto back_to_normal;
            break;

        case 'h':
            if( state->private_mode_char == '?' &&
                state->cmd_params_size == 1 &&
                state->cmd_params[0] == 25 )
            {
                gfx_term_set_cursor_blinking(0);
                if (ctx.term.cursor_visible == 0)
                {
                    gfx_term_set_cursor_visibility(1);
                    gfx_term_render_cursor();
                }
            }
            goto back_to_normal;
            break;

        case 'K':
            if( state->cmd_params_size== 0 )
            {
                gfx_term_clear_till_end();
            }
            else if( state->cmd_params_size== 1 )
            {
                switch(state->cmd_params[0] )
                {
                    case 0:
                        gfx_term_clear_till_end();
                        goto back_to_normal;
                    case 1:
                        gfx_term_clear_till_cursor();
                        goto back_to_normal;
                    case 2:
                        gfx_term_clear_line();
                        goto back_to_normal;
                    default:
                        goto back_to_normal;
                }
            }
            goto back_to_normal;
            break;

        case 'J':
            if( state->cmd_params_size== 0 )
            {
                gfx_term_clear_screen_from_here();
            }
            else if( state->cmd_params_size== 1 )
            {
                switch(state->cmd_params[0] )
                {
                    case 0:
                        gfx_term_clear_screen_from_here();
                        goto back_to_normal;
                    case 1:
                        gfx_term_clear_screen_to_here();
                        goto back_to_normal;
                    case 2:
                        gfx_term_move_cursor(0,0);
                        gfx_term_clear_screen();
                        goto back_to_normal;
                    default:
                        goto back_to_normal;
                }
            }
            goto back_to_normal;
            break;

        case 'A':
            //if( state->cmd_params_size == 1 )
                gfx_term_move_cursor_d( -state->cmd_params[0], 0 );

            goto back_to_normal;
            break;

        case 'B':
            //if( state->cmd_params_size == 1 )
                gfx_term_move_cursor_d( state->cmd_params[0], 0 );

            goto back_to_normal;
            break;

        case 'C':
            //if( state->cmd_params_size == 1 )
                gfx_term_move_cursor_d( 0, state->cmd_params[0] );

            goto back_to_normal;
            break;

        case 'D':
            //if( state->cmd_params_size == 1 )
                gfx_term_move_cursor_d( 0, -state->cmd_params[0] );

            goto back_to_normal;
            break;

        case 'm':
            if( state->cmd_params_size == 3 &&
                state->cmd_params[0]==38 )
            {
                if (state->cmd_params[1]==5)
                {
                    // esc[38;5;colm
                    gfx_set_fg( state->cmd_params[2] );

                }
                else if (state->cmd_params[1]==6)
                {
                    // esc[38;6;colm
                    gfx_set_fg( state->cmd_params[2] );
                    gfx_set_default_fg(state->cmd_params[2]);
                }
                goto back_to_normal;
            }
            else if( state->cmd_params_size == 3 &&
                state->cmd_params[0]==48 )
            {
                if (state->cmd_params[1]==5)
                {
                    // esc[48;5;colm
                    gfx_set_bg( state->cmd_params[2] );
                }
                else if (state->cmd_params[1]==6)
                {
                    // esc[48;6;colm
                    gfx_set_bg( state->cmd_params[2] );
                    gfx_set_default_bg(state->cmd_params[2]);
                }
                goto back_to_normal;
            }
            else if( state->cmd_params_size == 3 &&
                state->cmd_params[0]==58    &&
                state->cmd_params[1]==5 )
            {
                // esc[58;5;colm
                gfx_set_transparent_color( state->cmd_params[2] );
                goto back_to_normal;
            }
            else if (state->cmd_params_size == 0)
            {
                // esc[m
                gfx_set_bg(ctx.default_bg);
                gfx_set_fg(ctx.default_fg);
		        ctx.reverse = 0; // sets reverse to 'normal' for the current defaults.
                goto back_to_normal;
            }
            else
            {
                // esc[par1;par2;par3m  (actually one to 3 params)
                if (state->cmd_params_size > 3) state->cmd_params_size = 3;     // limit to 3
                for (unsigned int i=0; i<state->cmd_params_size; i++)
                {
                    switch (state->cmd_params[i])
                    {
                        case 0:
                            // reset
                            gfx_set_bg(ctx.default_bg);
                            gfx_set_fg(ctx.default_fg);
		                    ctx.reverse = 0; // sets reverse to 'normal' for the current defaults.
                            break;
			            case 1:
	                        // increase intensity - as 22m for 4byte TODO: 256 Color pal
		                    if (ctx.fg <= 7) gfx_set_fg(ctx.fg+8);
		                    break;
			            case 2:
		                   // decrease intensity -transpose dim fg colors from bright TODO 255 color pal
		                   if (ctx.fg >= 8) gfx_set_fg(ctx.fg-8);
		                   break;
                        case 7:
                            // toggle text mode to 'reverse'
                            if (ctx.reverse == 0)
                            {
                                gfx_swap_fg_bg();
				                ctx.reverse = 1;
                            }
                            break;
			            case 22:
		                    // transpose bright fg colors from dim, this is interesting it is meant to be 'normal'
		                    // but is often implemented as 'bright', this is needed for gorilla.bas compatiblity.
		                    // function is fliped since the normal terminal color is often 'dim'; in this case it is.
		                    // TODO: 256 color (how would this have effect?)
		                    if (ctx.fg <= 7) gfx_set_fg(ctx.fg+8);
		                    break;
			            case 27:
		                    // toggle text mode to 'normal'
		                    if (ctx.reverse == 1)
                            {
                                gfx_swap_fg_bg();
				                ctx.reverse = 0;
                            }
		                break;
                        case 30 ... 37:
                            // fg color
                            gfx_set_fg(state->cmd_params[i]-30);
                            break;
                        case 40 ... 47:
                            // bg color
                            gfx_set_bg(state->cmd_params[i]-40);
                            break;
                        case 90 ... 97:
                            // bright foreground color 8 to 15
                            gfx_set_fg(state->cmd_params[i]-82);
                            break;
                        case 100 ... 107:
                            // bright background color 8 to 15
                            gfx_set_bg(state->cmd_params[i]-92);
                            break;
                    }
                }
                goto back_to_normal;
            }
            goto back_to_normal;
            break;

        case 'f':
        case 'H':
            if( state->cmd_params_size == 2 )
            {
                int row = (state->cmd_params[0] - 1) % ctx.term.HEIGHT;
                int col = (state->cmd_params[1] - 1) % ctx.term.WIDTH; // 80 -> (79 % 80) -> 79, 81 -> (80 % 80) -> 0
                gfx_term_move_cursor(row, col);
            }
            else
                gfx_term_move_cursor(0,0);
            goto back_to_normal;
            break;

        case 's':
            gfx_term_save_cursor();
            goto back_to_normal;
            break;

        case 'u':
            gfx_term_restore_cursor();
            goto back_to_normal;
            break;

        case '@':
            // Insert a blank character position (shift line to the right)
            if( state->cmd_params_size == 1 )
            {
                gfx_term_insert_blank();
            }
            goto back_to_normal;
            break;

        case 'P':
            // Delete a character position (shift line to the left)
            if( state->cmd_params_size == 1 )
            {
                gfx_term_delete_char();
            }
            goto back_to_normal;
            break;

        case 'L':
            // Insert blank line at current row (shift screen down)
            if( state->cmd_params_size == 1 )
            {
                gfx_term_insert_line();
            }
            goto back_to_normal;
            break;

        case 'M':
            // Delete the current line (shift screen up)
            if( state->cmd_params_size == 1 )
            {
                gfx_term_delete_line();
            }
            goto back_to_normal;
            break;

        default:
            goto back_to_normal;
    }

back_to_normal:
    // go back to normal text
    state->cmd_params_size = 0;
    state->next = state_fun_normaltext;
    return retval;
}

/** Read next digit of a parameter or a separator. */
int state_fun_read_digit( char ch, scn_state *state )
{
    if( ch>='0' && ch <= '9' )
    {
    	// make sure we have a parameter
    	if (state->cmd_params_size == 0)
    	{
    		state->cmd_params_size = 1;
    		state->cmd_params[0] = 0;
    	}
        // parse digit
        state->cmd_params[ state->cmd_params_size - 1] = state->cmd_params[ state->cmd_params_size - 1]*10 + (ch-'0');
        state->next = state_fun_read_digit; // stay on this state
        return 1;
    }
    if (ch == '.')
    {
        state->next = state_fun_ignore_digit;
         return 1;
    }
    if( ch == ';' )
    {
        // Another param will follow
        state->cmd_params_size++;
        state->cmd_params[ state->cmd_params_size-1 ] = 0;
        state->next = state_fun_read_digit; // stay on this state
        return 1;
    }

    // not a digit, call the final state
    state_fun_final_letter( ch, state );
    return 1;
}

/** Ignore next digits of a parameter until separator. */
int state_fun_ignore_digit( char ch, scn_state *state )
{
	if( ch>='0' && ch <= '9' )
	{
		return 1;
	}
	if( ch == ';' )
    {
        // Another param will follow
        state->cmd_params_size++;
        state->cmd_params[ state->cmd_params_size-1 ] = 0;
        state->next = state_fun_read_digit; // stay on this state
        return 1;
    }
    // not a digit, end
    state_fun_final_letter( ch, state );
    return 1;
}

/** Right after ESC, start a parameter when reading a digit or select the private mode character. */
int state_fun_selectescape( char ch, scn_state *state )
{
    if( ch>='0' && ch<='9' )
    {
        // start of a digit
        state->cmd_params_size = 1;
        state->cmd_params[ 0 ] = ch-'0';
        state->next = state_fun_read_digit;
        return 1;
    }
    else
    {
        if( ch=='?' || ch=='#' || ch=='=' )
        {
            state->private_mode_char = ch;
            // A digit may follow
            state->cmd_params_size = 0;
            state->next = state_fun_read_digit;
            return 1;
        }
    }

    // Already at the final letter
    state_fun_final_letter( ch, state );
    return 1;
}

/** Right after ESC, wait for a [.
 *  The special case ESC ESC is displaying ESC character and end the sequence.
 */
int state_fun_waitsquarebracket( char ch, scn_state *state )
{
    if( ch=='[' )
    {
        state->cmd_params[0]=1;
        state->private_mode_char=0; // reset private mode char
        state->next = state_fun_selectescape;
        return 1;
    }

    if( ch==TERM_ESCAPE_CHAR ) // Double ESCAPE prints the ESC character
    {
        gfx_putc( ctx.term.cursor_row, ctx.term.cursor_col, ch );
        ++ctx.term.cursor_col;
        gfx_term_render_cursor();
    }

    state->next = state_fun_normaltext;
    return 1;
}

/** Starting state when receiving a character to display.
 *  If the character is ESC, a sequence parsing state is entered.
 *  If none of the previous happened, the character is displayed using current font.
 */
int state_fun_normaltext( char ch, scn_state *state )
{
    if( ch==TERM_ESCAPE_CHAR )
    {
        state->next = state_fun_waitsquarebracket;
        return 1;
    }

    gfx_putc( ctx.term.cursor_row, ctx.term.cursor_col, ch );
    ++ctx.term.cursor_col;
    gfx_term_render_cursor();
    return 1;
}

/** This can be used to flip the framebuffer
    Tests have showed that this is quite slow actually
    For the moment I'm going to disable this
**/
void gfx_switch_framebuffer()
{
    // Change FB write pointer
    unsigned char* showingFb = ctx.pfb;     // this fb is now not showing, but gets changed now to be showing
    if (ctx.pfb == ctx.pFirstFb)
	{
		ctx.pfb = ctx.pSecondFb;
	}
    else
	{
		ctx.pfb = ctx.pFirstFb;
	}

    // Change y offset of framebuffer to other buffer
    if (ctx.fb_yOffset == 0) ctx.fb_yOffset = ctx.H;
    else ctx.fb_yOffset = 0;
    fb_switch_framebuffer(ctx.fb_yOffset);

    // Copy all data of the now showing framebuffer part to the not showing framebuffer part
//    dma_memcpy_32(showingFb, ctx.pfb, ctx.size);
}

void gfx_draw_pixel(int x0, int y0, unsigned int colour)
{
    if ((y0 < 0) || (y0 >= (int)ctx.H)) return;
    if (x0 >= (int)ctx.W) return;

    register unsigned char* pfb = PFB(x0,y0);
    *pfb = (unsigned char) colour;
}

unsigned char* gfx_get_pixel_addr(int x0, int y0)
{
    if ((y0 < 0) || (y0 >= (int)ctx.H)) return 0;
    if (x0 >= (int)ctx.W) return 0;

    unsigned char* pfb = PFB(x0,y0);
    return pfb;
}
