martinpiper/BombJack/PiJack2/src/DisplayBombJackC.h

#ifndef __DISPLAYBOMBJACKC_H
#define __DISPLAYBOMBJACKC_H

extern void DisplayBombJack_init();

extern void DisplayBombJack_calculatePixel();

extern void DisplayBombJack_startCalculateAFrame();

extern void DisplayBombJack_writeMemoryBus(unsigned int value);

#endif //< ifndef __DISPLAYBOMBJACKC_H
