martinpiper/BombJack/(commit log)

2018-10-25 Working on page 3
    [Bomb Jack.pdsprj]
2018-10-27 Adding bus label
    [Bomb Jack.pdsprj]
2018-10-27 More video and misc timing logic
    [Bomb Jack.pdsprj]
2018-10-27 page 3 done
    [Bomb Jack.pdsprj]
2018-10-28 starting on page 4
    [Bomb Jack.pdsprj]
2018-10-30 page 4 9800 RAM read/write logic
    [Bomb Jack.pdsprj]
2018-10-30 Memory write setup
    [Bomb Jack.pdsprj]
2018-10-30 Adding comparators
    [Bomb Jack.pdsprj]
2018-10-31 Adding PCB layout
    [Bomb Jack.pdsprj]
2018-10-31 page 4 done
    [Bomb Jack.pdsprj]
2018-10-31 Adding page 5 logic
    [Bomb Jack.pdsprj]
2018-10-31 page 5 one whole raster line logic
    [Bomb Jack.pdsprj]
2018-11-01 Write sprite data to 0x9820-
    Some information is being written to the raster RAM
    [Bomb Jack.pdsprj]
2018-11-01 Debugging sprite plane
    [Bomb Jack.pdsprj]
2018-11-01 Adding extra sprite data
    [Bomb Jack.pdsprj]
2018-11-01 TODO wrt timings
    [Bomb Jack.pdsprj]
2018-11-02 Adding other scan RAM
    [Bomb Jack.pdsprj]
2018-11-02 Bug fix component refs
    [Bomb Jack.pdsprj]
2018-11-02 Connected the second scan RAM to the output pre-putput stage
    [Bomb Jack.pdsprj]
2018-11-02 removing duplicate component ref
    [Bomb Jack.pdsprj]
2018-11-02 small tweaks
    [Bomb Jack.pdsprj]
2018-11-04 Video signal
    [Bomb Jack.pdsprj]
2018-11-04 Board edge connector placement
    [Bomb Jack.pdsprj]
2018-11-05 Renamed all components so they do not start with a number
    [Bomb Jack.pdsprj]
2018-11-05 Successful auto placement and route
    [Bomb Jack.pdsprj]
2018-11-06 Updating with oriiginal component references again
    [Bomb Jack.pdsprj]
2018-11-06 Another successful auto route
    [Bomb Jack.pdsprj]
2018-11-10 Sheet 8 - Palette read/write logic
    [Bomb Jack.pdsprj]
2018-11-10 Final colour mix tweaks
    [Bomb Jack.pdsprj]
2018-11-10 Waiting for layout, slightly bigger board
    [Bomb Jack.pdsprj]
2018-11-11 layout and routed
    [Bomb Jack.pdsprj]
2018-11-11 resistors placed
    [Bomb Jack.pdsprj]
2018-11-11 Different video resistor placement
    [Bomb Jack.pdsprj]
2018-11-11 video and sprite colour logic ICs
    [Bomb Jack.pdsprj]
2018-11-11 Populated layout
    [Bomb Jack.pdsprj]
2018-11-12 better resistor ladder placement
    [Bomb Jack.pdsprj]
2018-11-12 7A2 8B2 placement
    [Bomb Jack.pdsprj]
2018-11-12 Board size set
    [Bomb Jack.pdsprj]
2018-11-12 simulation tested
    [Bomb Jack.pdsprj]
2018-11-16 Sprite display output first pass test seems to be working
    Using VSMDigitalDisplay to output debug information for post processing
    [Bomb Jack.pdsprj]
2018-11-17 Adding display to schematic
    [Bomb Jack.pdsprj]
2018-11-18 IC 7S connection problem
    _CONTRLDB was connected to pin 12 not pin 11.
    This was not connected properly
    so _CONTRLDB was not being triggered at the correct time
    which affected the 6C/6D loads
    [Bomb Jack.pdsprj]
2018-11-18 correct bombjack palette entries 0-3
    [Bomb Jack.pdsprj]
2018-11-18 Remove DLL
    [Bomb Jack.pdsprj]
2018-11-18 setting 264 display lines
    [Bomb Jack.pdsprj]
2018-11-19 Quicker RAM data load during VBLANK using 2H instead of HBL
    [Bomb Jack.pdsprj]
2018-11-19 Tidied some wires into page 4 7D
    [Bomb Jack.pdsprj]
2018-11-20 VSYNC signal could be exposed to EXPANSIONBUS2:EXTWANTIRQ
    [Bomb Jack.pdsprj]
2018-11-20 Adding extra debug bus SREAD to track timing of sprite reads
    [Bomb Jack.pdsprj]
2018-11-21 Adding raster line schedule information to README
    [Bomb Jack.pdsprj]
2018-11-22 Adding character screen logic from page 6
    [Bomb Jack.pdsprj]
2018-11-23 page 6 screen RAM logic done
    [Bomb Jack.pdsprj]
2018-11-23 Added final pixel combination logic and debug purple push button
    [Bomb Jack.pdsprj]
2018-11-25 Page 7 background picture logic done
    [Bomb Jack.pdsprj]
2018-11-25 Updated palette, finsihed page 7 logic
    [Bomb Jack.pdsprj]
2018-11-25 Fixed the swapped RGB bitwise components to matc hthe original schematic
    [Bomb Jack.pdsprj]
2018-11-26 Used 90 degree rotation option
    [Bomb Jack.pdsprj]
2018-11-26 Board size includes all logic
    [Bomb Jack.pdsprj]
2018-11-27 Added a flip button control
    [Bomb Jack.pdsprj]
2018-11-27 Updated edge conectors in schematic from library
    Menu->Library->Manage Changes
    [Bomb Jack.pdsprj]
2018-11-28 Moved the clock to sheet 1
    [Bomb Jack.pdsprj]
2018-11-28 PCB Layout doco
2018-12-08 Updated PCB layout
    Added buttons and pulldowns
    [Bomb Jack.pdsprj]
2018-12-10 Updating the layout to include buttons for flip and background colour select
    [Bomb Jack.pdsprj]
2018-12-13 Upsdating the BOM unit prices
    [Bomb Jack.pdsprj]
2018-12-14 Adding more BOM costs
    [Bomb Jack.pdsprj]
2019-10-16 Proteus version bump
    [Bomb Jack.pdsprj]
2019-10-17 Updating docs
    [Bomb Jack.pdsprj]
2019-10-17 6MHz clock needs a full can oscillator part in the schematic (disabled for simulation) and layout
    [Bomb Jack.pdsprj]
2019-10-19 Adding .6MHz line
    Regarding 6MHz from 4T
    [Bomb Jack.pdsprj]
2019-10-19 Change screen colours to exercise the 6N2:B flow
    Update documentation and debug patterns
    [Bomb Jack.pdsprj]
2019-10-19 Added crystal or oscillator layout
    With jumper J1 select
    [Bomb Jack.pdsprj]
2019-10-20 Layout with updated clocking
    [Bill Of Materials Bomb Jack.csv, Bomb Jack.pdsprj]
2019-10-20 Adding links to the "stock code"
    [Bill Of Materials Bomb Jack.csv, Bomb Jack.pdsprj]
2019-10-21 BOM Updates
    [Bill Of Materials Bomb Jack.csv, Bomb Jack.pdsprj]
2019-10-23 Placement keepout seems to work nicely
    [Bomb Jack.pdsprj]
2019-10-24 Component sourcing
    [Bill Of Materials Bomb Jack.csv, Bomb Jack.pdsprj]
2019-10-29 Adding user port to 24 bit address interface
    [UserPortTo24BitAddress.pdsprj]
2019-10-30 Added address protocol decoder logic
    [Bomb Jack.pdsprj, UserPortTo24BitAddress.pdsprj]
2019-10-31 Added a quick debug selector and RAM, to visually display the memory can be selected and written
    [UserPortTo24BitAddress.pdsprj]
2019-11-02 Added layers for auto place and route
    [UserPortTo24BitAddress.pdsprj]
2019-11-02 Improved layers routing and layout
    [UserPortTo24BitAddress.pdsprj]
2019-11-02 74139 used instead
    [Bill Of Materials UserPortTo24BitAddress.csv, UserPortTo24BitAddress.pdsprj]
2019-11-03 Added display enable/disable logic
    This allows large amounts of data to be written to RAM while the display is disabled without fear of contention with the display HW
    [Bomb Jack.pdsprj]
2019-11-03 Added logic analyser for the userport timings
    [UserPortTo24BitAddress.pdsprj]
2019-11-04 Address write timing resolved
    [UserPortTo24BitAddress.pdsprj]
2019-11-04 Userport and _MEWR timing fixed
    [UserPortTo24BitAddress.pdsprj]
2019-11-06 Added RAM for background screen/colours
    [Bomb Jack.pdsprj, UserPortTo24BitAddress.pdsprj]
2019-11-06 No real changes
    [Bomb Jack.pdsprj]
2019-11-07 Added V2.0 silk screen text
    [Bomb Jack.pdsprj]
2019-11-11 Replacement for the Proteus data generators because they have a 1024 byte limit
    [Bomb Jack.pdsprj, UserPortTo24BitAddress.pdsprj]
2019-11-11 Adding extra docs for the background layer
    [Bomb Jack.pdsprj]
2019-11-13 Root sheet 7 8R7 using 08_r08t.bin to RAM EBS7 EA14 RAM select $4000
    [Bomb Jack.pdsprj]
2019-11-13 Adding three RAMs for the tile bitplanes
    [Bomb Jack.pdsprj]
2019-11-13 Adding extra debug data
    [Bomb Jack.pdsprj]
2019-11-13 Expanding the board and adding another placement keepout
    [Bomb Jack.pdsprj]
2019-11-13 Updating some keepout areas and expanding the board
    [Bomb Jack.pdsprj]
2019-11-14 Character data RAMs
    [Bomb Jack.pdsprj]
2019-11-14 Layout to six kayers, no middle keepouts. Routes OK.
    [Bomb Jack.pdsprj]
2019-11-15 Sprite data into RAM
    [Bomb Jack.pdsprj]
2019-11-16 Group EBS usage for the tile/char/sprite data to EBS6/EBS5/EBS4
    [Bomb Jack.pdsprj]
2019-11-16 Remove the vertical flip button and associated logic
    [Bomb Jack.pdsprj]
2019-11-16 Added $9e01 (l/h nybbles for x/y)
    [Bomb Jack.pdsprj]
2019-11-16 Initial tests of the X nybble write seem to indicate success!
    [Bomb Jack.pdsprj]
2019-11-16 Auto layout and route success
    [Bomb Jack.pdsprj]
2019-11-17 X and Y pixel scroll logic added
    [Bomb Jack.pdsprj]
2019-11-17 Digital data gen has no layout
    [Bomb Jack.pdsprj]
2019-11-17 PCB size adequate
    [Bomb Jack.pdsprj]
2019-11-17 Border shrink logic
    [Bomb Jack.pdsprj]
2019-11-18 Right border shrink debug
    [Bomb Jack.pdsprj]
2019-11-18 X & Y Border shrink works
    [Bomb Jack.pdsprj]
2019-11-20 Adding tons of debug
    [Bomb Jack.pdsprj, Test2114.pdsprj]
2019-11-21 Fixing the high frequency variance in sprite scan address lines
    [Bomb Jack.pdsprj, Test2114.pdsprj]
2019-11-21 Adding one cache line (IDA0) to the Test2114 project
    [Test2114.pdsprj]
2019-11-22 TODO updates
    [Bomb Jack.pdsprj]
2019-11-22 Potential model for RAM access logic
    [ROM2RAM.pdsprj]
2019-11-24 Proof of the EBS bus model with sprite movement and scrolling register updates in VBLANK
    [Bomb Jack.pdsprj]
2019-11-25 Demo animation for sprite and scrolling
    [Bomb Jack.pdsprj]
2019-11-26 Restored default layout options
    [Bomb Jack.pdsprj, UserPortTo24BitAddress.pdsprj]
2019-11-27 Auto place OK
    [Bomb Jack.pdsprj]
2019-11-27 Auto place and route successful
    [Bomb Jack.pdsprj]
2019-11-28 Replaced four 2114 with two 6116
    [Bomb Jack.pdsprj]
2019-11-29 512x256 resolution test with 48 sprites
    [Bomb Jack 512x256 test 48 sprites.pdsprj]
2019-11-30 Tile screen works at 512x256
    [Bomb Jack 512x256 test 48 sprites.pdsprj]
2019-11-30 hires test done
    [Bomb Jack 512x256 test 48 sprites.pdsprj, Bomb Jack.pdsprj]
2019-11-30 Sorted out the hires sprite registers issue
    [Bomb Jack 512x256 test 48 sprites.pdsprj]
2019-12-01 Debugging hires sprites
    [Bomb Jack 512x256 test 48 sprites.pdsprj]
2019-12-02 Test data back to standard resolution config
    [Bomb Jack 512x256 test 48 sprites.pdsprj, Bomb Jack.pdsprj]
2019-12-02 Update the standard resolution schematic to use 2114FAST, 6116FAST and 6264FAST
    [Bomb Jack.pdsprj]
2019-12-03 Standard resolution: 3E/3F could use one 6116 instead
    [Bomb Jack.pdsprj]
2019-12-03 Adding full height sprites option
    [Bomb Jack.pdsprj]
2019-12-04 Updated the DigitalData model from the library
    [Bomb Jack 512x256 test 48 sprites.pdsprj, Bomb Jack.pdsprj]
2019-12-05 Background colour and tile X/Y offset
    [Bomb Jack.pdsprj]
2019-12-06 Added a full test of writes to sprite and background palette registers during the frame
    [Bomb Jack.pdsprj]
2019-12-07 Added extra ROWCOL header
    [Bomb Jack.pdsprj]
2019-12-07 Adding data generation to test sprite patterns and copper writes
    [Bomb Jack.pdsprj]
2019-12-08 Adding a screen scroll split
    [Bomb Jack.pdsprj]
2019-12-10 Investigating multiplexed sprites and hardware limits
    [Bomb Jack.pdsprj]
2019-12-13 $9a00 Upper nybble: $10 = Enable sprite output (6S SPREN)
    [Bomb Jack.pdsprj]
2019-12-18 Fixed a bug in DigitalData where waiting for an input value caused the first value to be skipped
    Double writes removed from the data generator, the display still renders correctly
    [Bomb Jack.pdsprj]
2019-12-21 Colour bar sparkles debugging
    Looks like clock input timing variances
    [Bomb Jack.pdsprj]
2019-12-27 Adding parts ordering links
    [Bomb Jack.pdsprj]
2019-12-27 7483 no longer made? Change to 74283 with different pinout.
    More product code links added
    [Bomb Jack.pdsprj]
2019-12-28 smaller board, place OK
    [Bill Of Materials Bomb Jack.csv, Bomb Jack.pdsprj]
2019-12-29 V2.0 files
    [Bill Of Materials Bomb Jack.csv, Bomb Jack.pdsprj]
2020-01-13 Applied All PCB Six Layer 1.58532mm.LTF to V2.0 stackup and exported
    [Bomb Jack.pdsprj]
2020-01-17 Using new graphics data
    [Bomb Jack.pdsprj]
2020-01-30 Using new TestData2.txt that uses unified conversion data
    [Bomb Jack.pdsprj]
2020-02-09 12 sprites, each 16+ colours
    [Bomb Jack.pdsprj]
2020-02-13 Removing unused signals
    Tidying the schematic in preparation for multiple boards
    [Bomb Jack.pdsprj]
2020-02-14 _EXTCS9800 logic
    _EXTCS9800 logic that decodes the _9800CS, _9A00CS, _9C00CS, _9E00CS duplicated on each board that uses these
    Merge _CSEN and _MREQ and remove
    [Bomb Jack.pdsprj]
2020-02-14 Board separation preparation work
    [Bomb Jack.pdsprj]
2020-02-14 Sprite size logic now moved to root sheet 40
    [Bomb Jack.pdsprj]
2020-02-15 Tagging packages based on board and shuffling around references
    [Bill Of Materials Bomb Jack.csv, Bomb Jack.pdsprj]
2020-02-15 Lots of headers created
    [Bill Of Materials Bomb Jack.csv, Bomb Jack.pdsprj]
2020-02-15 Four sets of headers and smaller boards
    [Bomb Jack.pdsprj]
2020-02-15 Sizing the boards to fit
    [Bomb Jack.pdsprj]
2020-02-15 BoM produced
    [Bill Of Materials Bomb Jack.csv, Bomb Jack.pdsprj]
2020-02-15 Board sizing
    [Bomb Jack.pdsprj]
2020-02-16 Chars board size tweak
    [Bomb Jack.pdsprj]
2020-02-16 Board Video and Chars sizing
    [Bomb Jack.pdsprj]
2020-02-16 auto place and route succeeded
    [Bomb Jack.pdsprj]
2020-02-16 SS from sheet 3 1T output 11 was wrong
    Part 7N Outputs... Duplicated and split to sheet 50 and 80
    [Bomb Jack.pdsprj]
2020-02-16 SS, _SL1, _SL2 moved to sheet 60
    [Bomb Jack.pdsprj]
2020-02-16 Added extra signals to video headers
    [Bomb Jack.pdsprj]
2020-02-16 Successful board auto place and route
    [Bomb Jack.pdsprj]
2020-02-16 Board size tweak, successful auto place
    [Bomb Jack.pdsprj]
2020-02-17 Added CMPBLK to Video headers
    [Bomb Jack.pdsprj]
2020-02-17 The ROWCOL headers were missing the vertical position
    [Bomb Jack.pdsprj]
2020-02-17 No real change, just saved
    [Bomb Jack.pdsprj]
2020-02-18 V3.0 file output and TODO
    [Bomb Jack.pdsprj]
2020-02-21 Automatic detection of missing routing across board boundaries
    [Bomb Jack.pdsprj]
2020-02-28 Changed back to TestData2
    [Bomb Jack.pdsprj]
2020-02-29 Updated TestData animation with better resolution
    [UserPortTo24BitAddress.pdsprj]
2020-03-01 EXTWANTIRQ connected to FLAG2
    [UserPortTo24BitAddress.pdsprj]
2020-03-01 U67:A now combines the VBLANK, border shrinks and _CMPBLK*. and frees the line on the 5E2
    [Bomb Jack.pdsprj]
2020-03-01 Twice as many colours
    [Bomb Jack.pdsprj]
2020-03-21 Initial Mode7 logic added, seems to be working well
    [Bomb Jack.pdsprj]
2020-03-22 At least I've figured out what register values result in 0/90/180/270 rotations now
    [Bomb Jack.pdsprj]
2020-03-24 Need to test for empty pixel $00 and replace it with the background colour
    [Bomb Jack.pdsprj]
2020-03-25 Added "LDXORGL/H" note "; Trying mode7 xorg writes" seems to work
    [Bomb Jack.pdsprj]
2020-03-26 Adding x/y org writes to generated data
    [Bomb Jack.pdsprj]
2020-03-28 Add pre-transform translation test to the mode7 screen
    [Bomb Jack.pdsprj]
2020-03-29 Addresses spaced out allowing HH value to be used later
    [Bomb Jack.pdsprj]
2020-03-29 Now allows a 128x64 tile screen, uses 8192 bytes
    [Bomb Jack.pdsprj]
2020-03-30 Completed proof of larger virtual screen
    [Bomb Jack.pdsprj]
2020-03-30 Mode7 RAMs added
    [Bomb Jack.pdsprj]
2020-03-31 Mode7 pixel calculate and output was reduced from 4 to 2 stages. Significantly reducing the complexity.
    [Bomb Jack.pdsprj]
2020-03-31 Mode7, root sheet 10: Need to add pixel output header and common pixels/signals/address/data bus inputs headers
    [Bomb Jack.pdsprj]
2020-03-31 All boards components populated with correct groups
    [Bomb Jack.pdsprj]
2020-03-31 Mode7 board sizing for auto place
    [Bomb Jack.pdsprj]
2020-04-01 Make boards top silk text V3.0
    [Bomb Jack.pdsprj]
2020-04-01 Connectivity check shows missing _HSYNC _VSYNC
    Add to video headers
    [Bomb Jack.pdsprj]
2020-04-01 x/y flip inverter trick for the mode7 tile lookup
    [Bomb Jack.pdsprj]
2020-04-02 Mode7 board sizing for extra H/V flip logic
    [Bomb Jack.pdsprj]
2020-04-03 Adding mode7 docs
    [Bomb Jack.pdsprj]
2020-04-03 Adding documentation for mode7
    [Bomb Jack.pdsprj]
2020-04-06 Update 6264FAST _OE _WE logic to improve write stability timing
    [Bomb Jack.pdsprj]
2020-04-06 Simplified memory timing write access, removed read logic.
    [Bomb Jack.pdsprj]
2020-04-06 Updated docs
    [Bomb Jack.pdsprj]
2020-04-07 Board size tweak
    [Bomb Jack.pdsprj]
2020-04-07 Large tile screen works
    But the left border seems to be picking up the wrong colour for the first 8 pixels for certain scrolls...
    [Bomb Jack.pdsprj]
2020-04-07 Added, but the left border needed to be brought in by 4 pixels
    [Bomb Jack.pdsprj]
2020-04-07 Moving the right border out a bit to compensate for the left border
    [Bomb Jack.pdsprj]
2020-04-07 back to large scrolling in the generated data
    [Bomb Jack.pdsprj]
2020-04-08 Updated second demo gif
    [Bomb Jack.pdsprj]
2020-04-08 Board size for extra tiles logic
    [Bomb Jack.pdsprj]
2020-04-09 Updated V3.0 outputs and added ideas to TODO
    [Bill Of Materials Bomb Jack.csv, Bomb Jack.pdsprj]
2020-04-09 64 mode7 tiles test
    [Bomb Jack.pdsprj]
2020-04-10 Mode7 tiles to 64 instead of 32? Would need more RAMs
    [Bomb Jack.pdsprj]
2020-04-10 Board size tweak for mode7
    [Bomb Jack.pdsprj]
2020-04-12 Align the 3 bus headers in the video cards with UserPortTo24BitAddress.pdsprj
    [UserPortTo24BitAddress.pdsprj]
2020-04-22 Use bus write pulse to zero output when not active
    [UserPortTo24BitAddress.pdsprj]
2020-04-22 The user port bus now goes 0 after a byte has finished writing
    [Bomb Jack.pdsprj, UserPortTo24BitAddress.pdsprj]
2020-05-07 Extra (but disabled and not placed) logic has been added to the video layer
    [Bomb Jack.pdsprj]
2020-06-03 Documenting audio board
    [Audio.pdsprj]
2020-06-04 64K addressable
    [Audio.pdsprj]
2020-06-04 Starting to connect the voice registers
    [Audio.pdsprj]
2020-06-05 All voice 0 latches work, loop mask and active mask also work
    [Audio.pdsprj]
2020-06-05 Adding voiceInternalChooseLoop
    [Audio.pdsprj]
2020-06-05 Comparison output works
    [Audio.pdsprj]
2020-06-05 Setting ICs to audio layer
    [Audio.pdsprj]
2020-06-06 Internal counter is correct
    [Audio.pdsprj]
2020-06-06 Need voicesActiveMask reset logic based on not looping
    [Audio.pdsprj]
2020-06-06 common address calculation works
    [Audio.pdsprj]
2020-06-06 Debugging RAM reads and writes
    [Audio.pdsprj]
2020-06-07 Sample read corrected with bus isolation
    [Audio.pdsprj]
2020-06-07 fixed SAMP8 write issues and SAMPD read issues
    [Audio.pdsprj]
2020-06-07 Audio group set
    [Audio.pdsprj]
2020-06-07 Board size increase
    [Audio.pdsprj]
2020-06-08 Starting to simplify the voice schematic with less interconnects
    [Audio.pdsprj]
2020-06-08 Removed _V0RESETCOUNTER
    [Audio.pdsprj]
2020-06-08 Reducing V0INTCOUNTER16-23
    [Audio.pdsprj]
2020-06-08 Removed VOICEDOLOOP0
    [Audio.pdsprj]
2020-06-08 Removed V0COMPILT
    [Audio.pdsprj]
2020-06-08 Removed V0COMPISGE
    [Audio.pdsprj]
2020-06-08 Removed _V0RESETACTIVE
    [Audio.pdsprj]
2020-06-08 Removed the last of V0INTCOUNTER
    [Audio.pdsprj]
2020-06-08 Tidying the expected inputs
    [Audio.pdsprj]
2020-06-09 Removed V0INTCOMPARELOOP and _V0INTCOMPARELOOP
    [Audio.pdsprj]
2020-06-09 Removed _VO_ADDRCNTOUT_ADDR
    [Audio.pdsprj]
2020-06-09 Removed _VO_ADDRCNTOUT_LOOPADDR
    [Audio.pdsprj]
2020-06-09 Removed V0RATE
    [Audio.pdsprj]
2020-06-09 Removed _VO_ADDRCNTOUT except common output
    [Audio.pdsprj]
2020-06-09 Tidying traces
    [Audio.pdsprj]
2020-06-09 Unique voice input and outputs are now grouped on the far left of the schematic
    No internal unique terminals
    [Audio.pdsprj]
2020-06-09 Planning for volume work
    [Audio.pdsprj]
2020-06-10 Added junction dots
    [Audio.pdsprj]
2020-06-10 COMMONVOLUME0..7 created
    [Audio.pdsprj]
2020-06-10 Added volume calculation
    [Audio.pdsprj]
2020-06-10 Added extra step V0ST_OUTPUTADDR2 to allow V0ST_READRAM to be used for +ve edge trigger
    Volume calculation takes into account u8 format of samples
    [Audio.pdsprj]
2020-06-10 Adding left and right channel final mixing
    [Audio.pdsprj]
2020-06-10 Adding input line inverters into the voice schematic instead
    [Audio.pdsprj]
2020-06-10 Adding second channel layout
    [Audio.pdsprj]
2020-06-10 aligned voice input/output junction dots
    [Audio.pdsprj]
2020-06-10 Adding other voices and testing with real data
    [Audio.pdsprj]
2020-06-11 Audio place and route is working
    [Audio.pdsprj]
2020-06-11 Debugging hardware output
    [Audio.pdsprj]
2020-06-12 Debugging COMMONPOSITION comparator issue
    [Audio.pdsprj]
2020-06-12 Other voices connected
    [Audio.pdsprj]
2020-06-14 Master latch for mode7 regs
    Gives more control for mode7 layer to have distinct screen areas.
    [Bomb Jack.pdsprj]
2020-06-14 board size verified
    [Bomb Jack.pdsprj]
2020-06-14 For audio playback of the audio simulation output
    [Audio.pdsprj]
2020-07-03 Audio - Consider sub-circuit mode for all other voices
    [Audio.pdsprj]
2020-07-04 Auto place and auto route checked
    [Audio - Placed.pdsprj, Audio - Routed.pdsprj]
2020-07-05 Adding routed boards and TODO
    [Bomb Jack - Chars - Routed.pdsprj, Bomb Jack - Mode7 - Routed.pdsprj, Bomb Jack - Placed.pdsprj, Bomb Jack - Sprites - Routed.pdsprj, Bomb Jack - Tiles - Routed.pdsprj, Bomb Jack - Video - Routed.pdsprj]
2020-07-06 * Note example: TTL to SCART resistor ladder.pdsprj
    [Audio - Placed.pdsprj, Audio - Routed.pdsprj, Bill Of Materials Bomb Jack.csv, Bomb Jack - Chars - Routed.pdsprj, Bomb Jack - Mode7 - Routed.pdsprj, Bomb Jack - Placed.pdsprj, Bomb Jack - Sprites - Routed.pdsprj, Bomb Jack - Tiles - Routed.pdsprj]
2020-07-08 Audio resister ladder schematic and layout done
    [Audio.pdsprj]
2020-07-08 Audio board sizing
    [Audio.pdsprj]
2020-07-09 Placed sample RAMs and some of the output combination ROMs
    This helps placement and routing
    [Audio - Placed Routed.pdsprj, Audio.pdsprj]
2020-07-09 Added new resistors placement group "Audio"
    [Audio.pdsprj]
2020-07-10 Fixed duplicate, but placement excluded, resistor.
    [Audio.pdsprj, Bill Of Materials Audio - Audio.csv]
2020-07-10 Video layout done, added proper output connectors. Analogue components are disabled in the simulation
    [Bomb Jack.pdsprj]
2020-07-10 Analogue components are disabled in the simulations
    [Audio.pdsprj]
2020-07-10 Adding trim variable resistors to each component output
    [Bomb Jack.pdsprj]
2020-07-10 Video needed slightly more space
    [Bomb Jack.pdsprj]
2020-07-11 Mode7 needed a slightly bigger board for routing
    [Bomb Jack.pdsprj]
2020-07-11 Video board needed a touch more space for placement
    [Bomb Jack.pdsprj]
2020-07-12 Connectivity check passes
    [Bomb Jack - Placed Routed.pdsprj, Bomb Jack - Placed.pdsprj]
2020-07-12 Expand placement of some mode7 memory ICs
    [Bomb Jack.pdsprj]
2020-07-12 Generated routed boards and added notes for future tool investigation
    [Bomb Jack - Chars.pdsprj, Bomb Jack - Mode7 - full place.pdsprj, Bomb Jack - Mode7.pdsprj, Bomb Jack - Placed Routed.pdsprj, Bomb Jack - Placed.pdsprj, Bomb Jack - Sprites.pdsprj, Bomb Jack - Tiles.pdsprj, Bomb Jack - Video.pdsprj]
2020-09-06 Ordered these PCBs
    [Audio - Placed Routed.pdsprj, Bill Of Materials Audio - Audio.csv, Bomb Jack - Chars - Placed.pdsprj, Bomb Jack - Chars - Routed.pdsprj, Bomb Jack - Chars.pdsprj, Bomb Jack - Mode7 - Placed.pdsprj, Bomb Jack - Mode7 - Routed.pdsprj, Bomb Jack - Mode7 - full place.pdsprj]
2020-10-07 Updating documentation and components
    [Bomb Jack.pdsprj, DebugPatternGenerator.pdsprj]
2020-10-08 Temporarily disabled 4E 4F and removed from placement. Wires connecting input to output added.
    [Bomb Jack.pdsprj]
2020-10-09 Added 4A 4B 4C 4D with {GROUP=Sprites} to the sprites board
    [Bomb Jack.pdsprj]
2020-10-10 Sprite board generated in V3.0 folder
    [Bill Of Materials Bomb Jack.csv, Bomb Jack - Sprites - Placed.pdsprj, Bomb Jack - Sprites - Routed.pdsprj, Bomb Jack - Sprites.pdsprj, Bomb Jack.pdsprj]
2020-10-11 Rotated the memory bus and video headers in the schematic to match the PCB orientation
    [Bomb Jack.pdsprj]
2020-10-11 Schematic pixel headers rotated to match PCB
    [Bomb Jack.pdsprj]
2020-10-18 Some components were using the wrong packages
    No idea how that happened.
    [Bomb Jack.pdsprj]
2020-10-18 6116FAST (chosen in the mouser.sg link) uses a narrow IC package
    [Bomb Jack - Mode7 - Placed.pdsprj, Bomb Jack - Mode7 - Routed.pdsprj, Bomb Jack - Mode7.pdsprj, Bomb Jack - Sprites - Placed.pdsprj, Bomb Jack - Sprites - Routed.pdsprj, Bomb Jack - Sprites.pdsprj, Bomb Jack.pdsprj]
2020-10-25 Rotated the user port schematic headers to match the PCB
    [UserPortTo24BitAddress.pdsprj]
2020-10-25 tweaked board size for auto place and route success
    [UserPortTo24BitAddress.pdsprj]
2020-10-27 UserPortTo24BitAddressSimple.pdsprj is a simple user port interface
    [UserPortTo24BitAddressSimple.pdsprj]
2020-11-03 Updating user port breakout connectors
    [UserPortBreakout.pdsprj, UserPortTo24BitAddress.pdsprj]
2020-11-04 checked user bus header layout
    [UserPortBreakout.pdsprj, UserPortTo24BitAddress.pdsprj]
2020-11-04 Added power planes, both GND
    [UserPortBreakout.pdsprj]
2020-11-05 Created "BDD6502\features\TestVideoHardware Chars.a" and "BDD6502\features\TestVideoHardware Chars.feature" which uses a simple address bus and displays a static char screen using real 6502 code
    [Bomb Jack - Sprites - Placed.pdsprj, Bomb Jack - Sprites - Routed.pdsprj, Bomb Jack - Sprites.pdsprj, UserPortBreakout.pdsprj, UserPortTo24BitAddress.pdsprj]
2020-11-21 simple memory bus tweaks based on hardware observations
    [Bill Of Materials UserPortBreakout.csv, Bill Of Materials UserPortTo24BitAddress.csv]
2020-11-26 Updated design and TODO
    [Bill Of Materials Bomb Jack - Sprites - Routed.csv, Bill Of Materials UserPortTo24BitAddress.csv, UserPortTo24BitAddress.pdsprj]
2020-12-03 Addded improved user port _PC signal handling
    [UserPortTo24BitAddress.pdsprj]
2020-12-17 Weak pull-up resistors (5.6k) we added to the outputs of U80
    [Bomb Jack using demultiplexor to selct SPRFULL.pdsprj, Bomb Jack.pdsprj]
2020-12-18 pixel header rotations need to be consistent across the boards
    [Bomb Jack.pdsprj]
2020-12-18 SC4 allows the upper or lower palette to be used by the char screen instead
    [Bomb Jack - Chars - Placed.pdsprj, Bomb Jack - Chars - Routed.pdsprj, Bomb Jack.pdsprj]
2020-12-18 Check that chars ICs are in Chars group
    [Bomb Jack.pdsprj]
2020-12-18 Chars V3.1 to prod
    [Bomb Jack - Chars - Placed.pdsprj, Bomb Jack - Chars - Routed.pdsprj, Bomb Jack.pdsprj]
2020-12-23 Adding char screen banks and display disable
    Pixel output headers moved around relative to the video generation board.
    [Bomb Jack.pdsprj]
2021-01-03 V3.1 and V4.0 board tweaks
    [Bill Of Materials Bomb Jack - Chars - Routed.csv, Bill Of Materials Bomb Jack - Tiles - Routed - Packages only.csv, Bill Of Materials Bomb Jack - Tiles - Routed - Packages.csv, Bill Of Materials Bomb Jack - Tiles - Routed.csv, Bomb Jack - Tiles - Placed.pdsprj, Bomb Jack - Tiles - Routed - pick n place.csv, Bomb Jack - Tiles - Routed.pdsprj, Bomb Jack.pdsprj]
2021-01-15 Staring to spec out the APU board
    Adding extra video API
    [APU.pdsprj]
2021-01-16 Adding bus selection logic
    Also adding memory logic
    [APU.pdsprj]
2021-01-16 Adding logic for control registers, reset etc
    [APU.pdsprj]
2021-01-17 Adding extra memory logic for the APU
    [APU.pdsprj]
2021-01-17 Recording RHRV for a frame
    [Bomb Jack.pdsprj]
2021-01-17 Need a recording of _VBLANK, RH0..8, RV0..7 for the signal generator that will emulate the video hardware signals
    [APU.pdsprj]
2021-01-17 Ponder microcode layout
    [APU.pdsprj]
2021-01-17 Added 2114 RAM instead, to give INSTR0..15
    [APU.pdsprj]
2021-01-18 Components should be placed in imperial mode
    [APU.pdsprj, Audio.pdsprj, Bomb Jack - Tiles - Placed 2 m not pressed.pdsprj, Bomb Jack - Tiles - Placed 2 m pressed.pdsprj, Bomb Jack.pdsprj, UserPortTo24BitAddress.pdsprj]
2021-01-18 Simple APU program with loop
    [APU.pdsprj, Bill Of Materials Bomb Jack - Tiles - Routed - Packages only.csv, Bill Of Materials Bomb Jack - Tiles - Routed - Packages.csv, Bill Of Materials Bomb Jack - Tiles - Routed.csv, Bomb Jack - Tiles - Placed 2 m not pressed.pdsprj, Bomb Jack - Tiles - Placed 2 m pressed.pdsprj, Bomb Jack - Tiles - Placed.pdsprj, Bomb Jack - Tiles - Routed - pick n place.csv]
2021-01-19 Intercept bus logic
    [APU.pdsprj]
2021-01-19 WaitForEqualsHV logic seems to be working
    [APU.pdsprj]
2021-01-19 APU Memory read / write
    [APU.pdsprj]
2021-01-19 TestAPU1.a works so far!!!
    [APU.pdsprj]
2021-01-19 Fixing PCB exclusions and group
    [APU.pdsprj]
2021-01-19 Adjust APU board size
    [APU.pdsprj]
2021-01-20 Need to check the bus sharing for RAM writes coming from an external source
    [APU - Routed.pdsprj, APU.pdsprj]
2021-01-20 Write timing checks of the instruction RAM
    Needed to use the chip output with less delay
    [APU.pdsprj]
2021-01-23 Adding code tweaks to handle raster timers and sprite init
2021-01-25 Debugging hardware tiles scroll X & 7 == 7 issue
    [Bomb Jack.pdsprj]
2021-01-26 Tiles and chars version bump to V4.1
    Checed layer groups
    [Bomb Jack.pdsprj]
2021-01-27 the video board output needs to be properly latched to present a consistent stable source of RH and RV
    [Bomb Jack.pdsprj]
2021-01-27 Adding programmable layer priority
    [Bomb Jack.pdsprj]
2021-01-28 The video RV needs to start counting from its load value, not be reset on display disable
    [Bomb Jack.pdsprj]
2021-02-01 Video layer improvements
    Video layer now controls DISPLAYENABLE,_DISPLAYENABLE,BGBORDERX,BGBORDERY instead of the tiles layer.
    Video layer priority can now be changed during runtime.
    [Bomb Jack.pdsprj]
2021-02-02 Updating data generation for priority change test
    Also the data generator clock is now independant of the VIDCLK
    [Bomb Jack.pdsprj]
2021-02-02 More data debugging
    [Bomb Jack.pdsprj]
2021-02-03 Updated to use new digital data model
    [APU.pdsprj, Audio.pdsprj, Bomb Jack.pdsprj]
2021-02-04 Layer priority select, version bump, video PCB size increased
    [Bomb Jack - Video - Placed.pdsprj, Bomb Jack.pdsprj]
2021-02-04 Bit plane decoding logic, removed the need for duplicate decoders/demultiplexers
    [Bomb Jack.pdsprj]
2021-02-05 Add extra bit plane for each layer, change to using 16 colours for each CLUT
    [Bomb Jack - Video - Placed.pdsprj, Bomb Jack.pdsprj]
2021-02-06 Adjusting board size and some IC placement, usually memory grouping related
    [Bomb Jack - Chars - Placed.pdsprj, Bomb Jack - Sprites - Placed.pdsprj, Bomb Jack.pdsprj]
2021-02-11 Adding extra library support for mode7 and flips
    [Bomb Jack - Chars - Placed.pdsprj, Bomb Jack - Mode7 - Placed.pdsprj, Bomb Jack - Sprites - Placed.pdsprj, Bomb Jack - Tiles - Placed.pdsprj, Bomb Jack.pdsprj]
2021-02-27 Testing APU RAM access speed with VIDCLK
    [APU.pdsprj, Bomb Jack.pdsprj]
2021-02-27 Missing inputs on one of the flip-flops
    [APU.pdsprj]
2021-02-28 Debugging APU
    [APU.pdsprj]
2021-02-28 Fixing APU memory write delay issue
    [APU.pdsprj]
2021-02-28 Optimise APU memory copy
    [APU.pdsprj]
2021-03-01 Added extra latch for instruction bits 8-15
    [APU.pdsprj]
2021-03-14 APU in schematic and test data needs EBBS changed from 0x04 to 0x02
    Since the audio layer already uses 0x04 for sample data
    [APU.pdsprj]
2021-03-18 Adding sprite RH and addr recording, for debug purposes
    The Bus24Bit memory copy needs to setup for any subsequent 256 byte page copy
    [Bomb Jack.pdsprj]
2021-04-03 Adding APU external memory bus recording for validation
    [APU.pdsprj]
2021-04-03 2 bit instruction read works, with latch
    [APU.pdsprj]
2021-04-03 Added instruction up to kAPU_Incr_EADDR2
    Validation still OK
    [APU.pdsprj]
2021-04-03 Solved spurious write data issue
    [APU.pdsprj]
2021-04-04 Expanded APU seems to be working
    Incredibly the debug bus output from UserPortTo24BitAddressTest.java : checkAPU2 used for the digital data input shows the DebugAPUOutput.txt matches the unit test expectations.
    [APU.pdsprj]
2021-04-05 Add back plane connector options for the memory bus and video signals
2021-04-08 Diagnosed the sprites corruption issue
    [APU - Placed.pdsprj, APU - Routed.pdsprj, Bomb Jack - Mode7 - Placed.pdsprj, Bomb Jack - Sprites - Placed.pdsprj, Bomb Jack - Sprites - Routed.pdsprj, Bomb Jack - Tiles - Placed.pdsprj]
2021-04-10 * Added U54:C 7432 extra OR gate to help the sprite register load signals
    [Bomb Jack.pdsprj]
2021-04-11 Add a new display "filter signals shorter than" option to the digital display
    [Bomb Jack.pdsprj]
2021-04-14 Changing connectivity to DIN and backplane
    [Bomb Jack - Backplane - Placed.pdsprj, Bomb Jack.pdsprj]
2021-04-15 Added RA DIN type plug and vertical DIN headers. Added RA female VGA
    [Bomb Jack - Video - Placed.pdsprj, Bomb Jack.pdsprj]
2021-04-15 Pixel headers as RA enclosed
    [Bomb Jack.pdsprj]
2021-04-15 Moved remaining headers to the backplane
    [Bomb Jack - Video - Placed.pdsprj, Bomb Jack.pdsprj]
2021-04-15 Adjust video layer size to fit
    [Bomb Jack - Video - Placed.pdsprj, Bomb Jack - Video - Routed.pdsprj, Bomb Jack.pdsprj]
2021-04-15 Resize chars layer to fit
    [Bomb Jack - Chars - Placed.pdsprj, Bomb Jack - Chars - Routed.pdsprj, Bomb Jack.pdsprj]
2021-04-16 Validated the main layers with two planes
    [Bomb Jack - Sprites - Placed.pdsprj, Bomb Jack - Sprites - Routed.pdsprj, Bomb Jack - Tiles - Placed.pdsprj, Bomb Jack - Tiles - Routed.pdsprj]
2021-04-17 Changing APU connectors to the DIN type
    [APU - Placed.pdsprj, APU.pdsprj]
2021-04-17 Video, APU, Audio updated with new DIN connectors
    [APU - Placed.pdsprj, Audio.pdsprj, Bomb Jack.pdsprj]
2021-04-18 Audio updated with DIN connectors and verified audio output using @RPG demo
    [Audio - Placed.pdsprj, Audio - Routed.pdsprj, Audio.pdsprj]
2021-04-24 Back plane headers are 1,000 mil, ~23mm apart
    Added to the backplane headers: UNUSEDEXPANSION*, UNUSEDVIDEO*
    [Bomb Jack.pdsprj]
2021-04-25 PCB Prep
    [Bomb Jack - Backplane - Placed.pdsprj, Bomb Jack - Backplane - Routed - BOM.xlsx, Bomb Jack - Backplane - Routed.csv, Bomb Jack - Backplane - Routed.pdsprj, Bomb Jack - Video - Routed - BOM.csv, Bomb Jack - Video - Routed - PNP.csv]
2021-04-25 7A2 8B2 pos X aligned to thous
    [Bomb Jack.pdsprj]
2021-04-26 Schematic kAPU_PCLoad16
    [APU.pdsprj]
2021-04-26 Schematic kAPU_SkipIfEQ
    [APU.pdsprj]
2021-04-30 Add stock codes for missing ICs and stock codes for sockets (supplier property)
    [APU - Placed.pdsprj, APU - Routed.pdsprj, APU.pdsprj, Audio.pdsprj, Bomb Jack.pdsprj, UserPortTo24BitAddress.pdsprj]
2021-04-30 72LS283NE4 links added
    [Bill Of Materials Bomb Jack.csv, Bomb Jack - Mode7 - Placed.pdsprj, Bomb Jack - Mode7 - Routed.pdsprj, Bomb Jack.pdsprj]
2021-05-01 RGB palette macro
    [Bill Of Materials Bomb Jack.csv]
2021-05-04 Emulation and schematic: kAPU_SkipIfEQ: In combination with a full 8 bit EQ check
    [APU.pdsprj]
2021-05-06 Updated stock codes
    [Bill Of Materials Bomb Jack components.csv, Bill Of Materials Bomb Jack components.ods, Bomb Jack.pdsprj]
2021-05-07 Remove kAPU_InterceptBus
    [APU.pdsprj, Bomb Jack.pdsprj]
2021-05-08 Remove kAPU_Reset_EBSEADDR
    [APU.pdsprj]
2021-05-08 Schematic and code changes done for extra data select logic
    [APU.pdsprj]
2021-05-09 Resized PCB for new functionality
    [APU.pdsprj]
2021-05-09 APU = V5.0
    [APU - Placed.pdsprj, APU.pdsprj]
2021-05-09 APU V5.0 routed
    [APU - Placed.pdsprj, APU - Routed.pdsprj]
2021-05-10 Added jumpers for EBS on main video boards
    [Bomb Jack - Chars - Placed.pdsprj, Bomb Jack - Chars - Routed.pdsprj, Bomb Jack - Mode7 - Placed.pdsprj, Bomb Jack - Mode7 - Routed.pdsprj, Bomb Jack - Sprites - Placed.pdsprj, Bomb Jack - Sprites - Routed.pdsprj, Bomb Jack - Tiles - Placed.pdsprj, Bomb Jack - Tiles - Routed.pdsprj]
2021-05-15 Char screen scrolling
    [Bomb Jack - Chars scroll.pdsprj, Bomb Jack - Sprites - Placed.pdsprj, Bomb Jack - Sprites - Routed.pdsprj, Bomb Jack.pdsprj]
2021-05-15 Board size and groups checked
    [Bomb Jack.pdsprj]
2021-05-15 Chars IC merging
    [Bomb Jack.pdsprj]
2021-05-16 Updated demo gif and routed the new chars board
    [Bomb Jack - Chars - Placed.pdsprj, Bomb Jack - Chars - Routed.pdsprj]
2021-05-25 APU layout updated with EBS selection jumpers
    [APU.pdsprj]
2021-05-25 Chars board now has a keep out area
    https://support.labcenter.com/forums/viewtopic.php?p=25995#p25995
    [Bomb Jack - Chars - Placed.pdsprj, Bomb Jack - Chars - Routed.pdsprj, Bomb Jack.pdsprj]
2021-06-05 Adjusted the left hand board edges to match the edge locating lip for the plugs
    Also adjusted the VGA output header position to sit further inside the edge
    [APU.pdsprj, Audio.pdsprj, Bomb Jack.pdsprj]
2021-06-08 Updates for next boards
    [Bill Of Materials Bomb Jack - Video - Routed.csv, Bill Of Materials Bomb Jack - Video - Routed.ods]
2021-06-09 Rename IC names like "5E2"
    Moved the labels on the board edge plugs
    [APU.pdsprj, Audio.pdsprj, Bomb Jack.pdsprj]
2021-06-09 The edge jumpers are marked with the default choice to close
    Board _EXTCS default connections now have labels
    [Bomb Jack.pdsprj]
2021-06-09 Make sure power planes are type plane by default
    [Bomb Jack.pdsprj]
2021-06-11 Audio and APU boards, with EBS selection jumpers and plane layers, are aligned with the main boards
    [APU.pdsprj, Audio.pdsprj, Bomb Jack - Chars - Placed.pdsprj, Bomb Jack - Chars - Routed.pdsprj, Bomb Jack - Mode7 - Placed.pdsprj, Bomb Jack - Mode7 - Routed.pdsprj, Bomb Jack - Sprites - Placed.pdsprj, Bomb Jack - Sprites - Routed.pdsprj]
2021-06-12 Generated latest V5.0 build files
    Also tweaked the layouts to be more consistent with their silkscreen markings
    [APU.pdsprj, Audio.pdsprj, Bill Of Materials Bomb Jack - Chars - Routed.csv, Bill Of Materials Bomb Jack - Sprites - Routed.csv, Bill Of Materials Bomb Jack - Tiles - Routed.csv, Bill Of Materials Bomb Jack - Video - Routed.ods, Bomb Jack - Chars - Routed - BOM.xlsx, Bomb Jack - Chars - Routed - PNP.csv]
2021-06-12 Audio output resistor tweaks
    [APU - Placed.pdsprj, APU - Routed.pdsprj, Audio - Placed.pdsprj, Audio - Routed.pdsprj, Audio.pdsprj]
2021-06-13 APU add components and packages to BOM
    [APU.pdsprj]
2021-06-13 Audio: 4082 to be replaced by 74LS21
    [Audio.pdsprj]
2021-06-13 Audio: 4075 to be replaced by 74 series logic. 7427 + 7404
    [Audio.pdsprj]
2021-06-13 Audio: 7413 to be replaced by 7420
    [Audio.pdsprj]
2021-06-13 Audio: 7483 to be replaced by 74283
    [Audio.pdsprj]
2021-06-13 Adding stock codes
    [Audio.pdsprj]
2021-06-13 Audio: 74154 to be replaced by 74 series logic... A few more 74HC138
    [Audio.pdsprj]
2021-06-13 Audio: Stock code and Supplier updated
    [Audio.pdsprj]
2021-06-16 Audio routed with 8 layers
    [Audio - Placed.pdsprj, Audio - Routed - 8.pdsprj, Audio - Routed.pdsprj, Audio.pdsprj]
2021-06-19 Two 6116 SRAM have been added, the original 2114 SRAMs have been disabled from the simulation, but left in the layout to allow for both chip types to be used.
    [Bomb Jack.pdsprj]
2021-06-19 Checked trimmer resistors
2021-06-20 Documentation
    Removed old TODO items completed for V5.0
    [Bomb Jack - Video - Placed.pdsprj, Bomb Jack.pdsprj]
2021-06-24 Adding kAPU_InternalMEWR
    [APU.pdsprj, Bomb Jack - Chars - Placed.pdsprj]
2021-07-06 APU Layout sizing
    [APU.pdsprj, Bomb Jack - APU - Placed.pdsprj, Bomb Jack - APU - Routed.pdsprj]
2021-07-07 Quickly updated the 8 and 2 position right angled single row to use better component
    Removing solder cup version
    [Audio.pdsprj, Bomb Jack.pdsprj]
2021-07-07 Making sure placed components have a room and ordering links in the new design
    [Bill Of Materials Bomb Jack IC components.ods, Bill Of Materials Bomb Jack.csv, Bomb Jack.pdsprj]
2021-07-24 Even doing a tight poll in a thread doesn't help much
    [main.cpp]
2021-07-24 Importing whole https://github.com/wiringpi/wiringpi
2021-07-24 Even adding digitalReadFromCache() didn't really help much
    [main.cpp, wiringPi.c, wiringPi.h]
2021-07-28 This code is originally from these repos:
    https://github.com/fbergama/pigfx
    Specifically: https://github.com/fbergama/pigfx/tree/e4579a8653ec4d43ec5b5b94d9fd740d67e02359
    Needed https://github.com/rsta2/uspi/tree/2d6f33c6daa052137a0fe05bb74026d795b65b9e to be extracted to uspi\
    [raspi.cfg]
2021-07-28 Frame buffer size init
2021-07-30 Buffer C64 user port data with time and render a frame behind
2021-08-06 Fix bitmap and palette data transfer
    [C64UserPort24Bit.c, gfx.c, pigfx.c]
2021-08-12 TODO update
    [APU.pdsprj]
2021-08-15 Board debugging
2021-08-22 Adding APU clock divider
    [APU.pdsprj]
2021-09-14 Moving APU speed to JP11 timing
    Adjusting memory setup and verifying pulse timing in the video schematic
    Added project for combined IC sockets and decoupling caps
    [APU.pdsprj, Bomb Jack.pdsprj, SocketsWithCaps.pdsprj]
2021-09-15 This records the internal bus on _InternalMEWRPulse
    [APU.pdsprj]
2021-09-15 _MEWRSLOT now triggers at cycle 6+0/1 and hits _ExternalMEWRPulse or _InternalMEWRPulse
    [APU.pdsprj]
2021-09-16 Updated APU schematic to include more virtual scopes
    [APU.pdsprj]
2021-09-18 Testing a build with caps instead of sockets
    [Bill Of Materials Bomb Jack - CAP Test - Routed - CAPS.csv, Bill Of Materials Bomb Jack - CAP Test - Routed.csv, Bomb Jack - CAP Test - Placed.pdsprj, Bomb Jack - CAP Test - Routed - PNP.csv, Bomb Jack - CAP Test - Routed.pdsprj, Bomb Jack - CAP Test.pdsprj, SocketsWithCaps.pdsprj]
2021-09-19 All pull-up (PULLUP) resistor values on the sprite layer were changed
    [Bomb Jack.pdsprj]
2021-09-19 Debugging incorrect raster bar wait position
    [APU.pdsprj, Bomb Jack.pdsprj]
2021-09-20 Check the APU retry opcode works when it detects writes to its data/instruction memory from an external source
    Add extra validation for delta timings
    [APU.pdsprj]
2021-09-26 project file updated for new digital data model
    [APU - Placed.pdsprj, APU - Routed.pdsprj]
2021-09-29 Update digital data from library
    [Bomb Jack.pdsprj]
2021-10-02 Sprites2 scan line logic
    [Bomb Jack.pdsprj]
2021-10-04 Schematic at: insideHeight = (displayV + currentSpriteY);
    [Bomb Jack.pdsprj]
2021-10-04 Schematic case 7: "Perform Y extent check" checked working.
    [Bomb Jack.pdsprj]
2021-10-04 Swap MSBX/Y to match the flips
    [Bomb Jack.pdsprj]
2021-10-05 case 13: scan clock enable and load logic
    [Bomb Jack.pdsprj]
2021-10-05 Fix for the internal Y height check carry
    [Bomb Jack.pdsprj]
2021-10-05 currentSpriteXPixel = currentSpriteScaleXInv / 2
    [Bomb Jack.pdsprj]
2021-10-05 S2currentSpriteXPixel[0..15] and S2nextSpriteXPixel[0..15]
    [Bomb Jack.pdsprj]
2021-10-06 if ((currentSpriteXPixel >> 4) >= currentSpriteScaleExtentX)
    [Bomb Jack.pdsprj]
2021-10-06 currentSpriteYPixel lookup table access
    [Bomb Jack.pdsprj]
2021-10-06 The sprite load schedulers (that choose which register to read from RAM) needed to be off for S2LINESTART
    [Bomb Jack.pdsprj]
2021-10-06 Added Sprite2 memory logic
    [Bomb Jack.pdsprj]
2021-10-07 currentSpriteXPixel and currentSpriteYPixel pixel data fetch
    using the sprite frame
    [Bomb Jack.pdsprj]
2021-10-07 invert currentSpriteXPixel and currentSpriteYPixel
    [Bomb Jack.pdsprj]
2021-10-07 Enabled old sprites layer again.
    RunTests.bat passed.
    [Bomb Jack.pdsprj]
2021-10-09 Update TODO
    [Bomb Jack - Sprites2 - Placed.pdsprj, Bomb Jack - Sprites2 - Routed.pdsprj]
2021-10-10 Need to tidy the components to their layers.
    Removed old 2114 RAMs from the sprite scan layout 4A/4B/4C/4D
    [Bomb Jack.pdsprj]
2021-10-10 Sprites2: Trigger on rising horizontal blank edge to edge set flip-flop.
    [Bomb Jack.pdsprj]
2021-10-10 Testing new sprite2 logic with emulation
    [Bomb Jack.pdsprj]
2021-10-12 Sprite2 scale now *32
    Also fixed the logic that detects the sprite X >= extent test and and changes internal state back to fetching sprite registers
    The cascaded comparators can produce a momentary glitch, but isn't longer than the 6MHz low to high edge
    Removed the latch (flip-flop without clock) for the state and used simpler logic
    [Bomb Jack.pdsprj]
2021-10-13 The last sprite register RAM address selector also needed to be connected, it was floating which meant the sprites were not being stored to the correct address
    [Bomb Jack.pdsprj]
2021-10-13 Also need currentLineV to match emulation. To avoid the Y coord changing during the scan die to triggering at HSYNC
    [Bomb Jack.pdsprj]
2021-10-14 $9100 = $01 = Enable sprites2
    [Bomb Jack.pdsprj]
2021-10-14 Simplified the mode7 logic to remove the second pixel pipeline and use the entire 6MHz clock phase on the remaining pipeline to latch the input and latch the output
    [Bomb Jack.pdsprj]
2021-10-14 Sprites2: Fixed the logic contention in the sprite scan buffer by moving the 6MHz OE for the input pixel selector to be earlier in the OR tree and moving the DOPIXEL and sprite enable OR later.
    [Bomb Jack.pdsprj]
2021-10-14 Logic ICs need tidying again
    [Bomb Jack.pdsprj]
2021-10-14 Removed mode7 unused ICs from layout
    [Bomb Jack.pdsprj]
2021-10-15 Reduce mode7 layout size
    [Bomb Jack - Mode7 - Placed.pdsprj, Bomb Jack.pdsprj]
2021-10-16 Sprite2: Frame now has added | 0x40 = halfX | 0x80 = halfY
    [Bomb Jack.pdsprj]
2021-10-16 Testing TTL level clear logic
    [Bomb Jack no pullups for Sprites2 on left hand line logic sheet 12.pdsprj]
2021-10-17 Sprite2: Logic contentions on the scan RAMs, but only for some parts of the screen, not all lines.
    [Bomb Jack.pdsprj]
2021-10-17 Sprites2: Merging some of the ICs to reduce IC count
    [Bomb Jack.pdsprj]
2021-10-19 Sprites2: End of list implementation
    [Bomb Jack.pdsprj]
2021-10-20 Organised ICs again :D
    [Bomb Jack.pdsprj]
2021-10-20 Sprites2 board sizing
    [Bomb Jack - Sprites2 - Placed.pdsprj, Bomb Jack - Sprites2 - Routed.pdsprj, Bomb Jack.pdsprj]
2021-10-26 Left/right border edge logic updated to feed into one pathway - Identical output images
    [Bomb Jack - temp.pdsprj, Bomb Jack.pdsprj]
2021-10-26 Remove old files
    [Bomb Jack - temp.pdsprj]
2021-10-26 Less than and greater than range check works for a couple of fixed values
    [Bomb Jack.pdsprj]
2021-10-27 Add logic to latch $9e09
    [Bomb Jack.pdsprj]
2021-10-27 Testing horizontal over scan mode
    [Bomb Jack.pdsprj]
2021-10-27 Sprites2 overscan test data
    [Bomb Jack.pdsprj]
2021-10-30 Disabled the overscan notch fix from the schematic...
    [Bomb Jack.pdsprj]
2021-10-31 Original board pictures from http://ikotsu.blogspot.com/2011/09/bomb-jack-pcb-tehkan-1984.html
2021-10-31 Connectors PIXEL1 and LAYER1 are using the wrong pins (orientations) compared to LAYER2/3/4 etc
    PIXEL6 is using the wrong output names
    And using the wrong orientation
    [Bomb Jack.pdsprj]
2021-10-31 Enable the overscan vsync calculation fix, the line number latch
    [Bomb Jack.pdsprj]
2021-10-31 Video layer, isolate the signals and ICs used for the timer generation.
    [Bomb Jack.pdsprj]
2021-10-31 Video layer: can have 4 register bits to enable each pixel input independently.
    [Bomb Jack.pdsprj]
2021-11-02 overscan hardware changes almost done
    Sprites have MSBX
    [Bomb Jack.pdsprj]
2021-11-03 Fixed sprites, fixed register latches time.
    Overscan video is a go.
    [Bomb Jack.pdsprj]
2021-11-04 Sprite scan RAMs chip enable use V and _HSYNC
    [Bomb Jack.pdsprj]
2021-11-04 Sprite enable flag
    [Bomb Jack.pdsprj]
2021-11-04 Chars enable flag
    [Bomb Jack.pdsprj]
2021-11-04 Tiles enable flag
    [Bomb Jack.pdsprj]
2021-11-04 Mode7 enable flag Shift bits down
    [Bomb Jack.pdsprj]
2021-11-04 Sprites2 enable flag
    [Bomb Jack.pdsprj]
2021-11-04 Fix sprites with overscan
    Added kBus24Bit_VideoLayer_HasOverscan
    [Bomb Jack.pdsprj]
2021-11-05 Updates for overscan mode
    [Bomb Jack.pdsprj]
2021-11-06 Simulation video capture width = 384 - 32 = 352
    [Bomb Jack.pdsprj]
2021-11-07 Simulation: Video capture add output sync render and warning
    [Bomb Jack.pdsprj]
2021-11-07 Add separate use display time, split from the current display in sync option
    [Bomb Jack.pdsprj]
2021-11-07 Added an early 3-input AND with ENABLEPIXELS, _HSYNC & _VSYNC output pixel disable
    [Bomb Jack.pdsprj]
2021-11-07 _EHSYNC _EVSYNC _ETVSYNC all need to be on the external headers and connectors.
    And other layers (mode7!) need to use them too.
    [Bomb Jack.pdsprj]
2021-11-08 Updated connectors in APU and Audio for new signals
    [APU.pdsprj, Audio.pdsprj, Bomb Jack.pdsprj]
2021-11-08 Grouping components
    [Bomb Jack.pdsprj]
2021-11-08 Video: Make a call to remove the placement of the 2114 RAMs
    Also merged ICs
    [Bomb Jack.pdsprj]
2021-11-08 More IC merging
    [Bomb Jack.pdsprj]
2021-11-09 Document new raster line schedule, especially for sprite fetches
    [Bomb Jack.pdsprj]
2021-11-10 Added extra schematic documentation for sprite multiplexing
    [Bomb Jack.pdsprj]
2021-11-11 Simulation and emulation updated for 1024 wide char screen - Tested with SotB demos
    [Bomb Jack.pdsprj]
2021-11-12 Update other demos that use overscan (Demo7 and Demo9)
    [Bomb Jack.pdsprj]
2021-11-13 Updating APU test to use new recorded RHRV schedule
    [Bomb Jack.pdsprj]
2021-11-14 Remove backplane signals
    _CMPBLK = UNUSEDVIDEO7
    CMPBLK = FINALENABLEPIXELS
    [APU.pdsprj, Audio.pdsprj, Bomb Jack.pdsprj]
2021-11-14 Split out 3TT:B from 3T:B to ensure the 3T and 4T ICs are very near each other
    Also added GND thick tracks
    [Bomb Jack.pdsprj]
2021-11-14 Added DIL24NARCAP20
    [Bomb Jack.pdsprj, SocketsWithCaps.pdsprj]
2021-11-14 Adding DIL*CAP20 to layout packages
    Fixup the REF for DIL20NARCAP20
    [Bomb Jack.pdsprj, SocketsWithCaps.pdsprj]
2021-11-14 Sprites R20 needed placement
    [Bomb Jack.pdsprj]
2021-11-14 Highlight the column, type in and append "CAP20" to the package name
    [Bomb Jack.pdsprj]
2021-11-16 Adjusting board sizes to fit
    [Bomb Jack - Chars - Placed.pdsprj, Bomb Jack - Chars - Routed.pdsprj, Bomb Jack - Mode7 - Placed.pdsprj, Bomb Jack - Mode7 - Routed.pdsprj, Bomb Jack - Tiles - Placed.pdsprj, Bomb Jack - Tiles - Routed.pdsprj, Bomb Jack - Video - Placed.pdsprj, Bomb Jack - Video - Routed.pdsprj]
2021-11-16 ICs to their layers
    [Bomb Jack - Chars - Placed.pdsprj, Bomb Jack - Chars - Routed.pdsprj, Bomb Jack - Mode7 - Placed.pdsprj, Bomb Jack - Mode7 - Routed.pdsprj, Bomb Jack - Tiles - Placed.pdsprj, Bomb Jack - Tiles - Routed.pdsprj, Bomb Jack - Video - Placed.pdsprj, Bomb Jack - Video - Routed.pdsprj]
2021-11-17 CheckConnectivity
    Include alias names for header nets
    Include video connector nets, including layer enable
    [Bomb Jack - All - Placed.pdsprj, Bomb Jack - All - Routed.pdsprj]
2021-11-17 Instead of headers for the address selects, use a bank of dip switches
    [APU.pdsprj, Audio.pdsprj, Bomb Jack.pdsprj]
2021-11-17 Shifted video input headers to the other side
    [Bomb Jack.pdsprj]
2021-11-18 reduce signal crosstalk on the video board between the digital and analogue parts
    [Bomb Jack - Video - Placed.pdsprj, Bomb Jack - Video - Routed.pdsprj, Bomb Jack.pdsprj]
2021-11-19 Header text protected by placement keepout and DIP switch default markers moved to the edge of the board with DIP switch moved away from the board edge
    [Bomb Jack - Chars - Placed.pdsprj, Bomb Jack - Chars - Routed.pdsprj, Bomb Jack.pdsprj]
2021-11-19 Add Stock Code
    [Bomb Jack - Chars - Placed.pdsprj, Bomb Jack - Chars - Routed.pdsprj, Bomb Jack - Video - Placed.pdsprj, Bomb Jack - Video - Routed.pdsprj, Bomb Jack.pdsprj]
2021-11-19 Add socket to the Supplier column
    [Bomb Jack.pdsprj]
2021-11-20 Video and chars boards V8.0
    [Bill Of Materials Bomb Jack - Chars - Routed.csv, Bill Of Materials Bomb Jack - Video - Routed.csv, Bomb Jack - All - 2.pdsprj, Bomb Jack - Chars - Placed.pdsprj, Bomb Jack - Chars - Routed - CADCAM - BOM.xlsx, Bomb Jack - Chars - Routed - PNP.csv, Bomb Jack - Chars - Routed.pdsprj, Bomb Jack - Mode7 - Placed.pdsprj]
2021-11-24 Added the option of recording the wait value with a supplied mask
    Project update needed since they use the DigitalData
    [APU.pdsprj, Audio.pdsprj, Bomb Jack.pdsprj]
2021-11-24 Adding debug display for WAIT_VAL[8..31]
    [APU.pdsprj]
2021-11-25 Check if _VIDCLK for the ID17 can be changed to be 6MHz instead
    [APU.pdsprj, Bomb Jack.pdsprj]
2021-11-25 Added a U95 to buffer the RH8 along with the U1 and U2, also placed these on the board connector
    [APU.pdsprj]
2021-11-26 Removed _VIDCLK generation and RH/RV latches
    [APU.pdsprj]
2021-11-26 Filter zero digital writes
    [Bomb Jack.pdsprj]
2021-11-26 Updated data recording option to ignore zero writes
    [APU.pdsprj]
2021-11-26 Fix APU: When reading data memory and incrementing the instruction when the memory is being written
    The instruction should not increment and the instruction will retry
    [APU.pdsprj]
2021-11-26 IEBSx wasn't being used for the internal APU dip switch... Doh!
    [APU.pdsprj]
2021-11-27 Debugging rare APU data RAM write issue
    [APU.pdsprj]
2021-11-27 Making _OE always low seems to solve the incorrect UND write issue
    [APU.pdsprj, UserPortTo24BitAddress.pdsprj]
2021-11-28 Debugging APU generated data
    Added extra debug to the APU
    [APU.pdsprj]
2021-11-28 Updating APU unit test
    [APU.pdsprj]
2021-11-28 Recorded RHRV includes 6MHz signal
    [APU.pdsprj, Bomb Jack.pdsprj]
2021-11-29 APU adjust board size
    Add GND track isolation and keep-out to audio
    [APU.pdsprj, Audio.pdsprj]
2021-11-29 Audio to use DIL*CAP20 packages and adjust board size
    [Audio.pdsprj]
2021-11-29 Audio larger
    [Audio.pdsprj]
2021-11-29 Audio size adjustments
    [Audio - Placed.pdsprj, Audio - Routed.pdsprj, Audio.pdsprj]
2021-11-30 Replace with: https://www.mouser.sg/ProductDetail/Bourns/3006P-7-101LF?qs=GiVA9kKujyafZRjN8HNnfA%3D%3D
    [Audio.pdsprj, Bomb Jack.pdsprj]
2021-11-30 Audio tested. BOMs updated
    [Audio.pdsprj, Bill Of Materials Bomb Jack - Chars - Routed - not full.csv, Bill Of Materials Bomb Jack - Video - Routed - full.csv, Bill Of Materials Bomb Jack - Video - Routed - not full.csv, Bomb Jack - Chars - Routed - CADCAM - BOM.xlsx, Bomb Jack - Video - Routed - CADCAM - BOM.xlsx, T-P17W382513A - Bomb Jack - Video - Routed - CADCAM - BOM.xlsx, T-P19W382513A - Bomb Jack - Chars - Routed - C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]
2021-11-30 Audio needs stereo headphone socket
    [Audio.pdsprj]
2021-11-30 Stock code
    [Audio.pdsprj]
2021-11-30 Add J3 headphone socket
    [Audio.pdsprj]
2021-11-30 Isolate Audio analogue signals from digital
    [Audio - Placed.pdsprj, Audio - Routed.pdsprj, Audio.pdsprj]
2021-12-01 Audio headphone prep
    [Audio - Placed.pdsprj, Audio - Routed.pdsprj, Audio.pdsprj]
2021-12-02 Reduce debug trace spam
2021-12-06 Vectors layer bank0 RAMs
    [Bomb Jack.pdsprj]
2021-12-06 bank0 RAMs data write, needs isolated address from bank1 RAMs data write
    [Bomb Jack.pdsprj]
2021-12-07 Vectors layer
    bank select register
    bank demux data from bank select register
    [Bomb Jack.pdsprj]
2021-12-07 Vectors layer functionally complete
    [Bomb Jack.pdsprj]
2021-12-08 Vectors layer will need code and supplier data added
    Layout created
    [Bomb Jack - Vectors - Placed.pdsprj, Bomb Jack - Vectors - Routed.pdsprj, Bomb Jack.pdsprj]
2021-12-08 Back to standard video output
    [Bomb Jack.pdsprj]
2021-12-24 Notes from tests
    [Bill Of Materials Bomb Jack - Chars - Routed - not full.ods]
2021-12-26 Dip switch on PCB needs numbers
    [APU.pdsprj, Audio.pdsprj, Bomb Jack.pdsprj]
2021-12-26 Added DSW9 to choose _EHSYNC or _ETVSYNC
    [Bomb Jack - Sprites - Placed.pdsprj, Bomb Jack - Sprites - Routed.pdsprj, Bomb Jack - Tiles - Placed.pdsprj, Bomb Jack - Tiles - Routed.pdsprj, Bomb Jack.pdsprj]
2021-12-26 Right angled connectors need silk screen indication
    [Bomb Jack.pdsprj]
2021-12-26 Tweaking the silkscreen
    [Bomb Jack.pdsprj]
2021-12-29 Tiles board size tweak
    [Bill Of Materials Bomb Jack - Sprites - Routed.csv, Bill Of Materials Bomb Jack - Tiles - Routed.csv, Bomb Jack - Sprites - Placed.pdsprj, Bomb Jack - Sprites - Routed - BOM.xlsx, Bomb Jack - Sprites - Routed - PNP.csv, Bomb Jack - Sprites - Routed.pdsprj, Bomb Jack - Tiles - Placed.pdsprj, Bomb Jack - Tiles - Routed - BOM.xlsx]
2022-01-03 Faster calc clock test
    [Bomb Jack.pdsprj]
2022-01-04 Fixed pixel output errors for faster scaled sprites
    [Bomb Jack.pdsprj]
2022-01-05 *** Fixed: Setting U313 _OE to be always low fixes the write issue...
    [Bomb Jack.pdsprj]
2022-01-06 Turned off the clock generation during the extended line start
    [Bomb Jack.pdsprj]
2022-01-06 Check all 6116 writes, in audio/APU/video by setting _OE to be always low
    [Bomb Jack.pdsprj]
2022-01-07 Generated data had a bug for the sprite MSBX :)
    Validated the output rendered between old and new SRAM 6116 writes changes.
    [Bomb Jack.pdsprj]
2022-01-09 Fix S2FRAME6HalfX/S2FRAME6HalfY signals (above).
    [Bomb Jack.pdsprj]
2022-01-10 There are still three bad lower left quadrant pixels visible
    [Bomb Jack.pdsprj]
2022-01-10 Switch back to default layer configuration
    [Bomb Jack.pdsprj]
2022-01-11 At the moment using _OE always low, like the APU data RAM
    [Bomb Jack.pdsprj]
2022-01-11 Vectors RAM write debugging
    [Bomb Jack.pdsprj]
2022-01-12 Vectors memory debugging
    [Bomb Jack.pdsprj]
2022-01-15 Debugging APU RAM writes
    [APU.pdsprj, Bomb Jack.pdsprj]
2022-01-16 Log test result
    [Bomb Jack.pdsprj]
2022-01-20 Debugging APU output to simulation rendering
    [APU.pdsprj]
2022-01-23 DG event queue
    [Bomb Jack.pdsprj]
2022-01-23 If the APU instruction or data is selected, then slam the bus select back to the external pass through mode
    [APU.pdsprj]
2022-01-27 Update on failing board debugging
2022-02-13 Simple CPU test
    [SimpleCPU.pdsprj]
2022-02-14 Simple CPU test seems to work correctly
    [SimpleCPU.pdsprj]
2022-02-15 SimpleCPU test updated
    [SimpleCPU.pdsprj]
2022-02-19 Sprites2: ROM needs ZIF socket space, or at least a socket with wipes (not precision)
    [Audio.pdsprj, Bomb Jack.pdsprj]
2022-02-19 Sprites2 via1 region expand
    [Bomb Jack.pdsprj]
2022-03-03 Sprites2 board release
    [Bill Of Materials Bomb Jack - Sprites2 - Routed.csv, Bomb Jack - Sprites2 - Placed.pdsprj, Bomb Jack - Sprites2 - Routed - BOM.xlsx, Bomb Jack - Sprites2 - Routed - PNP.csv, Bomb Jack - Sprites2 - Routed.pdsprj]
2022-04-13 Mode7 added 74138 U413 to differentiate
    [Bomb Jack.pdsprj]
2022-04-13 Vectors in schematic moved to $a100 with existing differentiator
    [Bomb Jack.pdsprj]
2022-04-13 Update Mode7 and Vectors software layer and code defines for the test to match new differentiator for address $a100
    [Bomb Jack.pdsprj]
2022-04-14 Vectors: Perhaps have an independent disable in the hit MSB of the bank select, to output zeros and kill the counters?
    [Bomb Jack.pdsprj]
2022-04-15 Created the Combiner layer (merge layer)
    Now the Sprites2 and Vectors layers are enabled in the schematic.
    [Bomb Jack - Combiner - Placed.pdsprj, Bomb Jack.pdsprj]
2022-04-18 Audio RMS voltage clarification
    [TTL to SCART resistor ladder.pdsprj]
2022-04-24 Adding board power usage and thermal imaging
2022-06-07 For Sprites: Using two 74LS258 instead
    Both sides now, resistors removed from simulation. Both work.
    [Bomb Jack.pdsprj]
2022-06-07 For Sprites2: Adding explicit FF logic
    [Bomb Jack.pdsprj]
2022-06-07 Pullups for Y height need explicit logic? It's not a very used feature...
    Sprites and Sprites2 PCB to V9.0
    [Bomb Jack.pdsprj]
2022-06-08 Remove single inverter for the SPRFULL signal and change the demux inputs
    Removed, excluded, all pullups from PCBs
    [Bomb Jack.pdsprj]
2022-06-08 Tidy components and groups
    [Bomb Jack.pdsprj]
2022-06-08 Design Rules VIA* Pad-Pad = 35th
    [APU.pdsprj, Audio.pdsprj]
2022-06-09 Impedance resistors don't get placed
    [TTL to SCART resistor ladder.pdsprj]
2022-06-14 Added 74LS373 and suitable resistor ladder to the analogue area of the board
    [Audio.pdsprj]
2022-06-14 Audio: Add separate debug headers for each channel. Include GND/5V/MIDREF lines and digital debug points
    [Audio.pdsprj]
2022-06-16 Audio: Oscillator instead of crystal
    [Audio.pdsprj, Bomb Jack.pdsprj]
2022-06-17 Audio: Successful auto place and route
    Lower right quadrant still has empty space however.
    [Audio.pdsprj]
2022-06-17 Audio: Auto place and route works
    [Audio.pdsprj]
2022-06-17 Audio: Auto place and route successful
    [Audio - Routed.pdsprj, Audio.pdsprj]
2022-06-17 Merged holes
    [Audio - Routed.pdsprj]
2022-06-17 Audio release
    [Audio - Routed - BOM.xlsx, Audio - Routed - PNP.csv, Audio - Routed.pdsprj, Bill Of Materials Audio - Routed.csv]
2022-06-18 Audio: documenting eight layer stackup
    Changing PCB silkscreen to show V9.0
    [Audio - Routed.pdsprj, Audio.pdsprj]
2022-06-18 After pre-prod check
    [Audio - Routed.pdsprj]
2022-06-25 Audio: Mounting hole size issue: https://support.labcenter.com/forums/viewtopic.php?f=11&t=8204
    [Audio.pdsprj]
2022-06-25 Case options and release build
    [Audio - Routed.pdsprj]
2022-07-26 Check 3 TI parts with their SMT
    [Bill Of Materials Audio.csv, SocketsWithCaps.pdsprj]
2022-07-27 SMT SSOP with caps
    [SocketsWithCaps.pdsprj]
2022-07-28 Audio board, one CAP20 package added
    Audio release build
    [Audio - Placed.pdsprj, Audio - Routed - BOM.xlsx, Audio - Routed - PNP.csv, Audio - Routed.pdsprj, Audio.pdsprj]
2022-08-10 Move U73 the common volume calculation lookup
    [Audio - Placed.pdsprj, Audio - Routed.pdsprj, Audio.pdsprj]
2022-08-17 U91:C -> U71:C
    [Audio.pdsprj, Bomb Jack - All - Routed.pdsprj]
2022-09-17 Hardware changes passed with Demo1 tune and Demo9 tune problematic loops
    [Audio.pdsprj]
2022-09-17 Updated Audio DIPs with CAPs
    [Audio.pdsprj]
2022-09-19 Audio V9.2 fixes a bug observed in DebugAudio1.txt at line 2085 where the voice was incorrectly started again
    [Audio - Old.pdsprj, Audio.pdsprj]
2022-09-22 Audio V9.2
    [Audio - Placed.pdsprj, Audio - Routed - BOM.xlsx, Audio - Routed - PNP.csv, Audio - Routed.pdsprj, Bill Of Materials Audio - Routed.csv]
2022-10-10 Back plane headers moved closer together, plus extra one added with power indicator LED.
    [Bomb Jack.pdsprj]
2022-10-10 Adding thicker power traces
    [Bomb Jack.pdsprj]
2022-10-11 Moving the backplane to a separate file
    [Backplane.pdsprj]
2022-10-11 V9.0 backplane silkscreen
    [Backplane.pdsprj]
2022-10-11 Added PJ-079AH to backplane
    [Backplane.pdsprj]
2022-10-11 Adding PJ-079AH stock code
    [Backplane.pdsprj]
2022-10-11 Add backplane caps EEU-FR1E471YB
    [Backplane.pdsprj]
2022-10-11 Backplane routed
    [Backplane - Routed.pdsprj]
2022-10-22 Backplane and audio stereo separation TODO
    [Backplane - Routed - BOM.xlsx, Backplane - Routed - PNP.csv, Bill Of Materials Backplane - Routed.csv]
2022-11-02 Updating audio looping test and schematic
    [Audio.pdsprj]
2022-11-03 Audio 9.2 bug fixed and Audio 9.3 changes done. Voices always loop now.
    [Audio.pdsprj]
2022-11-03 Audio schematic tidied up, components merged, group rooms set
    [Audio.pdsprj]
2022-11-17 APU size increased with another placement keep out area
    [APU - Placed.pdsprj, APU - Routed.pdsprj, APU.pdsprj]
2022-11-17 APU 9.3
    [APU - Routed - BOM.xlsx, APU - Routed - PNP.csv, APU - Routed.pdsprj, Bill Of Materials APU - Routed.csv]
2022-11-19 Audio DRC DEFAULT rule needed to be reset
    [Audio.pdsprj]
2022-11-19 APU - Some code and supplier entries are missing from ICs
    APU and backplane old bus and userport interface
    [APU - Routed - 2.pdsprj, APU.pdsprj]
2022-11-20 APU 9.4 expanded and more placement keep out area for easier routing
    [APU - Placed.pdsprj, APU - Routed.pdsprj]
2022-12-20 APU with better memory bus contention logic
    http://127.0.0.1:8001/ace-builds-master/demo/autocompletion.html?filename=features/TestAPU.feature
    3 Scenarios (3 passed)
    117 Steps (117 passed)
    0m0.402s
    [APU.pdsprj]
2022-12-20 Tidy schematic. Disable APU raster avoidance code.
    [APU.pdsprj]
2022-12-20 Adjusted latched writes timings
    [APU.pdsprj]
2022-12-21 Update emulation: When InstrIsWaiting check (debug break/error) that there are no InternalMEWR InterceptBus operations in the previous or current instruction
2022-12-21 Replace 6116SA20TPGI with https://www.mouser.sg/ProductDetail/Renesas-Electronics/6116LA20TPG?qs=SmUuHNCnblrwZH5u1F5zAw%3D%3D
    [APU.pdsprj]
2022-12-21 Needed a bigger layout
    [APU.pdsprj]
2022-12-22 Using new data generator option for trigger
    [Bomb Jack.pdsprj]
2022-12-22 Fix for API intermittent latched data write while waiting issue
    Recon code fix
    [APU.pdsprj]
2022-12-22 APU package and stock code
    [APU.pdsprj]
2022-12-22 APU 8 layers
    [APU - Placed - Tightly 2.pdsprj, APU - Placed - Tightly.pdsprj, APU - Placed.pdsprj, APU - Routed - Tightly 2.pdsprj, APU - Routed.pdsprj, APU.pdsprj]
2022-12-23 APU 9.4
    [APU - Routed - Tightly 2 - PNP.csv, Bill Of Materials APU - Routed - Tightly 2 - BOM.xlsx, Bill Of Materials APU - Routed - Tightly 2.csv]
2022-12-25 User port breakout V1.1
    [UserPortBreakout - Routed.pdsprj, UserPortBreakout.pdsprj]
2022-12-27 Update schematic comments
    [APU.pdsprj]
2023-01-02 The real backplane board also needs model adjustment
    [Backplane.pdsprj, Bomb Jack.pdsprj]
2023-01-05 Sample data interleaving works
2023-02-02 Debugging Sprites2 board, found bug in userport 24bit address interface instead
2023-02-02 Added data recorder VSMDD1 and generator VSMDD2
    [UserPortTo24BitAddress.pdsprj]
2023-02-02 C64 userport to 24 bit addr auto++ V1.3
    [UserPortTo24BitAddress.pdsprj]
2023-02-04 Work on fixed userport interface
    [UserPortTo24BitAddress2.pdsprj]
2023-02-04 Design seems to be working
    [UserPortTo24BitAddress2.pdsprj]
2023-02-04 user port using SMT
    [SMT SMD Package test.pdsprj, UserPortTo24BitAddress2.pdsprj]
2023-02-05 Forgot to create SMTCODE
    Reverted project
    [UserPortTo24BitAddress2.pdsprj]
2023-02-05 Revert to last working
    [UserPortTo24BitAddress2.pdsprj]
2023-02-05 Remove video group and exclude the VSMDigitalData from layout
    [UserPortTo24BitAddress2.pdsprj]
2023-02-05 Missing stock codes
    [UserPortTo24BitAddress2.pdsprj]
2023-02-05 User port V1.3 SMT variant
    [Bill Of Materials UserPortTo24BitAddress2 - Routed.csv, Bill Of Materials UserPortTo24BitAddress2.csv, SMT SMD Package test.pdsprj, UserPortTo24BitAddress2 - Routed - BOM.xlsx, UserPortTo24BitAddress2 - Routed - PNP.csv, UserPortTo24BitAddress2 - Routed.pdsprj, UserPortTo24BitAddress2.pdsprj]
2023-03-10 Removed PCDelay since it really isn't used at all
    Also created test for user port
    [UserPortTo24BitAddress2.pdsprj]
2023-03-12 Remove old bugged design
    [Bill Of Materials UserPortTo24BitAddress2 - Routed.csv, UserPortTo24BitAddress2 - Routed - BOM.xlsx, UserPortTo24BitAddress2 - Routed - PNP.csv, UserPortTo24BitAddress2 - Routed.pdsprj]
2023-03-12 _PC2 renamed to _PC for the connector
    [UserPortTo24BitAddress2.pdsprj]
2023-03-12 CLK input to U10 (data register latch) and MR input to U2 (CS3 OR _PC) can be merged, U2 can use LOADTICK
    [UserPortTo24BitAddress2.pdsprj]
2023-03-12 The U2 CLK input can also probably not need the AND with BUSCLEAR, instead route BUSCLEAR to ENP
    [UserPortTo24BitAddress2.pdsprj]
2023-03-12 New design
    [UserPortTo24BitAddress2 - Placed.pdsprj, UserPortTo24BitAddress2 - Routed.pdsprj]
2023-03-17 TODO and 3D model for user port cable connector
    [SMT SMD Package test.pdsprj, UserPortTo24BitAddress2.pdsprj]
2023-03-20 Adding APU validation tests
    Also build of new boards in V9.5
    [Bill Of Materials ExpansionBusDILToDIN41612 - Routed.csv, Bill Of Materials UserPortTo24BitAddress2 - Routed - BOM.xlsx, Bill Of Materials UserPortTo24BitAddress2 - Routed.csv, ExpansionBusDILToDIN41612 - Routed - BOM.xlsx, ExpansionBusDILToDIN41612 - Routed - PNP.csv, ExpansionBusDILToDIN41612 - Routed.pdsprj, ExpansionBusDILToDIN41612.pdsprj, UserPortTo24BitAddress2 - Placed.pdsprj]
2023-03-29 Validate write timings when recording
    [APU.pdsprj]
2023-03-31 Update digital data
    [Bomb Jack.pdsprj]
2023-04-02 APU debugging with new digital data generator
    [APU.pdsprj]
2023-04-02 Extra logic analyser debugging
    [APU.pdsprj]
2023-04-03 Stable data debugging, disable for now
    [APU.pdsprj]
2023-04-24 Adding V2.0 schematic and test data
    This is to demonstrate what was very close to the original Bombjack hardware.
    [Bomb Jack - V2.0.pdsprj]
2023-04-24 Improving the V2.0 test data
    [Bomb Jack - V2.0.pdsprj]
2023-04-26 Updating the use DIGTLADATAINPUT model where needed for recording
    [APU.pdsprj, Bomb Jack.pdsprj, SimpleCPU.pdsprj, UserPortTo24BitAddress.pdsprj, UserPortTo24BitAddress2.pdsprj]
2023-04-28 Bomb Jack V9.5 APU - DIP Switch select for mem speed
    Make the latched write use a DIP switch select for clock speed. Default to twice as slow as the APU clock.
    [APU.pdsprj]
2023-04-28 APU 9.5 to include EXPANSIONBUSH1 from the ExpansionBusDILToDIN41612 but note the updated signal names from APU root sheet 2 old headers
    [APU.pdsprj]
2023-04-28 DIN board done and tested
2023-04-28 Socket orientation on silkscreen, especially for the new straight headers
    DIN header 3D model position for APU
    [APU.pdsprj, UserPortTo24BitAddress2.pdsprj]
2023-04-29 Updates for enhanced user port interface
    [SMT SMD Package test.pdsprj]
2023-05-13 Full automated test updates
    [BombJack.pdsprj, UserPortTo24BitAddress2.pdsprj]
2023-05-13 Full test pack
    [SimpleCPU.pdsprj]
2023-05-15 Video using extra BG colour register
    [BombJack - Video daughter board BGCOLOUR.pdsprj, BombJack.pdsprj]
2023-05-16 Removed: kVideo_EnableDisplay_Tiles_Enable kVideo_EnableDisplay_Tiles_BorderXShrink kVideo_EnableDisplay_Tiles_BorderYShrink
    [Bill Of Materials BombJack - Video daughter board BGCOLOUR.csv, BombJack.pdsprj]
2023-05-20 Automation notes for SMT transformation
    [APU - Placed - SMT.pdsprj]
2023-05-22 SOIC-14 -CAP variant
    [SMT SMD Package test.pdsprj, ToSMTSOIC.csv]
2023-05-23 APU to use SMT
    [APU - Not quite routed - SMT.pdsprj, APU - Placed - SMT.pdsprj, APU.pdsprj, SMT SMD Package test.pdsprj, ToSMTSOIC.csv]
2023-05-24 APU SMT updates
    [APU - Not quite routed - SMT.pdsprj, APU - Placed - SMT.pdsprj, APU.pdsprj]
2023-05-24 APU V9.5 SMT routed
    [APU - Placed - SMT.pdsprj, APU - Routed - SMT.pdsprj, APU.pdsprj]
2023-05-24 Bombjack main project updated to SMT
    Vectors and APU released
    [Bill Of Materials BombJack - Vectors - SMT - Routed.csv, BombJack - Vectors - SMT - Placed.pdsprj, BombJack - Vectors - SMT - Routed - BOM.xlsx, BombJack - Vectors - SMT - Routed - PNP.csv, BombJack - Vectors - SMT - Routed.pdsprj, BombJack - Vectors - SMT.pdsprj, BombJack.pdsprj, SMT SMD Package test.pdsprj]
2023-05-25 Audio updated to SMT
    [Audio - SMT - Placed test.pdsprj, Audio.pdsprj]
2023-05-27 U264 pin 15 on the daughter board should have been connected to USEBGCOLOUR (to U246 pin 4) (as per the main video layer)
    [BombJack - Video daughter board BGCOLOUR.pdsprj]
2023-05-27 Daughter board tested working the same as emulation (main6.a) with and without kVideo_EnableDisplay_Use_BGColour
    [BombJack - Video daughter board BGCOLOUR.pdsprj]
2023-06-17 Layer combination, move the outputs to the top edge, the inputs to the long edge
    [BombJack.pdsprj]
2023-06-20 Combiner layer - Four registers
    [BombJack.pdsprj]
2023-06-21 Programmable combinator seems to work
    [BombJack.pdsprj]
2023-06-22 Adding dithering to combination layer
    [BombJack.pdsprj]
2023-06-22 First pass layout
    [BombJack - Combiner -V9.0 - Placed.pdsprj, BombJack - Combiner -V9.0 - Routed.pdsprj, BombJack - Copy.pdsprj]
2023-06-22 V9.0 Combiner assembly
    [Bill Of Materials BombJack - Combiner -V9.0 - Routed.csv, BombJack - Combiner - V9.0 - BOM.xlsx, BombJack - Combiner -V9.0 - PNP.csv, BombJack - Combiner -V9.0 - Placed.pdsprj, BombJack - Combiner -V9.0 - Routed.pdsprj, BombJack.pdsprj]
2023-07-06 Adding Threads
2023-07-12 Combiner board edge moved in slightly
    [BombJack.pdsprj]
2023-07-16 Tidy schematic
    [BombJack.pdsprj]
2023-07-17 New merge layer schematic updated, simulation checked.
    The merged layers are one pixel to the right now.
    [BombJack - Copy (2).pdsprj, BombJack.pdsprj]
2023-07-18 Update the layer enable connections to allow the simulation to use the calculated enable flag using the merge layer visibility/enable control
    [BombJack.pdsprj]
2023-07-19 Debugging merge layer simulation and emulation
    Vectors layer layer enable needed to come from the merge layer output
    [BombJack.pdsprj]
2023-07-20 Hardware needed an output pixel latch, not input pixel latches.
    [BombJack.pdsprj]
2023-07-20 Tidy package allocations
    [BombJack.pdsprj]
2023-07-20 Added a partition to the combiner layer
    [BombJack - Combiner -V9.1 - Placed.pdsprj, BombJack - Combiner -V9.1 - Routed.pdsprj, BombJack.pdsprj]
2023-07-20 Use TestData.txt in schematic
    Clarify test instructions for new hardware
    [BombJack.pdsprj]
2023-07-24 Combiner 9.1
    [Bill Of Materials BombJack - Combiner -V9.1 - Placed.csv, BombJack - Combiner - V9.1 - Routed - BOM.xlsx, BombJack - Combiner -V9.1 - Routed - PNP.csv]
2023-07-28 Added variations for DILXX without the CAP20
    [ToSMTSOIC.csv]
2023-07-28 UserPort20To32Bit1 first pass seems to be OK
    Adding missing SMT packages with CAP
    [SMT SMD Package test.pdsprj, UserPort20To32Bit1.pdsprj]
2023-07-29 Removed the SDC cap for the RAM footprint
    Pads could change usage, so cannot assume which pads need caps.
    [SMT SMD Package test.pdsprj]
2023-07-29 Adding debug headers
    [UserPort20To32Bit1.pdsprj]
2023-07-29 JP1 jumper for C64 power ordering part and package
    [UserPort20To32Bit1.pdsprj]
2023-07-29 Added silkscreen
    [UserPort20To32Bit1.pdsprj]
2023-07-29 LED and resistor stock codes
    [UserPort20To32Bit1.pdsprj]
2023-07-31 ALATCH5 can signify DDR for reading
    [UserPort20To32Bit1.pdsprj]
2023-07-31 The direct pass-through seems to work
    however need to think about PA2 setup of bytes using the RAM read to pass-through mechanism
    [UserPort20To32Bit1.pdsprj]
2023-08-01 UserPort20To32Bit1 passes simulation checks
    [UserPort20To32Bit1.pdsprj]
2023-08-01 Adding pass-through and board slightly larger
    [UserPort20To32Bit1.pdsprj]
2023-08-01 Design placed and routed
    [UserPort20To32Bit1 - V1.0 - Placed.pdsprj, UserPort20To32Bit1 - V1.0 - Routed.pdsprj, UserPort20To32Bit1.pdsprj]
2023-08-01 UserPort20To32Bit1: Extra address add value calculation
    [UserPort20To32Bit1.pdsprj]
2023-08-02 Adding specific component replacement command line option
    [Main.java]
2023-08-02 Layout spacing for more complexity
    [UserPort20To32Bit1 - V1.0 - Placed.pdsprj, UserPort20To32Bit1.pdsprj]
2023-08-02 Changed to use: Eight layers.ltf With VIA1 VIA2 etc
    [UserPort20To32Bit1 - V1.0 - Placed.pdsprj, UserPort20To32Bit1.pdsprj]
2023-08-02 Placed and routed OK with placement keepout areas.
    [UserPort20To32Bit1 - V0.1 - Placed.pdsprj, UserPort20To32Bit1 - V0.1 - Routed.pdsprj, UserPort20To32Bit1.pdsprj]
2023-08-10 Combiner backplane connectors needed {GROUP=Combiner}
    [BombJack.pdsprj]
2023-08-22 BackplaneBridge.pdsprj
    Has the option of being routed without the debug headers in the middle resulting in a much cleaner route.
    [BackplaneBridge.pdsprj]
2023-08-23 Backplane bridge needed stock code ordering link for connectors
    [BackplaneBridge - V1.0 - BOM.xlsx, BackplaneBridge - V1.0 - PNP.csv, BackplaneBridge - V1.0 - Placed.pdsprj, BackplaneBridge - V1.0 - Routed.pdsprj, BackplaneBridge.pdsprj, Bill Of Materials BackplaneBridge - V1.0 - Routed.csv]
2023-09-01 Update the large EEU-FR1E471YB caps with proper package/footprint
    [Backplane.pdsprj, BackplaneBridge.pdsprj]
2023-09-04 PA2 reflected to PTPA2 now, when control reg lower two bits = %00
    [UserPort20To32Bit1.pdsprj]
2023-09-06 Sense change config
    [UserPort20To32Bit1.pdsprj]
2023-09-29 Mode7 SMT board work...
    [BombJack.pdsprj, Mode7 - Placed - SMT.pdsprj]
2023-09-30 Mode7 SMT layout work
    [BombJack.pdsprj, Mode7 - Placed - SMT.pdsprj, Mode7 - Routed - SMT.pdsprj]
2023-09-30 Mode7 left hand edge moved in 0.01th
    [BombJack.pdsprj, Mode7 - Routed - SMT.pdsprj]
2023-10-01 Mode7 release
    [Bill Of Materials Mode7 - Routed - SMT.csv, Mode7 - Routed - SMT - BOM.xlsx, Mode7 - Routed - SMT - PNP.csv]
2023-10-20 Update DigitalData part to match the new model build
    [Audio.pdsprj]
2023-10-31 Adding faster clock gen and new _MDL _CDL _VPL signals
    [BombJack.pdsprj]
2023-10-31 Debugging unstable scanline
    [BombJack.pdsprj]
2023-10-31 S1_LONGLINESTART to reset the scanline counters was very stable
    [BombJack.pdsprj]
2023-11-01 Sprites at 16MHz gives 8 extra full sprites
    [BombJack.pdsprj]
2023-11-01 Added 74LS682 for EBS comparison. Note the DIP switch is now to ground, so it's inversed.
    [BombJack.pdsprj]
2023-11-02 Adjusting board size for 8 layer stackup
    Components set to Sprites group
    Update order clarifications to add the package/code
    [BombJack - Sprites - V9.5 - Placed.pdsprj, BombJack - Sprites - V9.5 - Routed.pdsprj, BombJack - master.pdsprj, BombJack.pdsprj]
2023-11-02 Clock and clock select dip switch need to be located on the board edge, preferably bottom edge with obvious orientation and marking the switch options
    [BombJack.pdsprj]
2023-11-02 V9.5 sprites routed
    [BombJack - Sprites - V9.5 - Placed.pdsprj, BombJack - Sprites - V9.5 - Routed.pdsprj]
2023-11-02 Sprites scanline logic contentions removed
    [BombJack.pdsprj]
2023-11-02 Correct sheet groups to Sprites
    [BombJack.pdsprj]
2023-11-02 Need to reduce Sprites components
    [BombJack.pdsprj]
2023-11-02 Back to normal test data
    [BombJack - Sprites - V9.5 - Placed.pdsprj, BombJack - Sprites - V9.5 - Routed.pdsprj, BombJack.pdsprj]
2023-11-03 MegaWang logo (or text) for layout solder layers or silk screen
    Sprites V9.5
    [Bill Of Materials BombJack - Sprites - V9.5 - Routed.csv, BombJack - Sprites - V9.5 - PNP.csv, BombJack - Sprites - V9.5 - Placed.pdsprj, BombJack - Sprites - V9.5 - Routed - BOM.xlsx, BombJack - Sprites - V9.5 - Routed.pdsprj, BombJack.pdsprj]
2023-11-15 Added DebugUserPort20To32Bit1_PassthroughChange.txt
    [UserPort20To32Bit1.pdsprj]
2023-11-16 need to make sure that the external user port can be setup with the usual PA2 clear and external writes
    [UserPort20To32Bit1.pdsprj]
2023-11-18 LABELVALUE0=PT_PC=$10000 LABELVALUE1=PTPA2=$8000000
    [UserPort20To32Bit1.pdsprj]
2023-11-25 Fast DMA read works, just need to poll for the completed transfer now
    [UserPort20To32Bit1.pdsprj]
2023-11-25 Reading the fast DMA status latch13 seems to work
    [UserPort20To32Bit1.pdsprj]
2023-11-25 UserPort20To32Bit1 fast DMA logic analyser
    [UserPort20To32Bit1.pdsprj]
2023-11-25 Update UserPort20To32Bit1.pdsprj
    Stock code and package
    [UserPort20To32Bit1.pdsprj]
2023-11-25 Update UserPort20To32Bit1.pdsprj
    Board size
    [UserPort20To32Bit1.pdsprj]
2023-11-25 Update UserPort20To32Bit1.pdsprj
    Board size increase again
    [UserPort20To32Bit1.pdsprj]
2023-11-25 MegaWang memory expansion V0.2
    [UserPort20To32Bit1 - V0.2 - Placed.pdsprj, UserPort20To32Bit1.pdsprj]
2023-11-25 latch7_ResetDone control signal
    [UserPort20To32Bit1.pdsprj]
2023-11-25 V9.5\UserPort20To32Bit1 - V0.2 - Routed.pdsprj
    [UserPort20To32Bit1 - V0.2 - Placed.pdsprj, UserPort20To32Bit1 - V0.2 - Routed.pdsprj]
2023-11-26 UserPort20To32Bit1 : Move clocked DMA one slot later
    [UserPort20To32Bit1.pdsprj]
2023-11-26 UserPort20To32Bit1 : While in reset keep data bus driver away from user port.
    This is until latch7_ResetDone is used.
    [UserPort20To32Bit1.pdsprj]
2024-02-18 VSMDD6 Already output MWFAILINTERNAL
    [APU.pdsprj]
2024-02-18 Added: IGNOREQUEUE=1 to the digital data model
    [APU.pdsprj]
2024-03-22 Updated to include digital RGB565 colour
    Resistor ladder updates needed
    [BombJack.pdsprj, BombJackRGB444.pdsprj]
2024-03-23 NOT gate for RAM to Video group
    [BombJack.pdsprj]
2024-03-23 Use three latches, probably use three hex instead of two hex like before.
    [BombJack.pdsprj]
2024-03-23 Resistor ladders need updates...
    [BombJack.pdsprj]
2024-03-23 Back to TestData.txt
    [BombJack.pdsprj]
2024-03-23 Update schematic for R-2R and latches... Noting which latch has which colour. Removed obsolete connectors, keeping VGA, and moved the video signal output together.
    [BombJack.pdsprj]
2024-03-23 Using RAM 6264 means the parts are still in stock
    [BombJack.pdsprj]
2024-03-24 Updated to include Video PCB space partitioning for placement.
    [BombJack - Video - Placed.pdsprj, BombJack - Video - Routed.pdsprj, BombJack.pdsprj]
2024-03-24 Since the video board generates these, then the video board can repurpose the signals for the address selector
    [APU.pdsprj, Audio.pdsprj, Backplane.pdsprj, BackplaneBridge.pdsprj, BombJack.pdsprj]
2024-03-24 Compare images pass
    [BombJack.pdsprj]
2024-03-24 Video EBS0 select needs a full comparator and DIP switch
2024-03-24 Remove video clock osc and hardwire the crystal.
    [BombJack.pdsprj]
2024-03-24 Video board: Add reset line on power on with suitable IC.
    [BombJack.pdsprj]
2024-03-24 Adding asterisk for the HSYNC select dipswitch
    [BombJack.pdsprj]
2024-03-24 Moved ESB0 dipsw/comparator and reset signal gen to sheet 3
    [BombJack.pdsprj]
2024-03-25 Video: Analogue area, these digital signals are straying into the area:
    [BombJack - Video - Placed.pdsprj, BombJack.pdsprj]
2024-03-25 Video: Analogue area, these digital signals are straying into the area
    [BombJack - Video - Placed.pdsprj, BombJack - Video - Routed.pdsprj, BombJack.pdsprj]
2024-03-26 Added an optional DSW13 for VIDPOWRESET to LOCALVIDPOWRESET or to choose 5V
    [BombJack.pdsprj]
2024-03-29 Used Bombjack\MegaWang 2000 Turbo Edition logo.bmp
    [BombJack - Video - Placed.pdsprj, BombJack - Video - Routed.pdsprj, BombJack.pdsprj]
2024-03-29 Video V10
    [Bill Of Materials BombJack - Video - Routed.csv, BombJack - Video - Placed.pdsprj, BombJack - Video - Routed - BOM.xlsx, BombJack - Video - Routed - PNP.csv, BombJack - Video - Routed.pdsprj]
2024-05-11 UserPort20To32Bit1: RAM write logs
    [UserPort20To32Bit1.pdsprj]
2024-05-11 Fix the written bytes
    [UserPort20To32Bit1.pdsprj]
2024-05-11 Checked latch7_InternalPA2 during fast DMA
2024-05-19 Fast DMA validation
2024-05-19 Adding stable signal checks to the recorders
    [UserPort20To32Bit1.pdsprj]
2024-05-24 U54 FTDI UM245R added to the schematic, with footprint, and FTDI signal names
    [UserPort20To32Bit1.pdsprj]
2024-07-13 Add a suitable wiped 24 pin socket stock code to U54 for the FTDI part
    [UserPort20To32Bit1.pdsprj]
2024-07-13 The link the to device is now in the SUPPLIER section
    [UserPort20To32Bit1.pdsprj]
2024-07-13 DDR moved to D28
    [UserPort20To32Bit1.pdsprj]
2024-07-13 FTDI data signals added
    _PC moved to D29
    [UserPort20To32Bit1.pdsprj]
2024-07-13 FTDI Signal names
    [UserPort20To32Bit1.pdsprj]
2024-07-13 Update design notes for FTDI
    [UserPort20To32Bit1.pdsprj]
2024-07-14 Adding FTDI nybble latching logic
    [UserPort20To32Bit1.pdsprj]
2024-07-15 Populate FTDI override signals
    [UserPort20To32Bit1.pdsprj]
2024-07-15 Stop the UD0 related transceivers from working using FTDI_USE as an input for _CE
    [UserPort20To32Bit1.pdsprj]
2024-07-16 Verifying the FTDI read pulse timings
    [UserPort20To32Bit1.pdsprj]
2024-07-19 Added a couple of demux and a driver to handle the signals when FTDI_USE is enabled and the inverted _FTDI_USE
    [UserPort20To32Bit1.pdsprj]
2024-07-19 Need some tests for the FTDI signals
    [UserPort20To32Bit1.pdsprj]
2024-07-20 Check another byte is written from the FTDI device to the RAM
    [UserPort20To32Bit1 - Routed.pdsprj, UserPort20To32Bit1.pdsprj]
2024-07-20 Extra VIA DRC rooms around the FTDI socket pins and OSC socket
    [UserPort20To32Bit1 - V0.2 - Routed.pdsprj, UserPort20To32Bit1.pdsprj]
2024-07-20 Added MegaWang logo on silkscreen
    [UserPort20To32Bit1 - V0.2 - Routed.pdsprj, UserPort20To32Bit1.pdsprj]
2024-07-21 Disconnect VIO from VCC since the jumpers do this
    [UserPort20To32Bit1.pdsprj]
2024-07-21 Final V0.2 files
    [Bill Of Materials UserPort20To32Bit1 - V0.2 - Routed.csv, UserPort20To32Bit1 - Routed.pdsprj, UserPort20To32Bit1 - V0.2 - Routed - BOM.xlsx, UserPort20To32Bit1 - V0.2 - Routed - PNP.csv, UserPort20To32Bit1 - V0.2 - Routed.pdsprj, UserPort20To32Bit1.pdsprj]
2024-08-15 Debugging DMA
2024-08-16 Updating tests for latch 13 DMA Should complete here
2024-10-11 TestUserPortTo24BitAddress2 and UserPort20To32Bit2
    [UserPort20To32Bit2.pdsprj]
2024-10-11 Instead of U61 enable E1 being set and reset by sending two bytes, it can come from a new signal two ticks after FTDIByteLatch
    [UserPort20To32Bit2.pdsprj]
2024-10-11 Instead of U61 and U60 using 2 latch signals and only 4 data signals, it would be possible to use 7 data signals and 1 latch bank selector
    [UserPort20To32Bit2.pdsprj]
2024-10-11 perhaps even removing the need to U60.
    [UserPort20To32Bit2.pdsprj]
2024-10-11 Check _FTDIRD for transient false posiive signals
    [UserPort20To32Bit2.pdsprj]
2024-10-12 Layout: MegaWang memory expansion V2.0
    [UserPort20To32Bit2.pdsprj]
2024-10-12 Adding FTDICLK and DMACLK DIP switches.
    [UserPort20To32Bit2.pdsprj]
2024-10-12 Added DSW3 to configure an earlier low _FTDIRD based on the FTDI counter schedule (LSB), or to remove the least significant bit (Off)
    [UserPort20To32Bit2.pdsprj]
2024-10-12 Ensure debug headers expose the new signals for data reading, latching etc
    [UserPort20To32Bit2.pdsprj]
2024-10-12 Create UserPort20To32Bit2 - V2.0 - Routed.pdsprj
    [UserPort20To32Bit2 - V2.0 - Routed.pdsprj]
2024-10-13 UserPort20To32Bit2 - V2.0 - Routed and Python data send code
    [Bill Of Materials UserPort20To32Bit2 - V2.0 - Routed.csv, UserPort20To32Bit2 - V2.0 - Routed - BOM.xlsx, UserPort20To32Bit2 - V2.0 - Routed - PNP.csv]
2024-10-21 Seems to be 111 sprites with current sprite pattern
2024-11-05 Sample demo with new user port interface
2025-02-13 Adding device CY62138FLL
    [CY62138FLL.pdsprj]
2025-02-13 Start of Sprites4 work, the frame buffers seem to be working
    [Bomb Jack - Sprites2 - Placed SMT.pdsprj, BombJack - Before Sprites4.pdsprj, BombJack.pdsprj]
2025-02-13 Getting there...
    [BombJack.pdsprj, CY62138FLL.pdsprj]
2025-02-14 Adding registers
    [BombJack.pdsprj]
2025-02-15 Add latches for the first 8 registers
    [BombJack.pdsprj]
2025-02-15 Increment sprite reading address every byte, since a sprite is not a power of 2 bytes anymore
    [BombJack.pdsprj]
2025-02-15 Testing sprite fetching from registers into work registers and end of list logic
    [BombJack.pdsprj]
2025-02-16 currentSpriteXPixel currentSpriteYPixel S4MultiplyResult currentSpriteXWorking S4EnableXPosCount
    [BombJack.pdsprj]
2025-02-17 fetchingH/fetchingV logic implemented, with left/top border adjust
    [BombJack.pdsprj]
2025-02-17 Fixing the multiply result lookup
    [BombJack.pdsprj]
2025-02-17 S4NextSpriteRow trigger from currentSpriteSizeXWorking S4currentSpriteSizeXWorkingIsZero
    [BombJack.pdsprj]
2025-02-17 currentSpriteSizeY working value and sprite list parsing in memory done
    [BombJack.pdsprj]
2025-02-17 Created S4_disablePixelOutput
    [BombJack.pdsprj]
2025-02-17 First sprite pixel display test with TestData_ScaledSprites4.txt matches emulation
    [BombJack.pdsprj]
2025-02-18 Build notes
    [BombJack - Sprites4 - Placed.pdsprj]
2025-02-18 Added extra state S4_JustBeforeDrawingPixels2 and reduced EPROM access time to 45ns
    [BombJack.pdsprj]
2025-02-18 Register S4RAMIsReady => S4triggerBufferSwap
    [BombJack.pdsprj]
2025-02-18 Exact EBBS matching
    [BombJack.pdsprj]
2025-02-18 Double buffered sprite RAM seems to work
    [BombJack.pdsprj]
2025-02-18 Debug notes
    [BombJack - Sprites4 - Placed.pdsprj, BombJack - Sprites4 - Routed.pdsprj]
2025-02-19 Fixed by adding a S4FetchingH.. latch on 6MHz
    [BombJack.pdsprj]
2025-02-19 Add debug for S4FetchingH/S4FetchingV
    [BombJack.pdsprj]
2025-02-19 S2SPRENABLE needs to be one the final pixel output
    [BombJack.pdsprj]
2025-02-19 Adding debug layer bus signals
    [BombJack.pdsprj]
2025-02-19 More debug signals
    [BombJack.pdsprj]
2025-02-19 Setup for debug
    [BombJack.pdsprj]
2025-02-19 S2_LOGICRESET (not Sprite2Enable) needs to be on the final pixel output
    [BombJack.pdsprj]
2025-02-19 Removing spurious writes with extra timing logic
    [BombJack.pdsprj, CY62138FLL.pdsprj]
2025-02-20 Removing the pixel output clock's reset signal improves the output stability
    [BombJack.pdsprj]
2025-02-22 S4_advanceSprite0 Works: if ( ((currentSpriteY/2) & 0xff) >= extentYPos && (((currentSpriteY + currentSpriteSizeY)/2) & 0xff) >= extentYPos)
    [BombJack.pdsprj]
2025-02-22 Merged two output pixel counters into one S4currentSpriteX[0..8]
    [BombJack.pdsprj]
2025-02-22 Also checked with S4_JustBeforeDrawingPixels
    [BombJack.pdsprj]
2025-02-23 S4_advanceSprite1 Works: if ( ((currentSpriteX/2) & 0xff) >= extentXPos && (((currentSpriteX + currentSpriteSizeX)/2) & 0xff) >= extentXPos)
    [BombJack.pdsprj]
2025-02-23 S4advanceSprite2 Works: if ( ((currentSpriteXWorking/2) & 0xff) >= extentXPos && ((currentSpriteX/2) & 0xff) < extentXPos)
    Needed extra fixes for the position and sprite width 256 and 257
    [BombJack.pdsprj]
2025-02-24 Layer enable should only affect final output. Not calculation.
    [BombJack.pdsprj]
2025-02-24 Expand the board a bit for the new clip logic
    [BombJack - Sprites4 - Placed.pdsprj, BombJack.pdsprj]
2025-02-24 VIA label. Decoupling caps placement
    [BombJack - Sprites4 - Placed.pdsprj, BombJack.pdsprj]
2025-02-24 Placed before route
    [BombJack - Sprites4 - Placed2.pdsprj]
2025-02-25 Grouping ICs
    [BombJack - Sprites4 - Placed.pdsprj, BombJack - Sprites4 - Placed2.pdsprj, BombJack.pdsprj]
2025-02-25 PCB Layout
    [BombJack - Sprites4 - Placed.pdsprj, BombJack - Sprites4 - Placed2.pdsprj, BombJack - Sprites4 - Routed.pdsprj, BombJack.pdsprj]
2025-02-25 Sprites4 V10.0
    [Bill Of Materials BombJack - Sprites4 - Routed.csv, BombJack - Sprites4 - Placed.pdsprj, BombJack - Sprites4 - Placed2.pdsprj, BombJack - Sprites4 - Routed - BOM.xlsx, BombJack - Sprites4 - Routed - PNP.csv, BombJack - Sprites4 - Routed.pdsprj, BombJack.pdsprj, CY62138FLL.pdsprj]
2025-02-27 74LS258 temporarily changed to DIL16CAP20
    https://www.mouser.sg/ProductDetail/Texas-Instruments/SN74LS258BN?qs=SL3LIuy2dWzB02N5xNq5bw%3D%3D
    [BombJack - Sprites4 - Placed.pdsprj, BombJack - Sprites4 - Placed2.pdsprj, BombJack - Sprites4 - Routed.pdsprj]
2025-02-28 Tidy schematic and kHardwareTest_UsingSprites4
    [BombJack.pdsprj]
2025-02-28 kBus24Bit_Sprites4_EBBS = $05
    [BombJack.pdsprj]
2025-03-06 External digital display
    [BombJack.pdsprj, Test build Proteus 9 APU - Placed.pdsprj, Test build Proteus 9 APU - Routed.pdsprj, Test build Proteus 9 APU.pdsprj]
2025-03-15 74LS258 temporarily changed to DIL16CAP20
    [BombJack - Sprites4 - Routed - PNP.csv]
2025-03-18 Fixed emulation of DMA
2025-03-21 Add video logic for background RGB connector
    [BombJack.pdsprj]
2025-03-21 2MB Bitmap RGB memory works
    [BombJack.pdsprj]
2025-03-21 BitmapRGB extra address and X/Y scroll registers load work
    [BombJack.pdsprj]
2025-03-21 Bitmap RAM almost works, but there are some logic contentions
    [BombJack.pdsprj]
2025-03-21 Added logic to disable RGB bitmap RAM outputs if the functionality is not enabled
    [BombJack.pdsprj]
2025-03-21 Remove netlist errors due to probes
    [BombJack.pdsprj]
2025-03-23 Debugging transient pixel issue
    [Bill Of Materials BombJack - Sprites4 - Routed - full BOM.csv]
2025-03-23 OUTLATCHCLK and DSW16 and DSW17
    [BombJack.pdsprj]
2025-03-23 Dip switch choice for output pixel latches
2025-03-23 Back to 6MHz raw for final pixel latch
    [BombJack.pdsprj]
2025-03-23 BitmapRGB DSW18 1 = logic 2 = GND
    [BombJack.pdsprj]
2025-03-24 Placed three ADA4430-1YKSZ-R7 with DIPSW-2 to choose the outputs with a disable DIPSW-2 to ground
    And 75ohm series output resistors
    [BombJack.pdsprj]
2025-03-24 And decoupling caps
    [BombJack.pdsprj]
2025-03-24 Added extra data generator
    [BombJack.pdsprj]
2025-03-25 Remove the added DIP switches.
    [BombJack.pdsprj]
2025-03-27 currentSpriteSizeY logic comment
    [BombJack.pdsprj]
2025-04-04 Tidy Sprites4 test data
    [BombJack.pdsprj]
2025-04-04 Removed the OR gate tree and replaced with a comparator, fixing the S4currentSpriteSizeXWorkingIsZero issue
    [BombJack.pdsprj]
2025-04-05 Removed Y sprite size OR gate tree and replaced with a comparator, but without an extra latch.
    [BombJack.pdsprj]
2025-04-05 BackgroundRGB layout
    [BombJack.pdsprj]
2025-04-05 Moved RGB connector label onto the PCB
    [BombJack.pdsprj]
2025-04-08 Sprites4: Overclocking tests
    [BombJack.pdsprj]
2025-04-08 Sprites4: Done as signal _S4DataOE, no DIP switch
    [BombJack.pdsprj]
2025-04-08 Div 2 and div 4 clock divider DIP switch option for Sprites4
    [BombJack.pdsprj]
2025-04-09 Sprites4: Put divider near clock
    [BombJack.pdsprj]
2025-04-09 Sprites4 V11 - Overclocking
    [Bill Of Materials BombJack - Sprites4 - Routed 2 - BOM.xlsx, Bill Of Materials BombJack - Sprites4 - Routed 2.csv, BombJack - Sprites4 - Placed 2.pdsprj, BombJack - Sprites4 - Routed 2 - PNP.csv, BombJack - Sprites4 - Routed 2.csv, BombJack - Sprites4 - Routed 2.pdsprj]
2025-04-10 Proteus 9 testing
    [CY62138FLL Proteus 9.pdsprj]
2025-05-15 _EXTCS8800 => _SP4EXTCS8800
    [BombJack.pdsprj]
2025-05-26 Proteus V9
    [BombJack - Proteus V8.pdsprj, BombJack.pdsprj]
2025-05-26 Proteus V9 MegaWang V11.1 Sprites4
    [BombJack.pdsprj]
2025-05-26 Applied stackup, power plnes, and created VIA1/2/3 rooms around the through hole components
    [BombJack - Sprites4 - Placed.pdsprj]
2025-05-27 Sprites4 V11.1
    [Bill Of Materials BombJack - Sprites4 - Routed 2.ods, Bill Of Materials BombJack - Sprites4 - Routed.csv, BombJack - Sprites4 - Placed.pdsprj, BombJack - Sprites4 - Placed2.pdsprj, BombJack - Sprites4 - Routed - PNP.csv, BombJack - Sprites4 - Routed.pdsprj]
2025-05-30 Tidy the Sprites4 calculation logic sheet
    Just positions, no logic changes.
    [BombJack.pdsprj]
2025-05-30 Sprites4 schematic tidy, no logic change
    [BombJack.pdsprj]
2025-06-02 Palette layers expansion work: kBus24Bit_VideoLayer_ExpandedPaletteLayer kBus24Bit_VideoLayer_PaletteLayers
    [BombJack.pdsprj]
2025-06-13 Placed JP1/JP2/JP3 to allow resistor experiments
    [BombJack.pdsprj]
2025-06-13 Video V11.0 (the palette layers and extra filtering and RGB background) version
    [Bill Of Materials BombJack - Video - Routed.csv, Bill Of Materials BombJack - Video - Routed.ods, BombJack - Video - Placed 2.pdsprj, BombJack - Video - Placed.pdsprj, BombJack - Video - Routed - PNP.csv, BombJack - Video - Routed.pdsprj, BombJack.pdsprj]
2025-06-24 Create Bill Of Materials BombJack - Sprites4 - Routed ind.csv
    [Bill Of Materials BombJack - Sprites4 - Routed ind.csv]
2025-08-21 V11.0 BackgroundRGB
    [Bill Of Materials BombJack - BackgroundRGB - Routed.csv, BombJack - BackgroundRGB - Placed.pdsprj, BombJack - BackgroundRGB - Placed2.pdsprj, BombJack - BackgroundRGB - Routed - BOM.xlsx, BombJack - BackgroundRGB - Routed - PNP.csv, BombJack - BackgroundRGB - Routed.pdsprj]
2025-09-10 Added decoupling caps for the RGB layer RAMs
    [BombJack.pdsprj]
2025-09-18 BackgroundRGB: Debug pads, to help debug any memory write or other logic issues
    [BombJack.pdsprj]
2025-09-18 Placement room fingers moved left to the DIP switches
    [BombJack - BackgroundRGB - Placed.pdsprj, BombJack.pdsprj]
2025-09-18 BackgroundRGB V11.1
    [Bill Of Materials BombJack - BackgroundRGB - Routed.csv, Bill Of Materials BombJack - BackgroundRGB - Routed.xlsx, BombJack - BackgroundRGB - Placed2.pdsprj, BombJack - BackgroundRGB - Routed.pdsprj, BombJack - BackgroundRGB - Routed_Base Design PNP.csv]
2025-09-24 Chars: EBS comparator and bank select
    [BombJack.pdsprj]
2025-09-24 Chars V11.1
    [BombJack.pdsprj]
2025-09-30 Audio2 start, mostly hacking out Audio1 board stuff
    [Audio2.pdsprj]
2025-09-30 Audio2: Memory write seems to work
    [Audio2.pdsprj]
2025-09-30 Ticking works
    [Audio2.pdsprj]
2025-09-30 AUDCLKREAL = 4MHz
    [Audio2.pdsprj]
2025-09-30 Audio2: Seems to output sample data
    [Audio2.pdsprj]
2025-09-30 Output verified with debug recording
    [Audio2.pdsprj]
2025-09-30 Audio2: Component tidy
    [Audio2.pdsprj]
2025-09-30 Add debug headers
    [Audio2.pdsprj]
2025-09-30 Audio2: Board size
    [Audio2.pdsprj]
2025-09-30 Audio2: DRC rooms
    [Audio2.pdsprj]
2025-09-30 Audio2: Smaller board
    [Audio2.pdsprj]
2025-09-30 Adjust keepouts
    [Audio2.pdsprj]
2025-09-30 Audio2: Adjust cap placement
    [Audio2.pdsprj]
2025-09-30 Audio2 test build
    [Audio2 - Placed.pdsprj, Audio2 - Routed.pdsprj]
2025-10-02 Audio2: Increase rate range 62.5KHz is the maximum
    Add power on reset
    Add extra debug signals
    Improve mixing output
    [Audio2.pdsprj]
2025-10-02 Audio2: Reset PCB
    [Audio2.pdsprj]
2025-10-02 Audio2 build
    [Audio2 - Placed.pdsprj, Audio2 - Routed.pdsprj, Audio2 - Routed_Base Design - PNP.csv, Audio2.pdsprj, Bill Of Materials Audio2 - Routed.csv, Bill Of Materials Audio2 - Routed.xlsx]
2025-10-19 MegaWang V12.0 Backplane: Needs more power jacks and slots and large caps
    [Backplane.pdsprj, Backplane_Base Design PNP.csv, Bill Of Materials Backplane.csv, Bill Of Materials Backplane.xlsx]
2025-12-29 Rotate the user port schematic part
    [UserPort20To32Bit2.pdsprj, UserPortBreakout.pdsprj]
2026-01-05 C64 Ultimate digital filter for _PC
    [Bill Of Materials C64UltimateDigitalFilter-Routed.csv, Bill Of Materials C64UltimateDigitalFilter-Routed.xlsx, C64UltimateDigitalFilter-Routed.pdsprj, C64UltimateDigitalFilter-Routed_Base Design-PNP.csv, C64UltimateDigitalFilter.pdsprj]
2026-01-18 C64UltimateDigitalFilter V2.0 - _PC SP1 SP2 ATN are now all filtered
    [Bill Of Materials C64UltimateDigitalFilter V2.0 - Routed.csv, Bill Of Materials C64UltimateDigitalFilter V2.0 - Routed.xlsx, C64UltimateDigitalFilter V2.0 - Routed.pdsprj, C64UltimateDigitalFilter V2.0 - Routed_Base Design.csv, C64UltimateDigitalFilter.pdsprj]
2026-01-22 Audio3 work
    [Audio3.pdsprj]
2026-01-25 Test data preparation
    [Audio3.pdsprj]
2026-02-17 Digital filter V3.0 adding more connectors and PA2 filter
    [Bill Of Materials C64UltimateDigitalFilter V3.0 Routed.csv, Bill Of Materials C64UltimateDigitalFilter V3.0 Routed.xlsx, C64UltimateDigitalFilter V3.0 Routed.pdsprj, C64UltimateDigitalFilter V3.0 Routed_Base Design - PNP.csv, C64UltimateDigitalFilter.pdsprj]
2026-02-22 Adding bit shifter logic
    [Audio3.pdsprj]
2026-02-25 numBitsLoop and numBits comparator
    [Audio3.pdsprj]
2026-02-25 Active when FetchSample=1
    [Audio3.pdsprj]
2026-02-25 Signed to unsigned sample conversion.
    [Audio3.pdsprj]
2026-02-25 Debugging numBits calculation
    [Audio3.pdsprj]
2026-02-26 numBits counting seems to work
    [Audio3.pdsprj]
2026-02-27 Adding extra debug
    [Audio3.pdsprj]
2026-03-01 Moved schematics sections
    [Audio3.pdsprj]
2026-03-01 Adding _calcDelta[0..
    [Audio3.pdsprj]
2026-03-01 Starting to add delta calculation logic
    [Audio3.pdsprj]
2026-03-01 _getDeltaBit logic
    [Audio3.pdsprj]
2026-03-01 Delta calculation logic from thisOutputBit
    [Audio3.pdsprj]
2026-03-01 While testing delta calc
    [Audio3.pdsprj]
2026-03-01 Bug fix delta shifter reg
    [Audio3.pdsprj]
2026-03-01 Shifter reg to shift left with current bit, not the next bit
    [Audio3.pdsprj]
2026-03-01 Delta calc bug fix
    [Audio3.pdsprj]
2026-03-02 Delta with sign accumulation and output sample stage. Needs debugging.
    [Audio3.pdsprj]
2026-03-02 Wider clock
    [Audio3.pdsprj]
2026-03-02 Debugging the bit steam
    [Audio3.pdsprj]
2026-03-02 Bit stream reading fixed
    [Audio3.pdsprj]
2026-03-02 thisOutputBit reading sequence works
    [Audio3.pdsprj]
2026-03-02 Delta decode and accumulate tests
    [Audio3.pdsprj]
2026-03-03 Output from output\DebugAudio3Output.txt matches python unit test expectedDecompressedData
    [Audio3.pdsprj]
2026-03-03 FetchSample added to logic analyser
    [Audio3.pdsprj]
2026-03-03 V12.0 Audio3 and wider board
    [Audio3.pdsprj]
2026-03-03 remove the logic for signed to unsigned conversion and include that in an updated output stage instead
    [Audio3.pdsprj]
2026-03-03 Audio3 at 20MHz
    [Audio3.pdsprj]
2026-03-04 -ve edge for _clearCalculateSampleInternals
    [Audio3.pdsprj]
2026-03-04 Added _endClkSchedule on U99 Y5 to reset the clk sequence earlier
    37313.432835821 Hz
    [Audio3.pdsprj]
2026-03-04 Tested music output with proper max rate of 37313.432835821 Hz
2026-03-04 Adding debug header signals
    [Audio3.pdsprj]
2026-03-04 Audio3 V12.0 routed
    [Audio3 - Placed.pdsprj, Audio3 - Routed.pdsprj, Bill Of Materials Audio3 - Routed.csv]
2026-03-04 Generate output BOM xlsx from CSV
    [Bill Of Materials Audio3 - Routed.csv.xlsx]
2026-03-04 Gerber and PNP
    [Audio3 - Routed.pdsprj, Audio3 - Routed_Base Design.csv]
2026-04-04 More digital filter work
    [Bill Of Materials C64UltimateDigitalFilter - Routed.csv, Bill Of Materials C64UltimateDigitalFilter - Routed.csv.xlsx, C64UltimateDigitalFilter - Routed.pdsprj, C64UltimateDigitalFilter - Routed_Base Design.csv, C64UltimateDigitalFilter.pdsprj]
2026-04-05 Use the low clock to enable the output of the 74138 schedulers
    [Audio3.pdsprj]
2026-04-06 Added extra clock and state guarding to avoid the comparison triggering too early
    [Audio3.pdsprj]
2026-04-06 Now total 4MB not 2MB
    [Audio3.pdsprj]
2026-04-06 No timing adjustment needed, in simulation
    [Audio3.pdsprj]
2026-04-06 Decoupling cap traces
    [Audio3 - Placed.pdsprj, Audio3 - Routed.pdsprj, Audio3.pdsprj]
2026-04-06 Audio group
    [Audio3.pdsprj]
2026-04-09 _endClkSchedule and other CLKX uses AUDCLKREAL on the enable
    Extra logic analyser
    [Audio3.pdsprj]
2026-04-09 Extra logic analysers
    [Audio3.pdsprj]
2026-04-09 More logic analysers
    [Audio3.pdsprj]
2026-04-09 Signal debugging
    [Audio3.pdsprj]
2026-04-09 Remove unneeded voice control 8 bit latch
    [Audio3.pdsprj]
2026-04-09 _calcNumBits0 time range uses latch
    [Audio3.pdsprj]
2026-04-09 _duringCalculatingDeltaPre replaced with _calcDelta0 < _calcDelta8 ranged latch
    [Audio3.pdsprj]
2026-04-09 Reduce logic analysers
    [Audio3.pdsprj]
2026-04-09 Extra debug header
    [Audio3.pdsprj]
2026-04-09 Adding extra clock guards to state latches
    [Audio3.pdsprj]
2026-04-09 Audio3 V13.0
    [Audio3 - Placed.pdsprj, Audio3 - Routed.pdsprj, Audio3 - Routed_Base Design.csv, Audio3.pdsprj, Bill Of Materials Audio3 - Routed.csv, Bill Of Materials Audio3 - Routed.csv.xlsx]
2026-05-09 Rotate schematic debug headers to match layout
    [Audio3.pdsprj]
2026-05-09 Debug GND
    [Audio3.pdsprj]
2026-05-16 _getNextBit isn't on a debug header...
    [Audio3.pdsprj]
2026-05-16 Adding logic analysers
    [Audio3.pdsprj]
2026-05-16 Adding CLK to the logic analyser
    [Audio3.pdsprj]
2026-05-16 Added _EnableCalcStates and associated logic to only enable the voice calc states when they are not changing
    [Audio3.pdsprj]
2026-05-16 Fix the CLK0 pulse timing
    [Audio3.pdsprj]
2026-05-16 Added extra debug signals
    [Audio3.pdsprj]
2026-05-17 When the voice is active sample memory writes will fail
    [Audio3.pdsprj]
2026-05-17 Adding extra CLK debug
    [Audio3.pdsprj]
2026-05-17 Reduce AUDOE logic
    [Audio3.pdsprj]
2026-05-17 Clock guarding for: VoiceRateTick
    [Audio3.pdsprj]
2026-05-17 _loadSampleOut masks CLK0 again
    [Audio3.pdsprj]
2026-05-17 Fix first output sample load
    [Audio3.pdsprj]
2026-05-17 Update Audio3 routed.pdsprj
    [Audio3 routed.pdsprj]
2026-07-30 _getNextBit added to logic analyser general signals
    [Audio3.pdsprj]
2026-08-01 Make the length check finally only active when _VoiceIsActive
    [Audio3.pdsprj]
2026-08-02 Make AUDOE rely on voice active, not _EBSActive, or make it GND
    [Audio3.pdsprj]
2026-08-02 Reorganise the RAM isolation, using only 74LS373 and SAMPD, to reduce latency of input data. The LS245s can be removed, since _CS1 can be used.
    [Audio3.pdsprj]
2026-08-02 Add SAMPD debug output, expand AUDA debug output
    Edge debug removed and shifted to headers
    [Audio3.pdsprj]
2026-08-02 Clock stablise _BufferEmpty, add debug output
    Unit test abd music test work
    [Audio3.pdsprj]
2026-08-02 Bit shift debug
    [Audio3.pdsprj]
2026-08-03 Adjusting debug header layout
    [Audio3.pdsprj]
2026-08-03 Adjust layout for spacing, it routes
    [Audio3 - Routed.pdsprj, Audio3.pdsprj]
2026-08-03 Smaller board, adjust layout
    [Audio3.pdsprj]
2026-08-04 Audio3 V13.2
    [Audio3 - Routed.pdsprj, Audio3 - Routed_Base Design.csv, Bill Of Materials Audio3 - Routed.csv, Bill Of Materials Audio3 - Routed.csv.xlsx]
2026-08-05 APU: Fix kAPU_Reset_PC | kAPU_SkipIfEQ
    [APU.pdsprj]
2026-08-07 APU V14.0 6116 RAM replaced with 6264
    [APU.pdsprj]
2026-08-08 APU: Precise EBBS tests
    [APU.pdsprj]
2026-08-08 TestAPU4 feature
    [APU.pdsprj]
2026-08-08 APU use VIDPOWRESET on VIDEOP1 B15 from the video board
    [APU.pdsprj]
2026-08-08 APU Square the bus arbitration clocking, using a latch.
    [APU.pdsprj]
2026-08-08 APU Configurable dip-switch DSW3 for _MEWRSLOT and _LATCHEDWRITEPulse selection.
    [APU.pdsprj]
2026-08-08 LatchedWriteDesired uses _RESET
    [APU.pdsprj]
2026-08-08 Larger board
    [APU.pdsprj]
2026-08-09 Unused signal
    [APU.pdsprj]
2026-08-11 Simplify but not remove: _INSTRRAMOE
    [APU.pdsprj]
2026-08-11 Tidy components
    [APU.pdsprj]
2026-08-11 APU V14.0
    [APU - Routed.pdsprj, APU - Routed_Base Design.csv, APU.pdsprj, Bill Of Materials APU - Routed.csv, Bill Of Materials APU - Routed.csv.xlsx]
2026-08-30 Centroid file processing to add decoupling caps
    [APU - Routed_Base Design.csv_caps.csv, Bill Of Materials APU - Routed.csv.xlsx, WithDecouplingOrientation.pdsprj, WithDecouplingOrientation_Base Design.csv]
2026-08-31 Actually latched the output of the 74273 counters before the demux
    Now _clearCalculateSampleInternals = 31.4 microseconds = 31847 Hz
    Also added LoadFinalOutputSample
    [Audio3.pdsprj]
2026-08-31 Bump version
    [Audio3.pdsprj]
2026-09-28 Improved the APU tests. Improved the counter/demux for external memory writes
    [APU.pdsprj]
2026-09-29 Improve the output cache write with latching.
    [APU.pdsprj]
2026-09-29 MEMORYSLOTS provides a view of the different _MEWRSLOT0..3 and _LATCHEDWRITEPulse0..3 options
    [APU.pdsprj]
2026-10-02 The instruction scheduler and write slot now use a latch.
    Improve tests: Validates memory accesses contain the expected data after a single pass
    [APU.pdsprj]
2026-10-03 Added debug _DBG9800WEERROR breakpoint on recorder
    [APU.pdsprj]
2026-10-03 Improving APU speed
    [APU-Old.pdsprj, APU.pdsprj]
2026-10-03 DSW3 preferred memory slot
    [APU.pdsprj]
2026-10-03 Back TestDataAPU2.txt
    [APU.pdsprj]
