martinpiper/BombJack/(notices)

Notices in the files:
PiJack/WiringPi-master/wiringPi/wiringPi.c:
wiringPi is free software: you can redistribute it and/or modify
it under the terms of the GNU Lesser General Public License as
published by the Free Software Foundation, either version 3 of the
License, or (at your option) any later version.
PiJack/WiringPi-master/wiringPi/wiringPi.h:
it under the terms of the GNU Lesser General Public License as published by
the Free Software Foundation, either version 3 of the License, or
(at your option) any later version.
